HTheolin/Dinghy_old/D7039E och E7025E/Hårdvara/Schematics-Layouts/roder_dipswitch_config.jpg

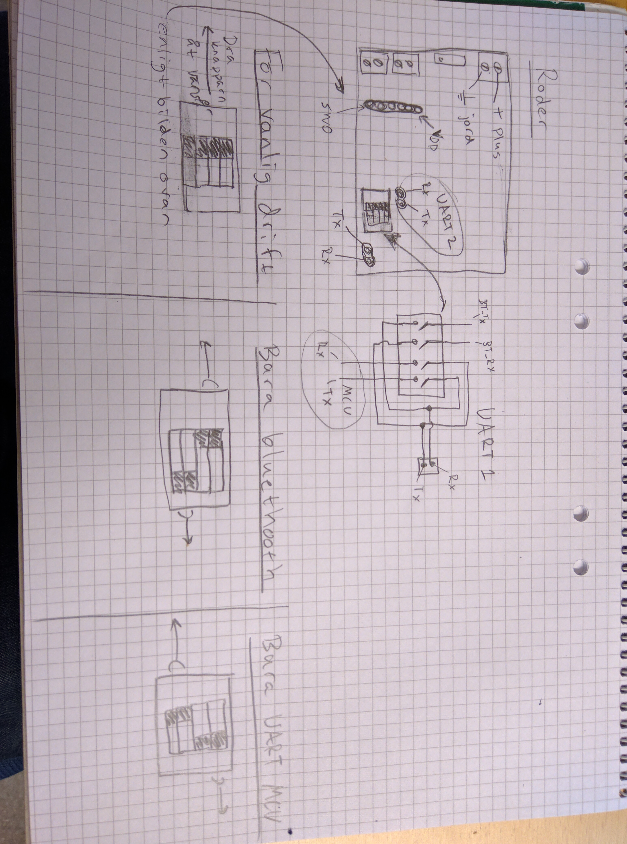
D7039E och E7025E/Hårdvara/Schematics-Layouts/roder_dipswitch_config.jpg
