HTheolin/Dinghy_old/D7039E och E7025E/Dokumentation/Moddeller och UML/Android/IMG_0293.JPG

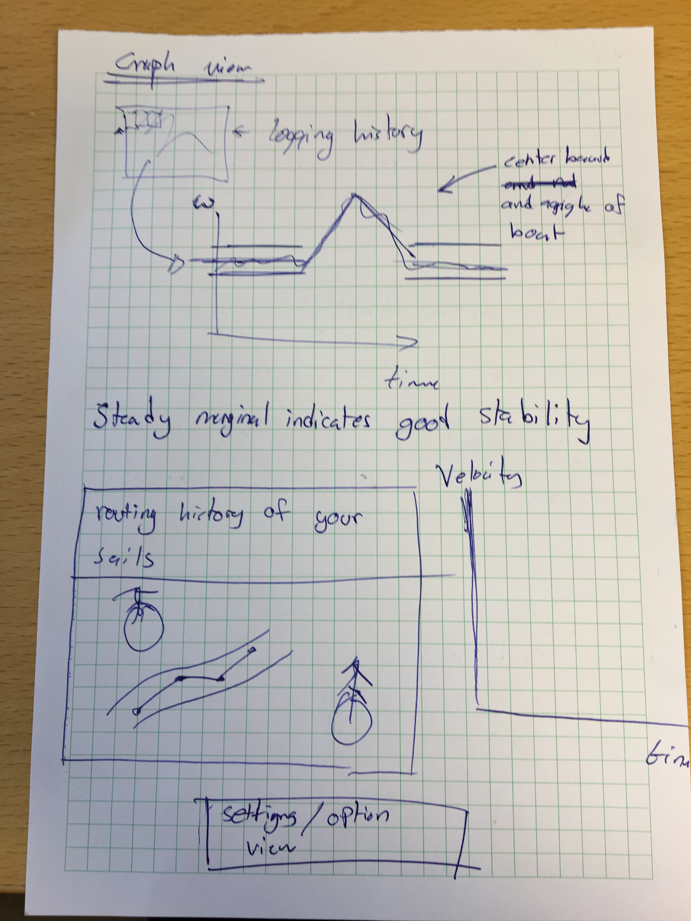
D7039E och E7025E/Dokumentation/Moddeller och UML/Android/IMG_0293.JPG
