HTheolin/Dinghy_old/D7039E och E7025E/Hårdvara/Schematics-Layouts/Pin description MCU/Prototype 2/Mainboard PROTOTYP2 Pinbeskrivnin.docx

OBSERVERA!!!

Ström switch On/Off har följande polaritet:

- Fotosensor / Strain gauge / Pressure sensor

GPIO hög (1) stänger AV strömmen

GPIO låg (0) slår PÅ strömmen

- Batterimätning

GPIO hög (1) slår PÅ strömmen

GPIO låg (0) stänger AV strömmen

Bluetooth / IMU sparar ström genom en intern sleep funktion så dom har ej någon power supply

Switch som går att slå på/av via GPIO output.

PA

PA2 - USART2_TX

Bluetooth2 RX kopplat till detta

PA3 - USART2_RX

Bluetooth2 TX kopplat till detta

PA4 - SPI1_NSS

slave select

PA5 - SPI1_SCK

spi klocka

PA6 - SPI1_MISO

Master (MCU) input, Slave (IMU) output

PA7 - SPI1_MOSI

Master (MCU) output, Slave (IMU) input

PA8 - GPIO_Input

Avläsning av connection status för bluetooth modul 1

PA9 - USART1_TX

Bluetooth1 RX kopplat till detta

PA10 - USART1_RX

Bluetooth1 TX kopplat till detta

PA11 - USART6_TX

GPS RX kopplat till detta

PA12 - USART6_RX

GPS TX kopplat till detta

PA13 - SWDIO

…

PA14 - SWCLK

…

PB

PB0 - ADC1_IN8

Optosensor 2 diod felmätning (open/short circuit)

PB1 - ADC1_IN9

Optosensor 2 transistor felmätning (open/short circuit)

PB2 - GPIO_Input

IMU kan skicka interrupt hit

PB3 - SWO

…

PB13 - GPIO_Output

GPS NRST pin

PB14 - GPIO_Output

GPS toggle pin

PB15 - GPIO_Output

On/Off switch till fotosensor kretsen

PC

PC0 - ADC1_IN10

ADC mätning av batteri spänningsnivåer

PC2 - GPIO_Output

Reset pin för bluetooth modul 2

PC3 - GPIO_Input

Avläsning av connection status för bluetooth modul 2

PC4 - ADC1_IN14

Optosensor 1 diod felmätning (open/short circuit)

PC5 - ADC1_IN15

Optosensor 1 transistor felmätning (open/short circuit)

PC6 - GPIO_Input

fotosensor 2 output mätning ( är antingen 0 eller 1 p.g.a komparator krets)

PC7 - GPIO_Input

fotosensor 1 output mätning ( är antingen 0 eller 1 p.g.a komparator krets)

PC8 - GPIO_Output

On/Off switch till mätning av batteri spännings nivå

PC9 - GPIO_Output

Reset pin för bluetooth modul 1

PC10 - GPIO_Output

Röd LED för användning till debugging eller dylikt

PC11 - GPIO_Output //GUL!

Grön LED för användning till debugging eller dylikt

PC12 - GPIO_Output

Yellow LED för användning till debugging eller dylikt
