HTheolin/Dinghy_old/D7039E och E7025E/Hårdvara/Schematics-Layouts/Pin description MCU/Prototype 2/Prototype 2 centerboard pindescription.docx

OBSERVERA!!!

Ström switch On/Off har följande polaritet:

- Fotosensor / Strain gauge

GPIO hög (1) stänger AV strömmen

GPIO låg (0) slår PÅ strömmen

- Batterimätning / Pressure sensor

GPIO hög (1) slår PÅ strömmen

GPIO låg (0) stänger AV strömmen

Bluetooth / IMU sparar ström genom en intern sleep funktion så dom har ej någon power supply

Switch som går att slå på/av via GPIO output.

Pin description för centerboard

PA

PA0 - ADC1_IN0

Pressure sensor

PA1 - GPIO_Output

Pressure sensor ON/OFF

PA2 - USART2_TX

PA3 - USART2_RX

PA4 - ADC1_IN4

Supply voltage for pressure sensor measurement

PA5 - TIM2_CH1 (input capture)

Ultrasonic capture signal

PA8 - GPIO_Input

Avläsning av connection status för bluetooth modul 1

PA9 - USART1_TX

Bluetooth1 RX kopplat till detta

PA10 - USART1_RX

Bluetooth1 TX kopplat till detta

PA13 - SWDIO

…

PA14 - SWCLK

…

PB

PB0 - GPIO_Output

Led 1

PB1 - GPIO_Output

Led 2

PB2 - GPIO_Output

Led 3

PB3 - SWO

…

PB10 - TIM2_CH3 (output)

Ultrasonic sensor output PWM

PC

PC0 - ADC1_IN10

ADC mätning av batteri spänningsnivåer

PC1 - GPIO_Output

Batterimätning ON/OFF

PC9 - GPIO_Output

Reset pin för bluetooth modul 1
