HTheolin/Dinghy_old/D7039E och E7025E/Hårdvara/Schematics-Layouts/Pin description MCU/Prototype 2/Prototype 2 rudderboard pindescription.docx

C OBSERVERA!!!

Ström switch On/Off har följande polaritet:

- Strain gauge

GPIO hög (1) stänger AV strömmen

GPIO låg (0) slår PÅ strömmen

- Batterimätning

GPIO hög (1) slår PÅ strömmen

GPIO låg (0) stänger AV strömmen

Bluetooth / IMU sparar ström genom en intern sleep funktion så dom har ej någon power supply

Switch som går att slå på/av via GPIO output.

Pin description för centerboard

PA

PA2 - USART2_TX

PA3 - USART2_RX

PA6 - ADC1_IN6

ADC mätning av Strain gauge

PA7 - ADC1_IN7

ADC mätning av Open/short circuit för strain gauge

PA8 - GPIO_Input

Avläsning av connection status för bluetooth modul 1

PA9 - USART1_TX

Bluetooth1 RX kopplat till detta

PA10 - USART1_RX

Bluetooth1 TX kopplat till detta

PA13 - SWDIO

…

PA14 - SWCLK

…

PB

PB0 - GPIO_Output

Led 1

PB1 - GPIO_Output

Led 2

PB2 - GPIO_Output

Led 3

PB3 - SWO

…

PC

PC0 - ADC1_IN10

ADC mätning av batteri spänningsnivåer

PC1 - GPIO_Output

Batterimätning ON/OFF

PC2 - GPIO_Output

Strain gauge ON/OFF

PC9 - GPIO_Output

Reset pin för bluetooth modul 1
