HTheolin/Dinghy_old/D7039E och E7025E/Hårdvara/GPS INIT.docx

HAL_GPIO_WritePin(GPIOB, GPIO_PIN_14, GPIO_PIN_RESET);

//Configure GPIO pin : PB14

GPIO_InitStruct.Pin = GPIO_PIN_14;

GPIO_InitStruct.Mode = GPIO_MODE_OUTPUT_PP;

GPIO_InitStruct.Pull = GPIO_PULLDOWN;

GPIO_InitStruct.Speed = GPIO_SPEED_FREQ_LOW;

HAL_GPIO_Init(GPIOB, &GPIO_InitStruct);

HAL_GPIO_WritePin(GPIOB, GPIO_PIN_13, GPIO_PIN_SET);

HAL_Delay(1000);

HAL_GPIO_WritePin(GPIOB, GPIO_PIN_13, GPIO_PIN_RESET);

HAL_GPIO_WritePin(GPIOB, GPIO_PIN_14, GPIO_PIN_SET);

HAL_Delay(200);

HAL_GPIO_WritePin(GPIOB, GPIO_PIN_14, GPIO_PIN_RESET);

HAL_Delay(1000);
