HTheolin/Dinghy_old/D7039E och E7025E/Hårdvara/Research om BT (jesper).docx

Val av modul:

* RN42N-I/RM (utan antenn)

http://se.farnell.com/microchip/rn42n-i-rm/module-bluetooth-class-2/dp/2143324

* RN42-I/RM (med antenn)

http://se.farnell.com/microchip/rn42-i-rm/module-bluetooth-class-2-w-ant/dp/2143310

Strömförbruking per datablad: 26 uA sleep, 3 mA connected, 30 mA transmit med supply voltage vcc på 3.3 V.

Användbara länkar:

https://learn.sparkfun.com/tutorials/bluetooth-basics/how-bluetooth-works

Vårt system kommer mest troligt arbeta med en smartphone som master och bakrodret och mellanrodret som slavar. Enligt datablad så klarar den av en SPP data transfer rate på 240 Kbps (slav), 300 Kbps (master).
