HTheolin/Dinghy_old/D7039E och E7025E/Hårdvara/Untitled document.docx

LÖDNINGS INFORMATION:

RN42:

Temp 230 C i 30-40 sec. Max 250 C

Preheat temp 165 +- 15C i 90 till 120 sec

SINGLE PASS

MCU:

??? Säger att den är compliant med JEDEC stD J-STD-020D

IMU:

JEDEC std J-std-020 standard, klarar 3 sekventiella reflow passes.

LM1117:

???
