HTheolin/Dinghy_old/D7039E och E7025E/Dokumentation/Presentation/16-09-01.pptx

## Dinghy

Mattias, Niklas, David, Fredrik, Jesper, Alexander, Björn

## Vad ska vi göra?

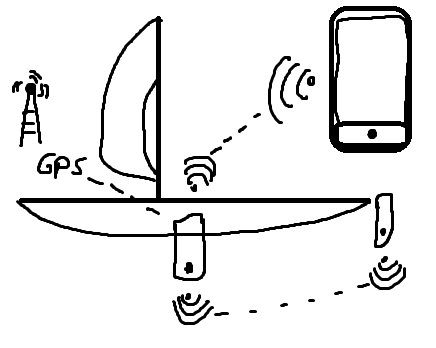
[picture p3: figure]

## Responsibility

- Sensors
  - Fredrik
- Position and Orientation
  - David
- Component Communication
  - Jesper

- Real-time feedback
  - Niklas
- Application
  - Alexander
- Logging and statistics
  - Mattias
- Energy
  - Björn

## Position and Orientation

- Differential GPS for increased accuracy
- IMU for inclination

## Sensors

- Pressure sensor for centerboard (and rudder)
- Ultrasonic sensor for height of centerboard
- waterproof solutions for mounting sensors

## Components and Communication

- Mainboard + sensor boards
- Processor STM32F401 all boards
- Bluetooth (RN42)

Notes: Mainboard med IMU och höjdsensor, sensor boards med trycksensorer
Processor STM32F401 har funktionalitet som behövs samt det finns erfarenhet med utveckling på denna.RN42 bluetooth modul är vanlig och har funnits på marknaden ett tag så support dokumentation finns.
Dgps är oklart om hur man skall lösa denna.
Blueooth mellan alla boards samt smartphone

## Application

- Android application
  - Most phones and tablets use android
  - Easy development and testing
- Boat status
  - Velocity
  - Position
  - Forces
  - Performance
  - Warnings
- Feedback
  - Visible
  - Intuitive

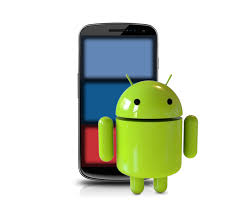
[picture p4: figure]
Image result for android app

## Real-time feedback

- Interviews on what sort of feedback would be applicable
- Physics of sailing
- Interpretation of data from sensor
- Produce applicable feedback
  - “Burka” (hiking)
  - Centerboard
  - Rudder
  - Haul sail
  - Bear off
  - Head up

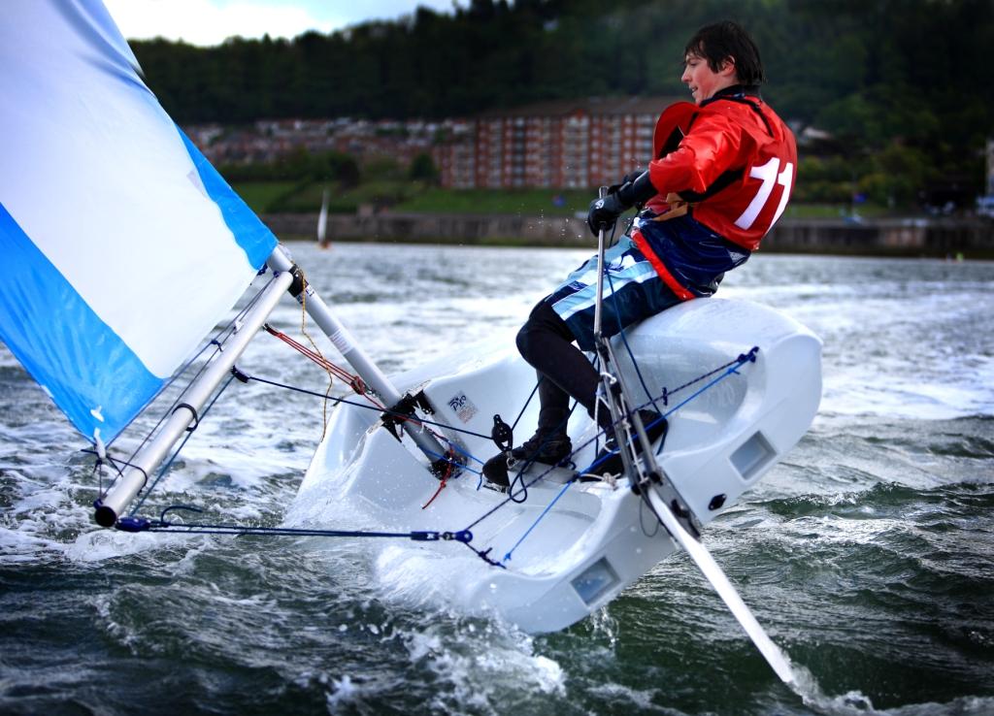
[picture p5: figure]
Image result for pico laser

## Logging and statistics

- Logging on smartphone
- Statistic view in app
- Transfer to pc

## Energy

- Deep-sleep mode
- Power gating of components
- Energy efficient components
- Low polling rate
- Battery size
- Estimated battery life left
- Power switches
