HTheolin/Dinghy_old/D7039E och E7025E/Dokumentation/Presentation/16-09-08.pptx

## Dinghy

Mattias, Niklas, David, Fredrik, Jesper, Alexander, Björn

## Hur ser systemet ut?

## Sensor Node Main Board

## Responsibility

- Sensors
  - Fredrik
- Position and Orientation
  - David
- Component Communication
  - Jesper

- Real-time feedback
  - Niklas
- Application
  - Alexander
- Logging and statistics
  - Mattias
- Energy
  - Björn

## Position and Orientation

- ADIS16209 for inclination
- MEMS accelerometer
- SPI

## Sensors

- Pressure sensor for centerboard (and rudder)
- Strain gauges on centerboard
- Ultrasonic sensor for height of centerboard
- Optic sensor for measuring strips on centerboard
- waterproof solutions for mounting sensors

## Components and Communication

- RN42 bluetooth module (with antenna)
- Smartphone -> Mainboard -> Sensorboards
- UART
- Microcontroller STM32F401 suitable

Notes: Mainboard med IMU och höjdsensor, sensor boards med trycksensorer
Processor STM32F401 har funktionalitet som behövs samt det finns erfarenhet med utveckling på denna.RN42 bluetooth modul är vanlig och har funnits på marknaden ett tag så support dokumentation finns.
Dgps är oklart om hur man skall lösa denna.
Blueooth mellan alla boards samt smartphone

## Application

Done
- Main views are created
- Views have a planned UI
  - Feedback view and recordings
  - Performance margins,calendars, routing history

Image result for android app

## Application Ideas

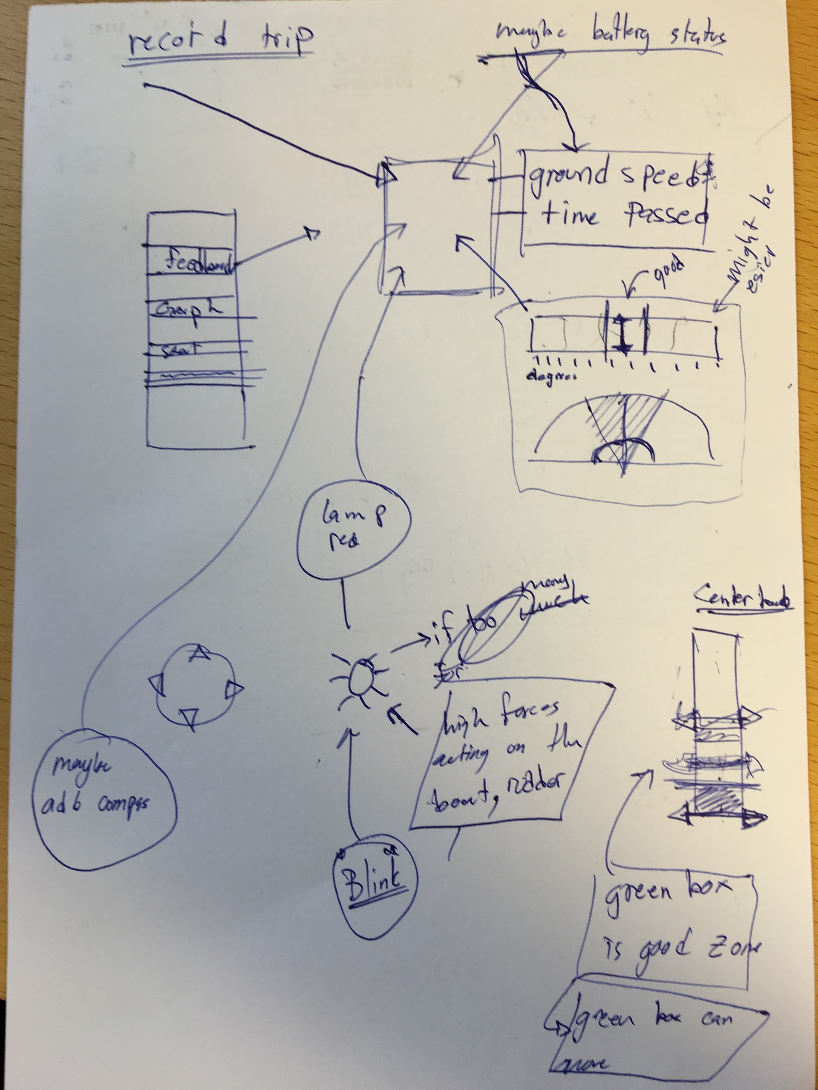
[picture p6: figure]
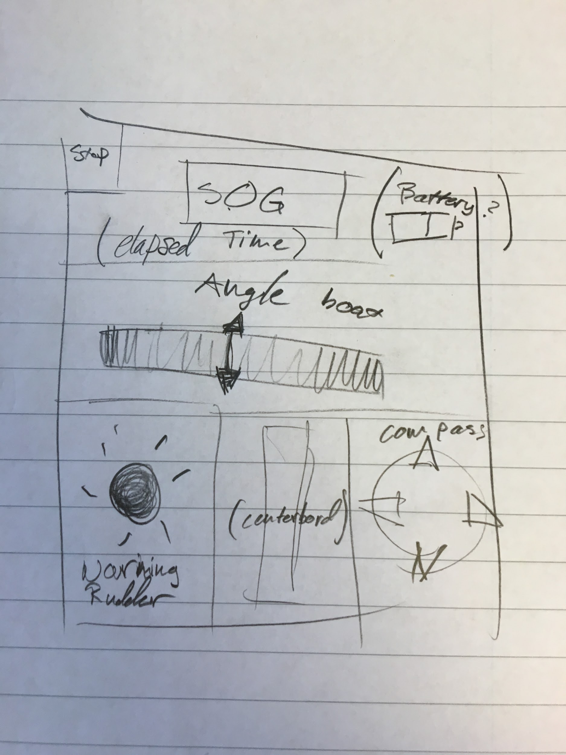
[picture p7: figure]
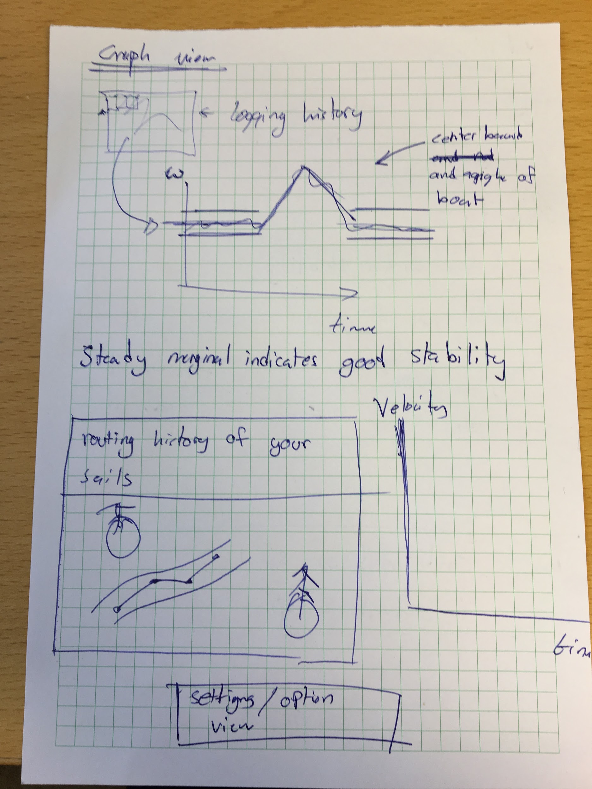
[picture p8: figure]

## Real-time feedback

- Been in touch with LSS
- Setting up other interviews for next week

Image result for pico laser

## Logging and statistics

- Binary files

- ( ( 4 + 1 + 3*2 + 2*4 + 4 ) * 2 *3600 ) * 45* 4 = 29,808,000 = 30mb/year
- ( ( p + h + gyro + gps + time ) * two times * 3600 ) * 45 days * 4 hours

- ASCII files are more complicated to optimize
- Can be many times larger than binary

## Energy

- Gating the clocks to the APBx and AHBx peripherals when they are unused.
- Reference counters for clockregisters
- Disable clock when clock users = 0
- Saves power
- Lower power when lower clocks

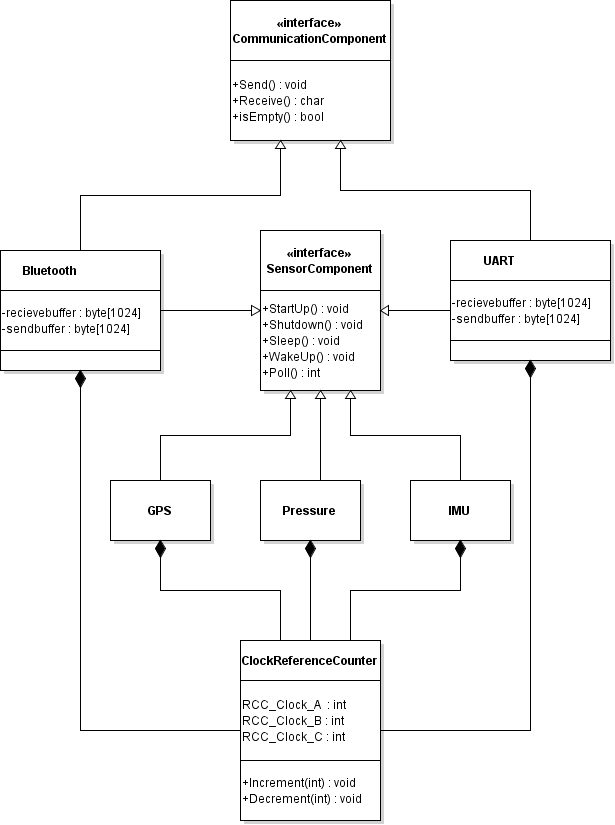
[picture p9: figure]
