HTheolin/Dinghy_old/D7039E och E7025E/Dokumentation/Presentation/16-10-06.pptx

## Dinghy

Mattias, Niklas, David, Fredrik, Jesper, Alexander, Björn

## Team Building

- Taco
- Singstar
- Shots
- Super smash
- Mario kart (alpha car confirmed)

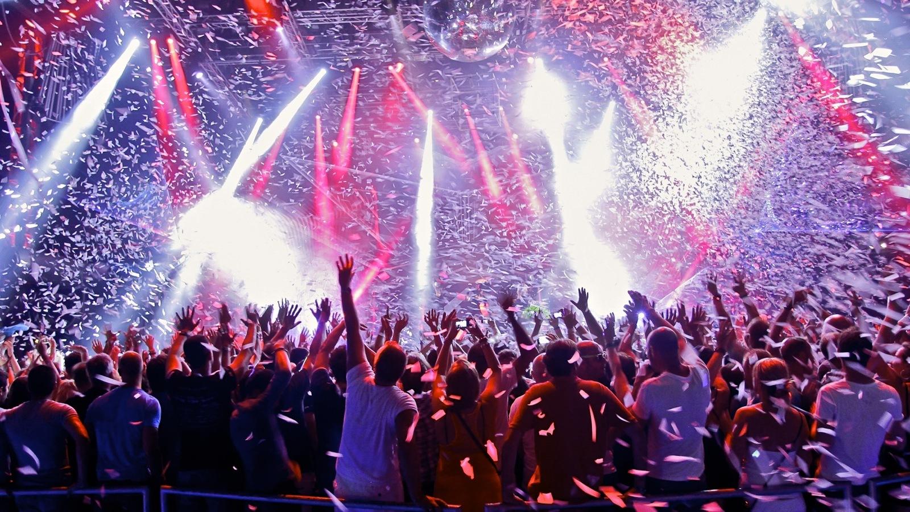
[picture p33: figure]

## Delays (not because of team building or hangovers)

- Report
- Waiting for order

## Requirements

Set by Jan
- Direction, bearing
- Speed over ground
- Inclination
- Angular Velocities
- Position(within 1 inch)
- Differential pressure over center board
- Dual Wireless Communication
- Feedback to skipper

Things we made up
- Vindsensor
- Log/statistics
- Feedback to skipper (extended)

## Groups

- Position
- Hardware
- Software

## FMEA

- FMEA (https://docs.google.com/a/ltu.se/spreadsheets/d/1686kgYUhL7neUKVXxldl-FFPmjOs6UU2VFcoX5eNrFQ/edit?usp=sharing)-link

## Positioning

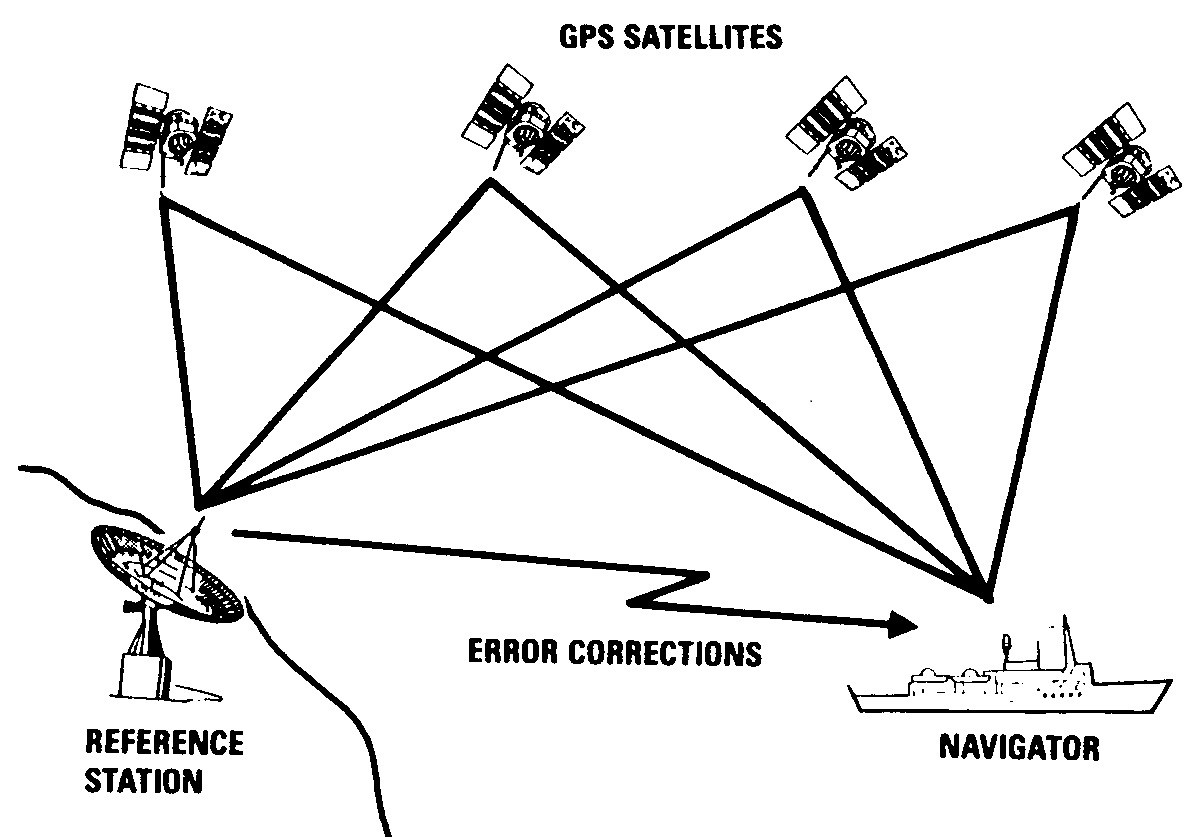
[picture p34: figure]
Image result for dgps

- Sensor fusion
  - DGPS+IMU
- Sjöfartsverket
  - Free to use
  - Reception
  - RTCM SC-104
- Extended Kalman Filter

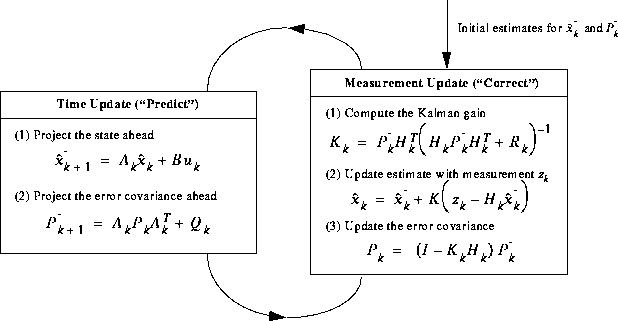
[picture p35: figure]
Image result for extended kalman filter

## Main board

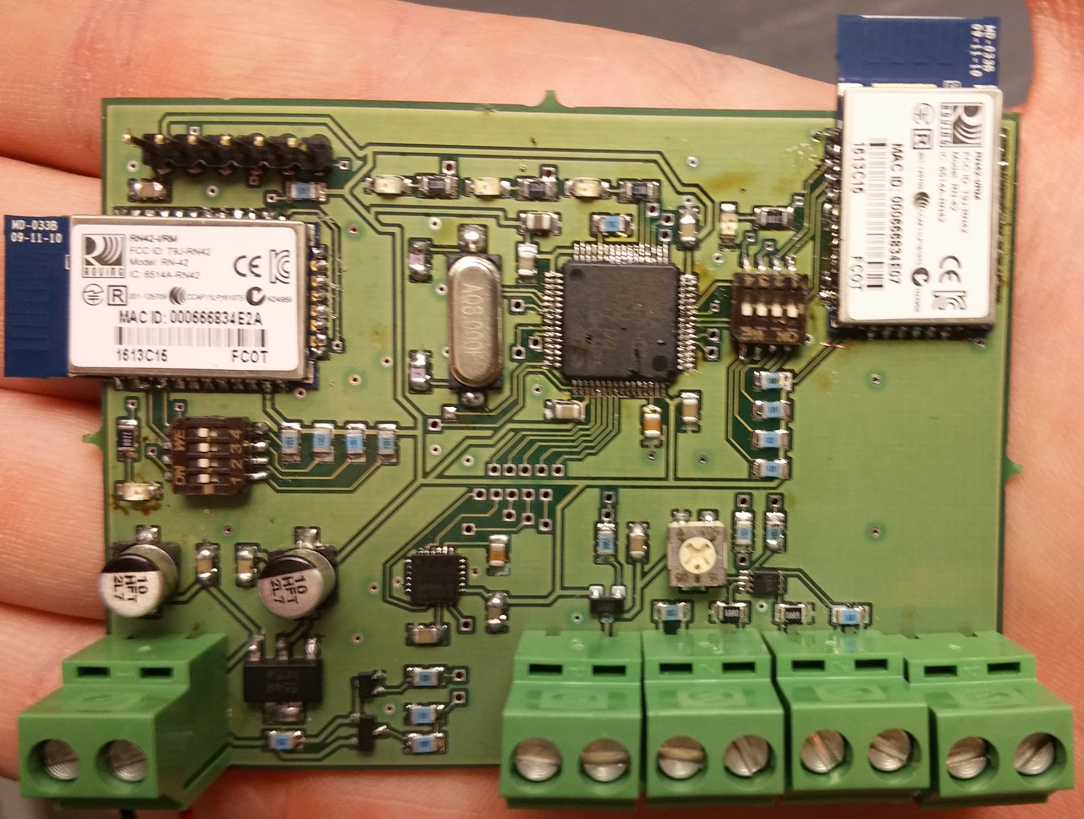
[picture p36: figure]

## Rudder

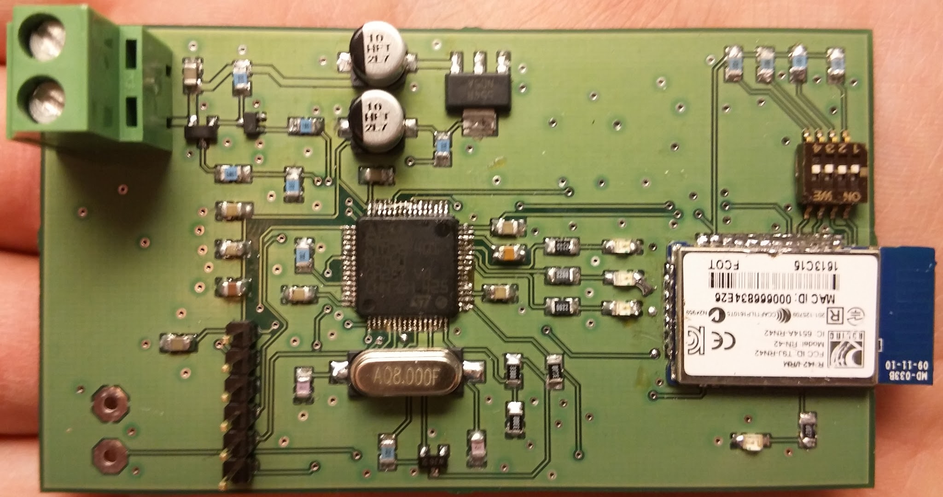
[picture p37: figure]

## Center

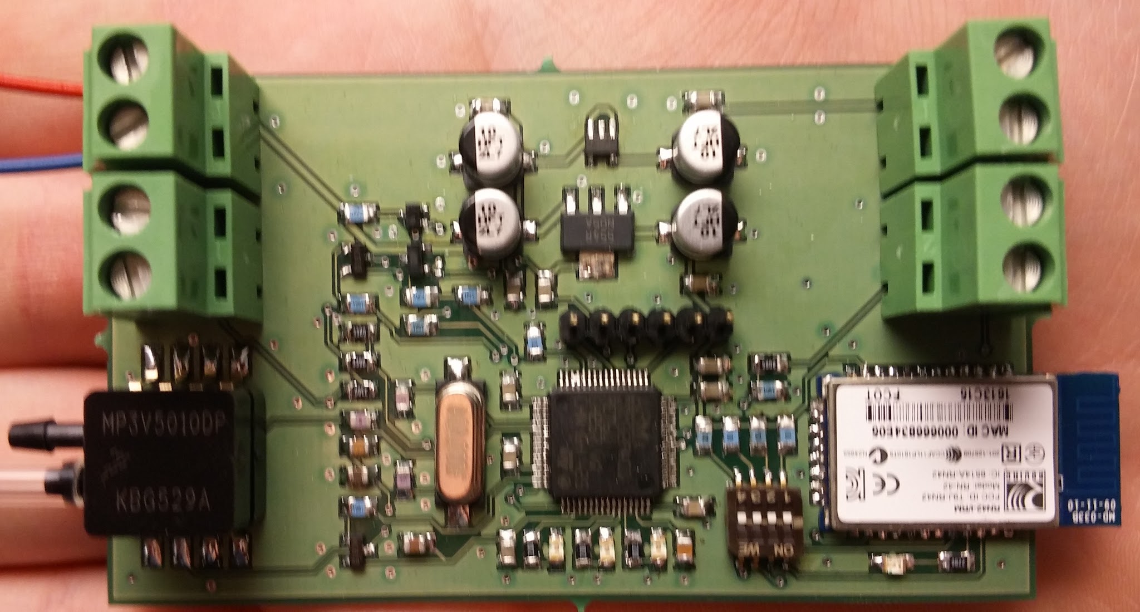
[picture p38: figure]

## Slide 11

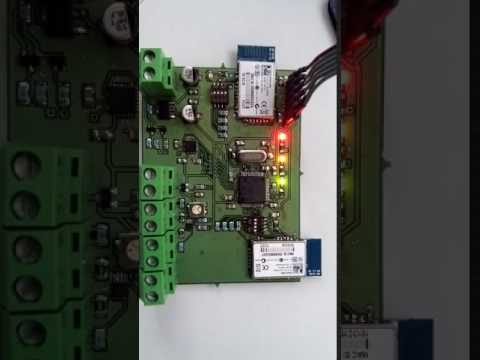
[picture p39: figure]
prototype 1 test

## Application

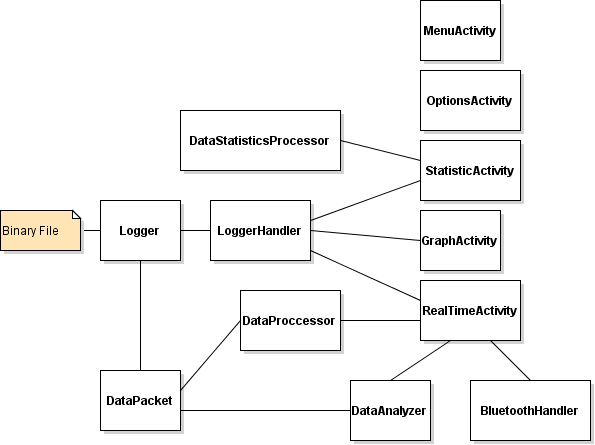
[picture p40: figure]
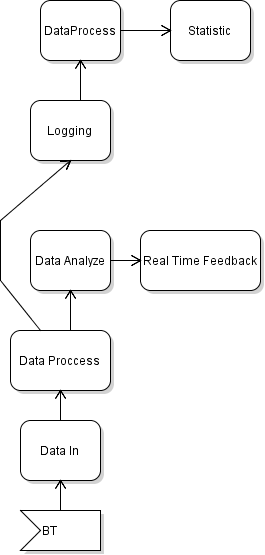
[picture p41: figure]

## Software - embedded

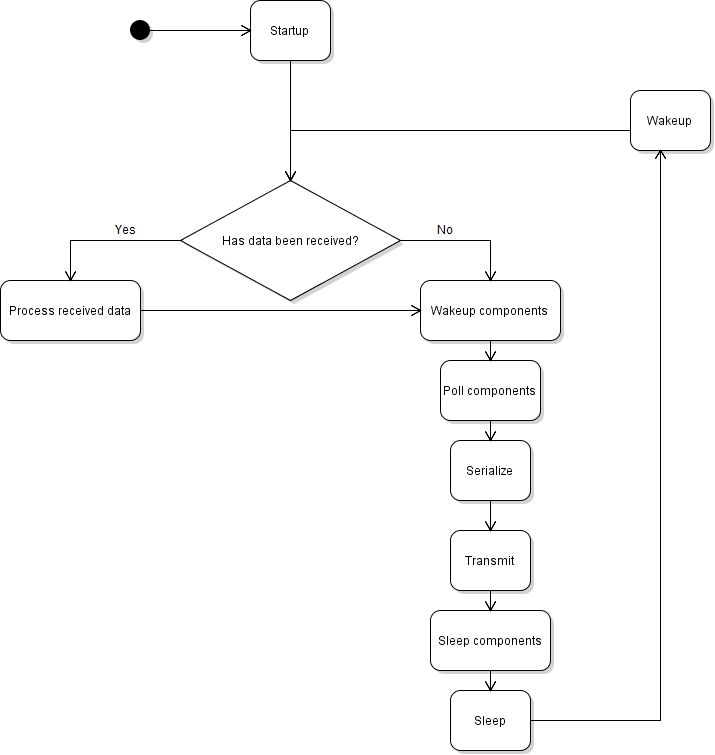
[picture p42: figure]

## Research

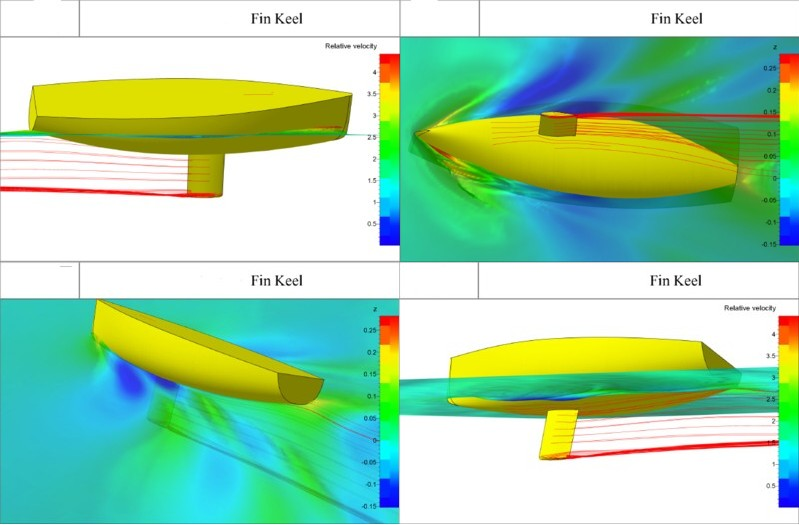
[picture p43: figure]

- Logic of pressure on Rudder and Centerboard is under development
  - Goal: Logic for all points of wind
- NMEA
  - Libs in C
  - Hard code which sentences to send to save energy
  - Alterations to next HW iteration?

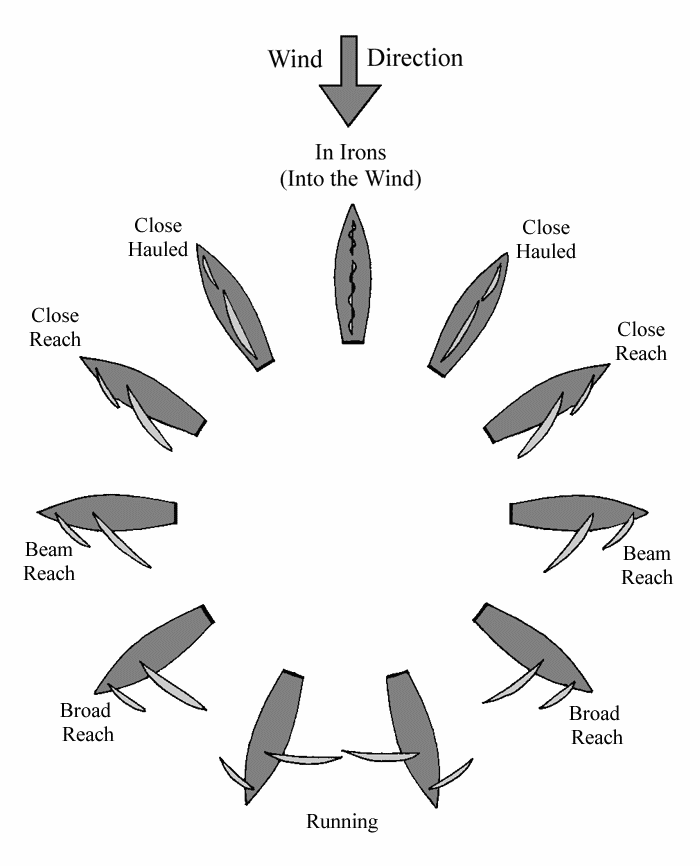
[picture p44: figure]
Bildresultat för wind directions sailing
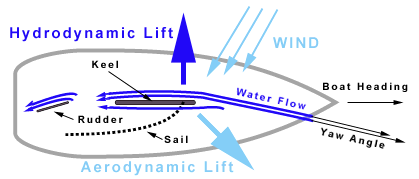
[picture p45: figure]
Bildresultat för lift aerodynamics sailing
