HTheolin/Dinghy_old/D7039E och E7025E/Dokumentation/Presentation/16-10-13.pptx

## Dinghy

Mattias, Niklas, David, Fredrik, Jesper, Alexander, Björn

## Requirements

- (1) Direction, bearing
- (1) Differential pressure across centreboard (rudder)
- (1) Log/statistic
- (2) Speed Over Ground
- (2) Angular Velocities
- (2) Position (within 1 inch)

- (3) Feedback to skipper (expand)
  - Start line
  - Route
  - Center board pos
  - Sail pos
- (4) Speed In Water
- (4) Inclinations
- (4) Wind Sensor

## Slide 3

## Testing of sensors Optical switch Changed a resistor value Comparator circuit also work Had to fix some solder bridges

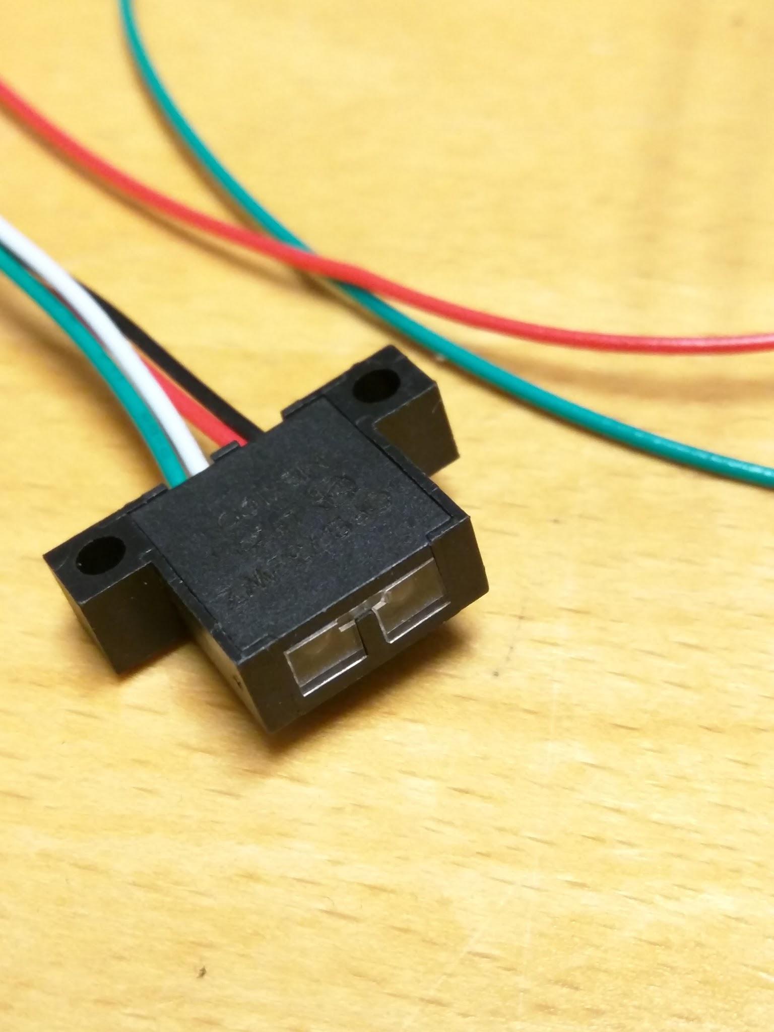
[picture p46: figure]

## Testing of sensors

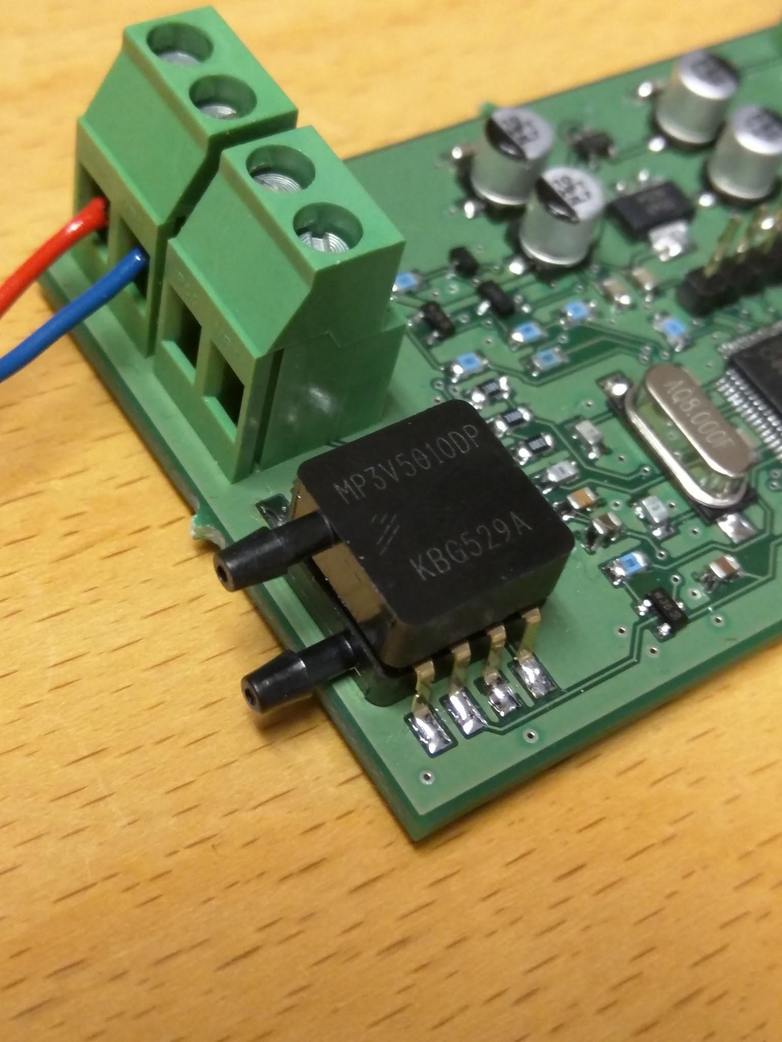
[picture p47: figure]

- Pressure sensor
  - Works
- 0-10 kPa (P1>P2)
  - Output 0.1-3.1 V

## Testing of sensors

- Strain gauge
  - Can’t measure atm too low voltage difference
- Needs an amplifier

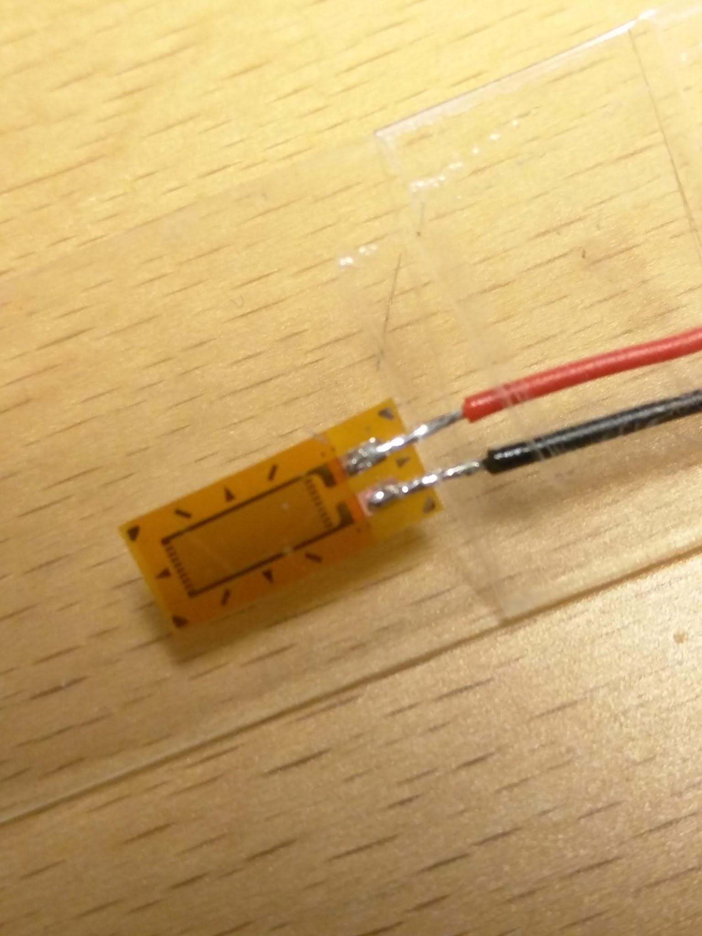
[picture p48: figure]

## Bluetooth

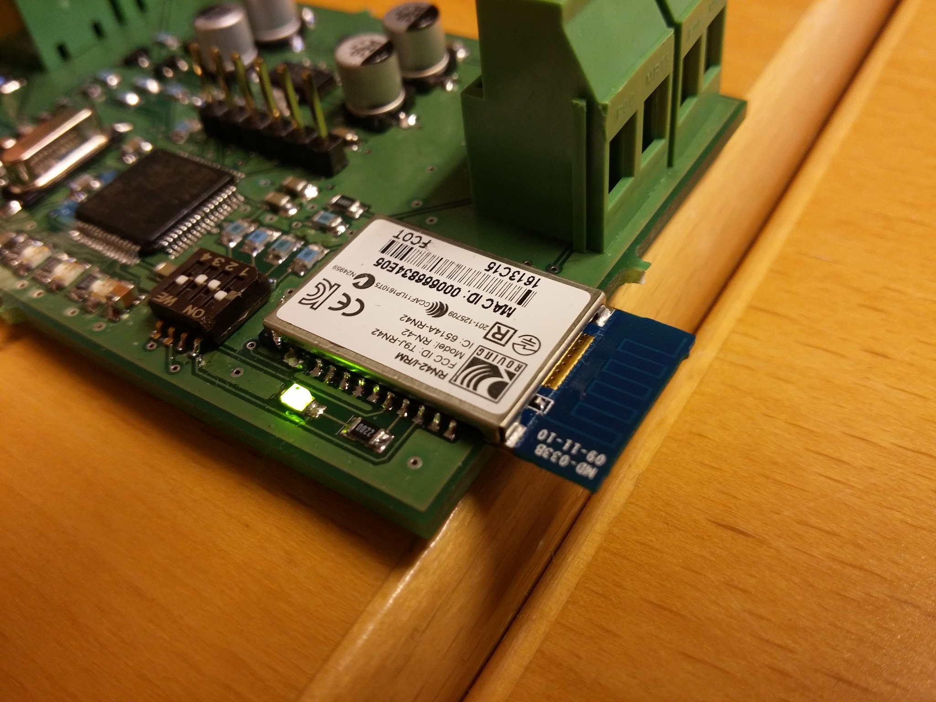
[picture p49: figure]

- Misaligned in the oven
  - Pads got damaged when removing the bluetooth
- Solder by hand next time

## Application


## Software - embedded


## Research


- Put on hold this week
- Focus put on coding

Bildresultat för wind directions sailing
Bildresultat för lift aerodynamics sailing
