HTheolin/Dinghy_old/D7039E och E7025E/Dokumentation/Presentation/16-10-21.pptx

## Dinghy Project

Mattias Kallsäby
Niklas Lundborg
David Ragnarsson
Fredrik Ödmark
Jesper Wälivaara
Alexander Örneskans
Björn Paulström

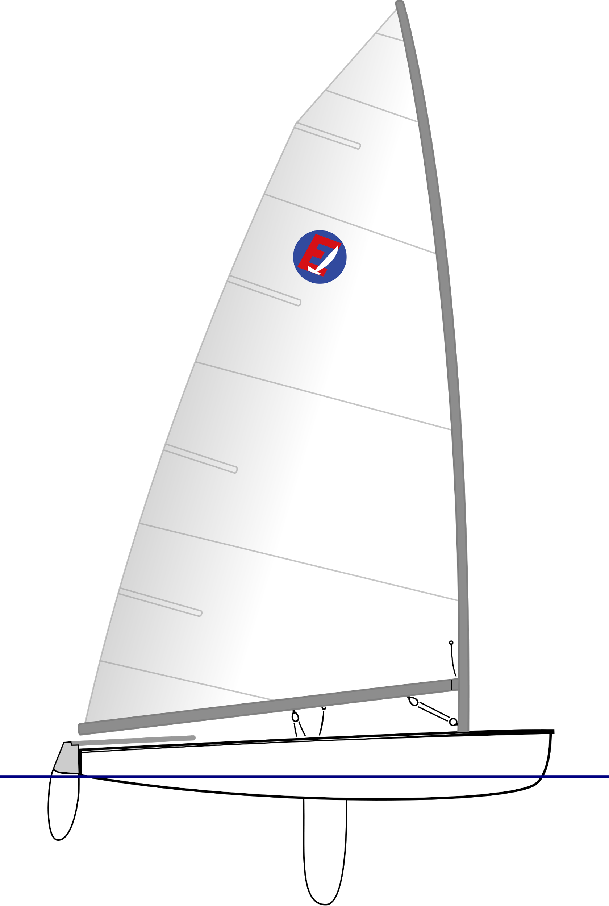
[picture p50: figure]

## Background Dinghy Project

- Sensors in the world of boats
- Wind, temperature, depth, speed in water, speed over ground

Bildresultat för lift aerodynamics sailing

## Primary Goals

- Differential pressure sensor
  - Hydrodynamic lift
- Bearing/Direction
- Logging

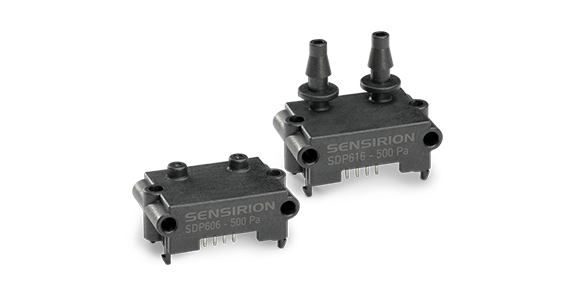
[picture p51: figure]

## Secondary Goals

- Speed over ground
- Angular Velocity
- Positioning

## Additional Goals

- Feedback to skipper (Human interface)
- Speed in water
- Inclination
- Windsensor (NMEA)

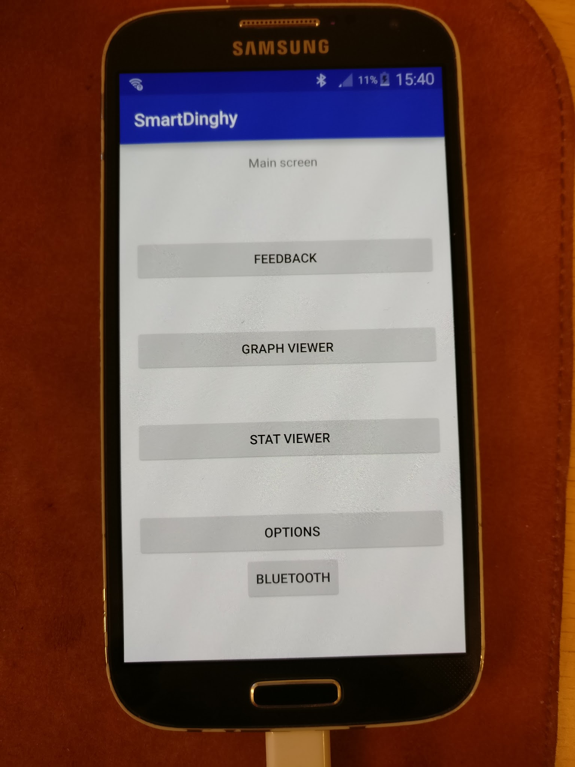
[picture p52: figure]

## System Overview

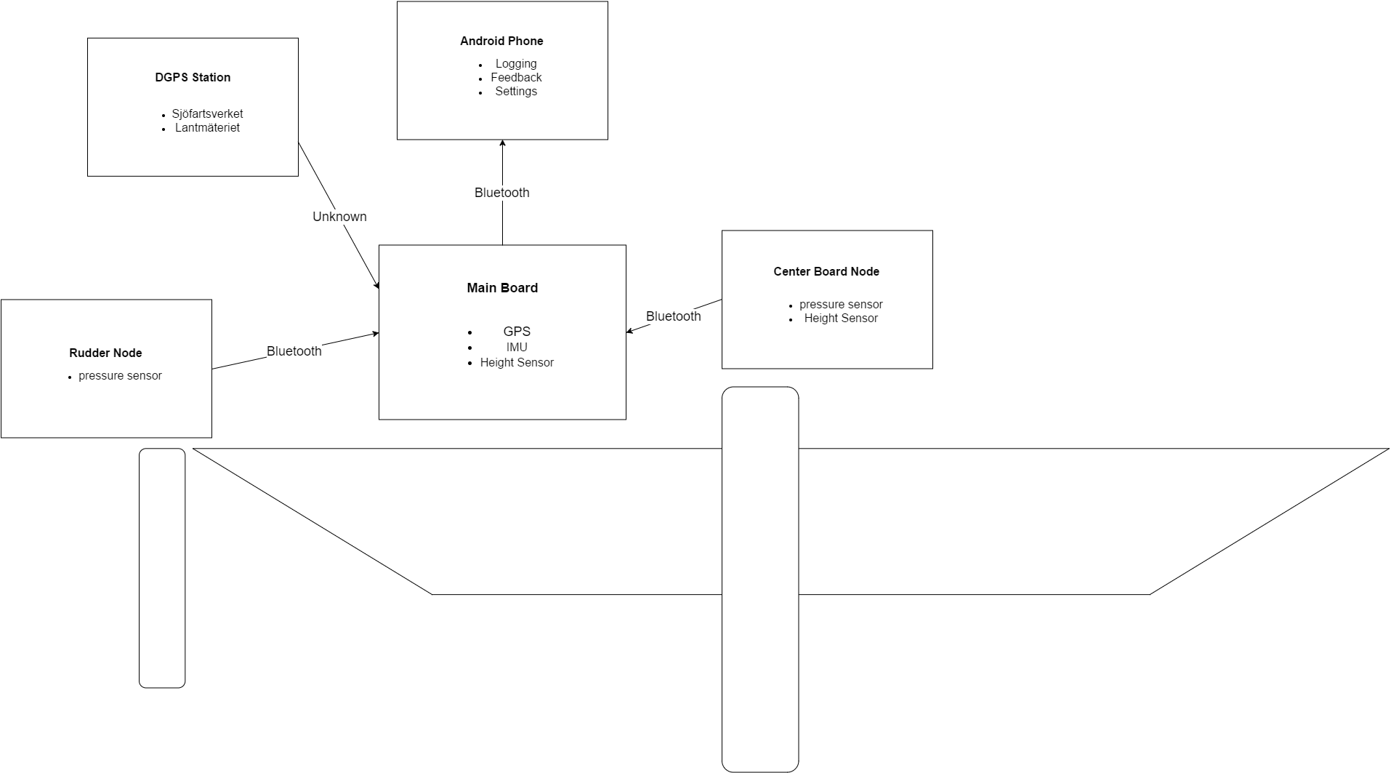
[picture p53: figure]

## Slide 7

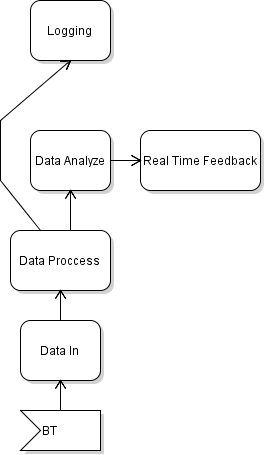
[picture p54: figure]
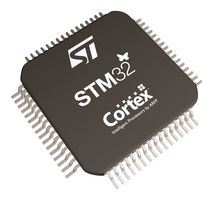
[picture p55: figure]
