HTheolin/Dinghy_old/D7039E och E7025E/Dokumentation/Presentation/16-11-18.pptx

## Dinghy

Mattias, Niklas, David, Fredrik, Jesper, Alexander, Björn

## Slide 2

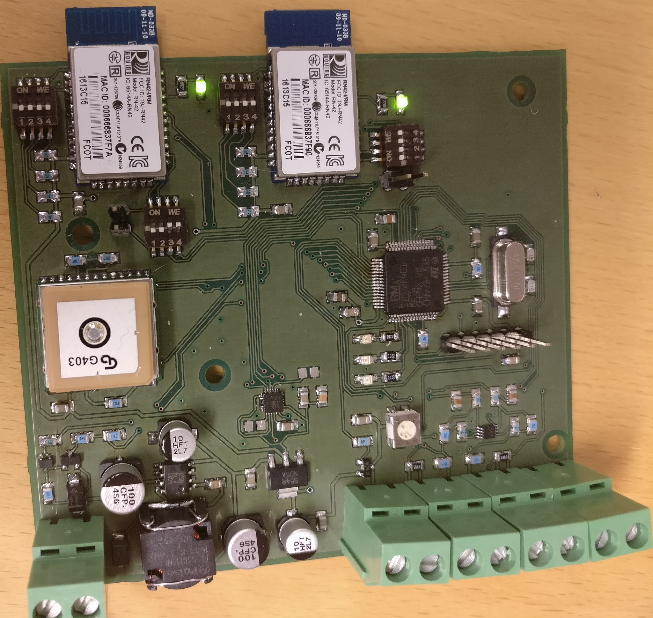
[picture p56: figure]

## Slide 3

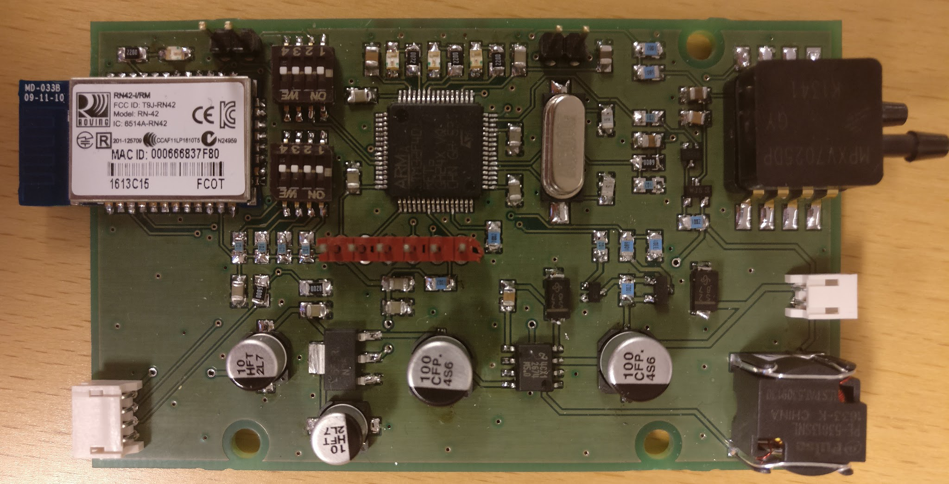
[picture p57: figure]

## Slide 4

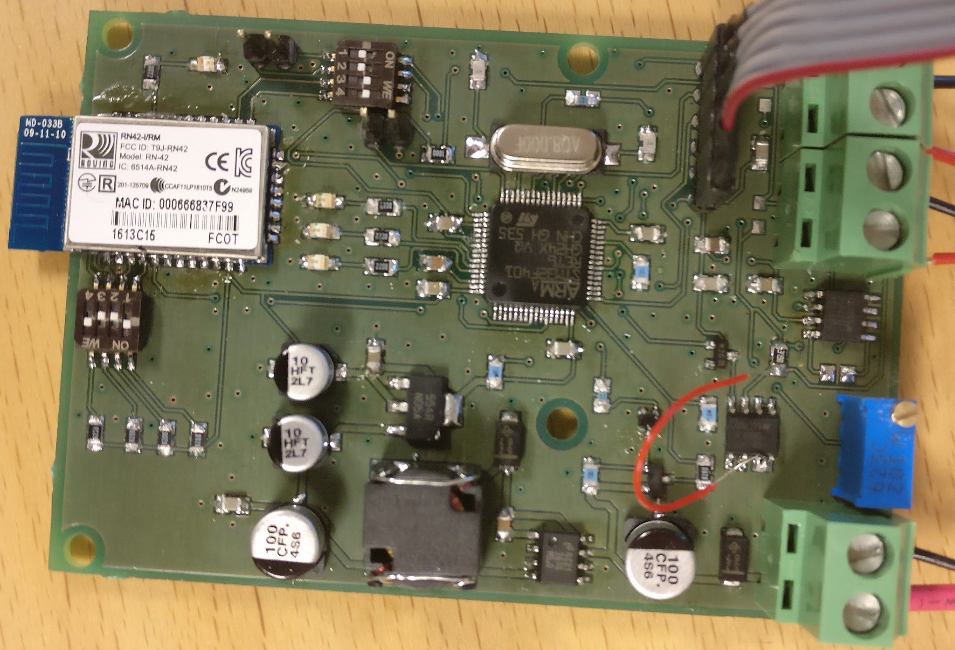
[picture p58: figure]

## Slide 5

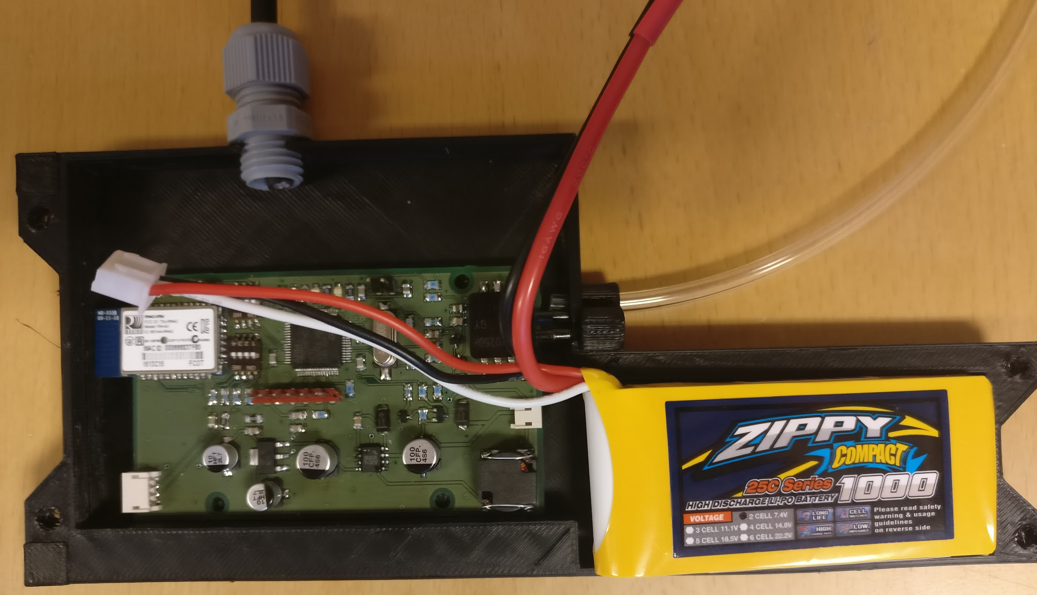
[picture p59: figure]

## Sensors and data

- Requirement
  - High accuracy positional data
- Low budget sensor tend to be noisy
  - Data isn't representative of actual recorded situation
  - Data may be unusable and thus analysis is hard

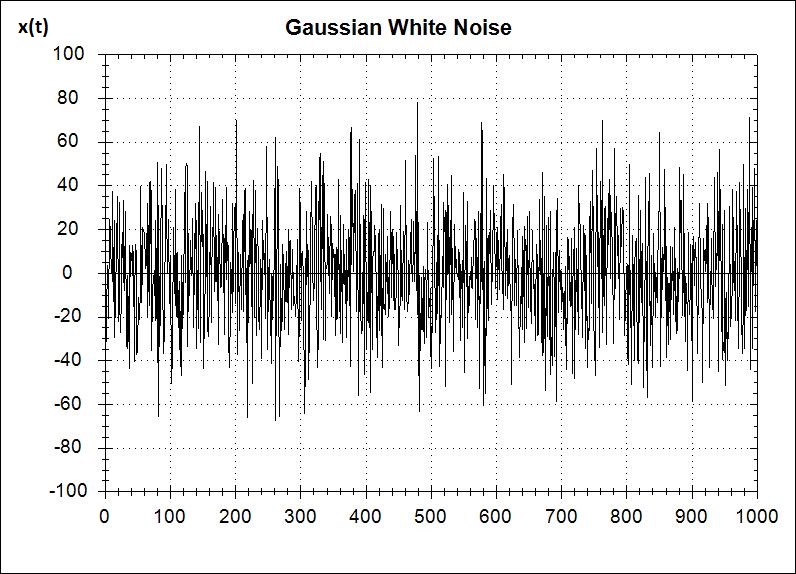
[picture p60: figure]

## Extended Kalman Filter

- EKF
  - Takes series of input data with uncertainties
  - Outputs in most cases better data with removed uncertainties
- Sensor fusion
  - Combines sensors
  - Outputs data that is better than it would be if there was only one sensor used

## EKF

- A EKF was tested in matlab with simulated horizontal motion
- A lot of tuning and tweaking made this filter decent
- Estimate in position (x-axis)
    - 2.5 meter variance
    - Reduced to 0.79m
    - Error reduced by 68%
    - Sensor fusion between
      - GPS
      - Accelerometer

## Slide 9

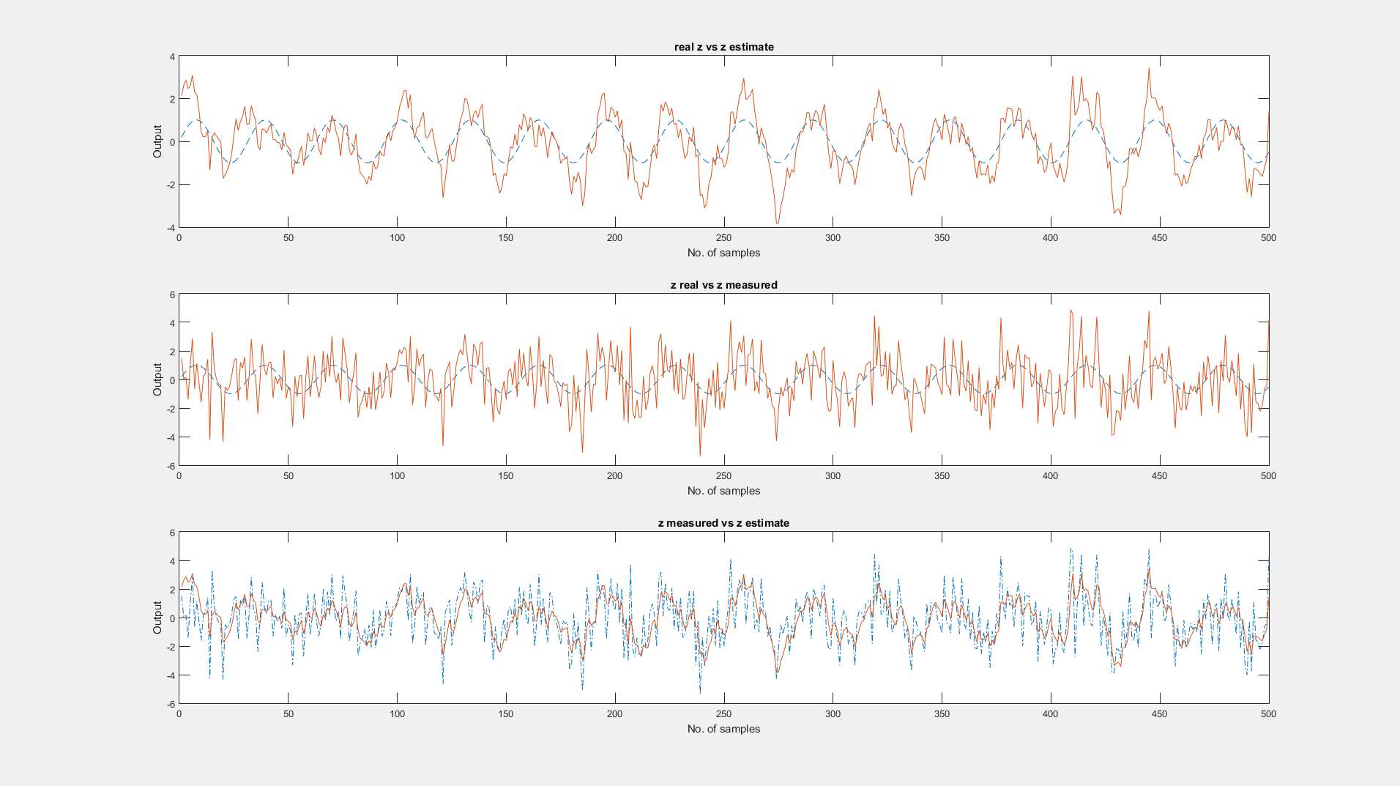
[picture p61: figure]

## TODO side by side comparison

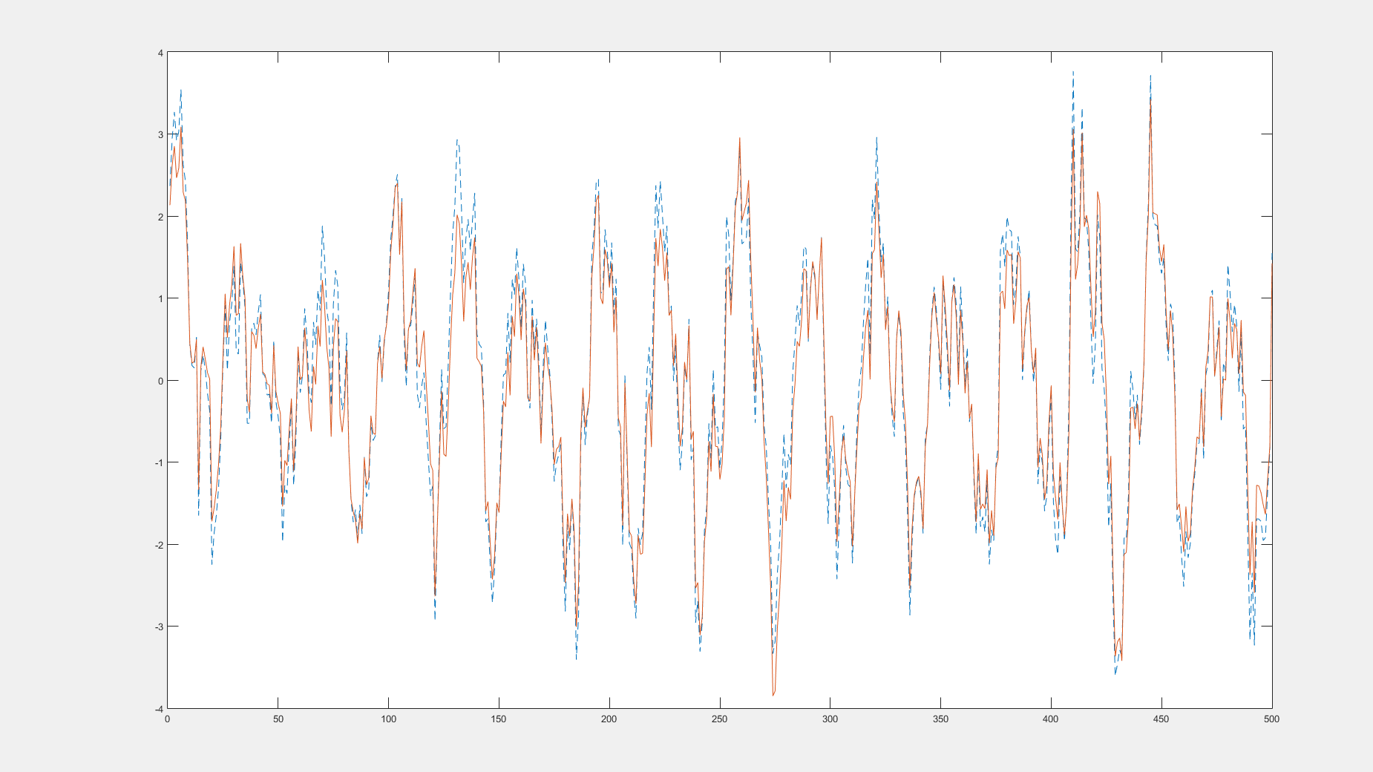
[picture p62: figure]

## The Last Slide about the EKF

- What is the graphical difference between no sensor fusion and sensor fusion?
  - Might not seem so much
  - Error difference between 0.79m and 0.98m

## Slide 12

## Software - embedded

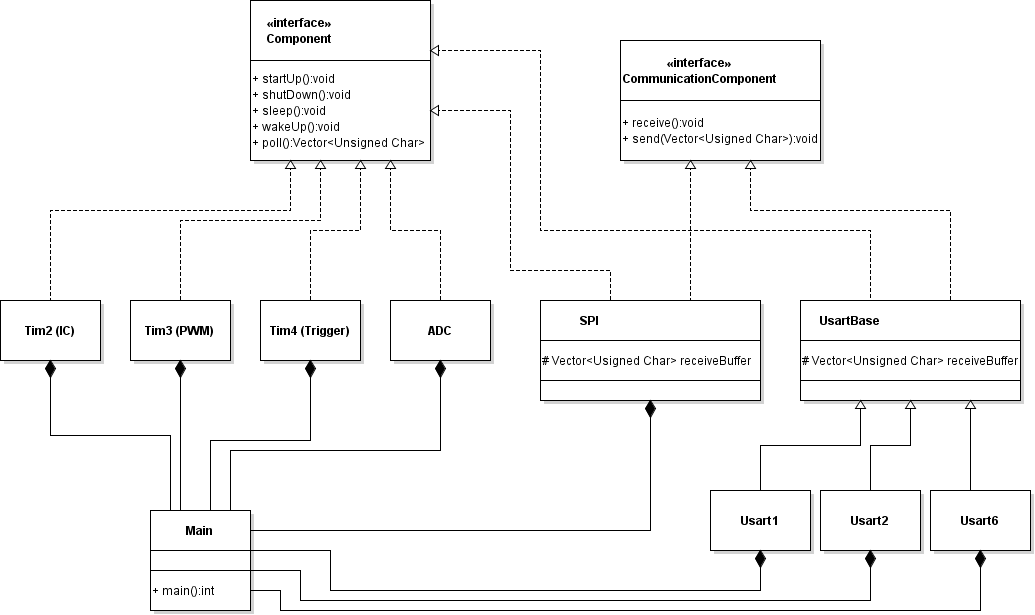
[picture p63: figure]

- ADC now working!
  - Multichannel achieved with DMA implementation
- Creating protocols for different BT modules
  - Established connection between two modules
  - Converting manual commands into separate protocols
- Packed all data into single vector for polling
- IMU
  - Still working on it...

## Bluetooth Demo

## Android

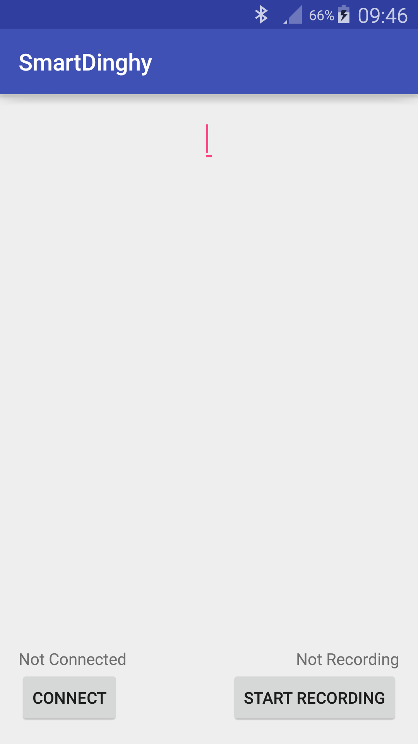
[picture p64: figure]

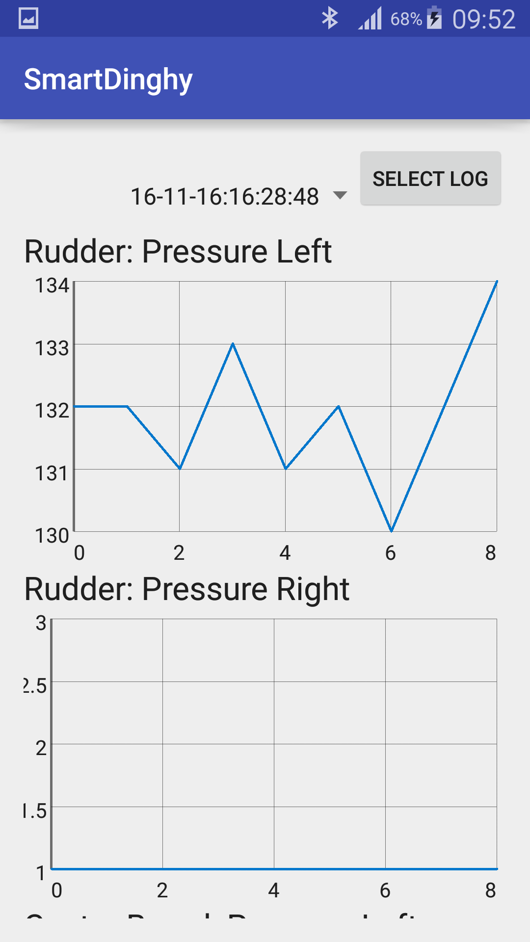
[picture p65: figure]
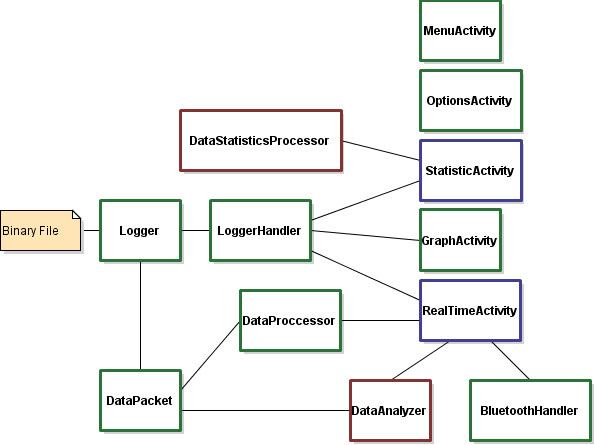
[picture p66: figure]
AndroidUML.2.0
