HTheolin/Dinghy_old/D7039E och E7025E/Dokumentation/Bilder Hårdvara/Förstärkarkrets.png

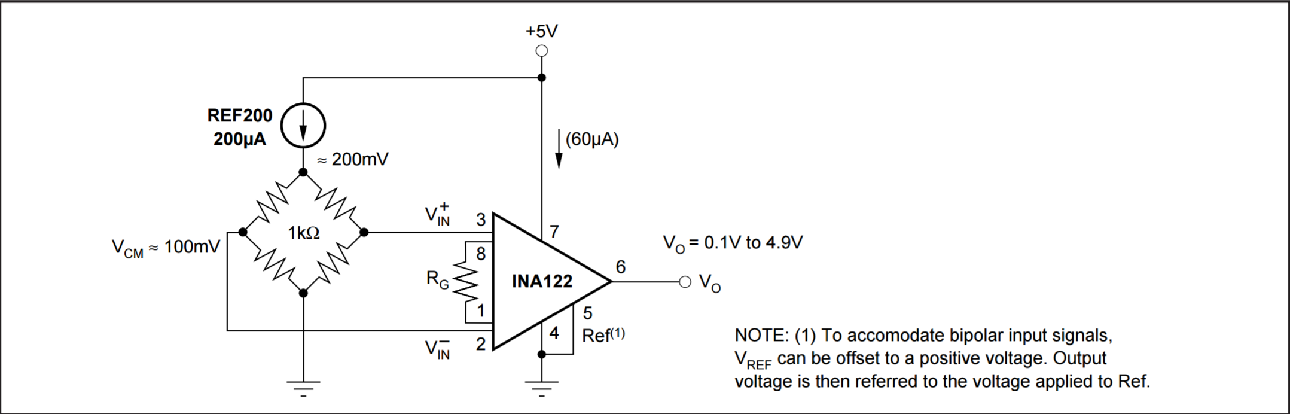
D7039E och E7025E/Dokumentation/Bilder Hårdvara/Förstärkarkrets.png
