HTheolin/Dinghy_old/D7039E och E7025E/Dokumentation/Bilder Hårdvara/Prototype 2/20161108_1033834.jpg

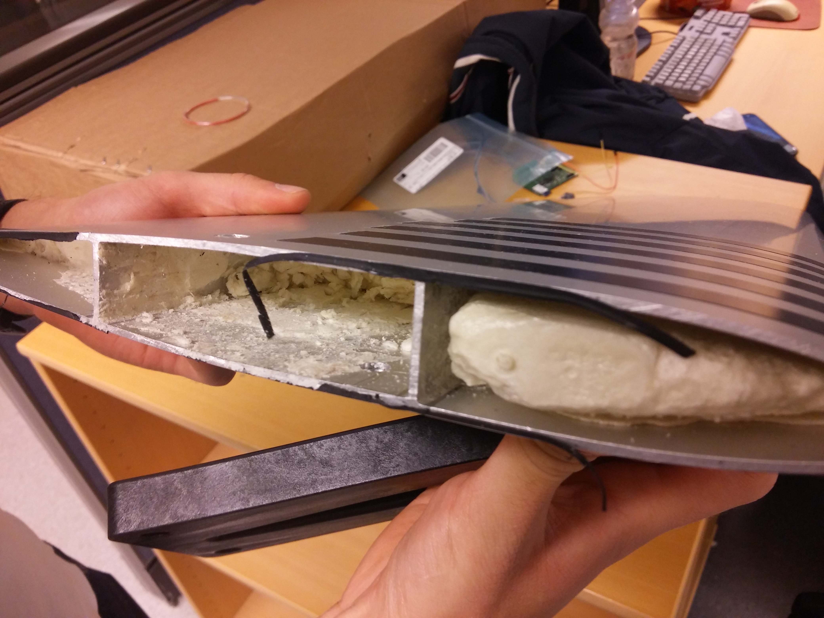
D7039E och E7025E/Dokumentation/Bilder Hårdvara/Prototype 2/20161108_1033834.jpg
