HTheolin/Dinghy_old/D7039E och E7025E/Dokumentation/Bilder Hårdvara/Prototype 2/20161108_1043406.jpg

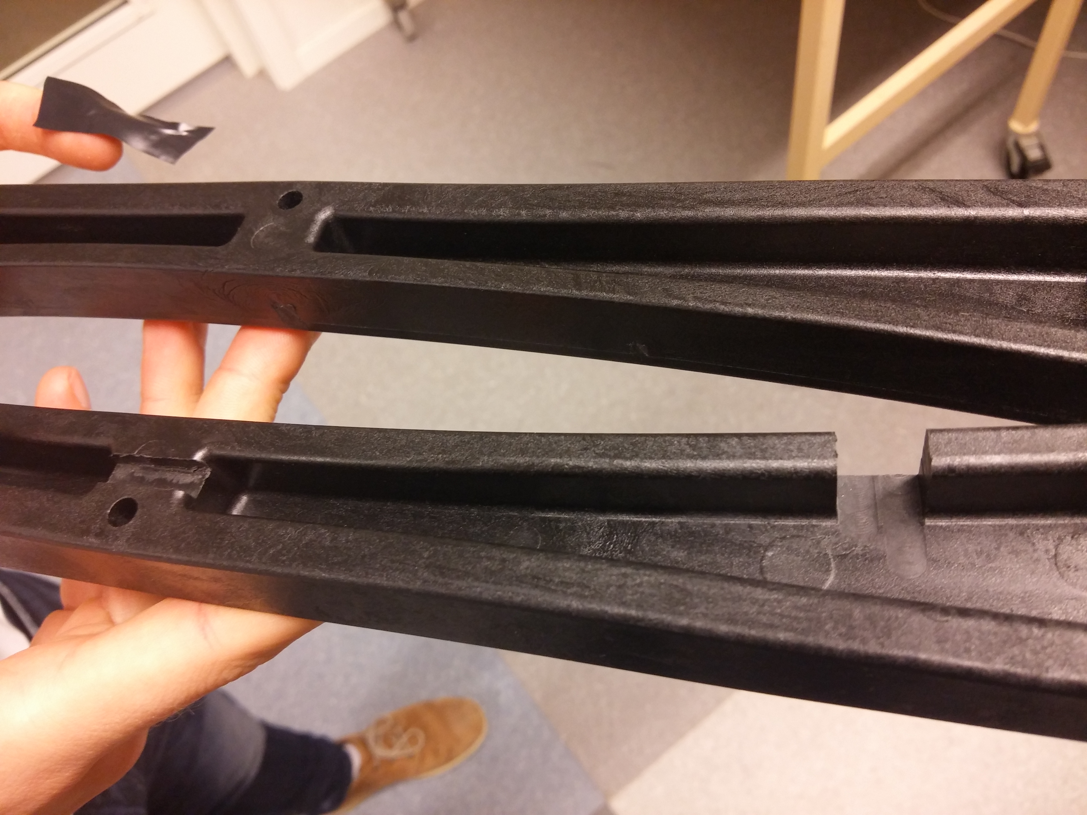
D7039E och E7025E/Dokumentation/Bilder Hårdvara/Prototype 2/20161108_1043406.jpg
