HTheolin/Dinghy_old/D7039E och E7025E/Dokumentation/Bilder Hårdvara/Prototype 2/20161205_161612.jpg

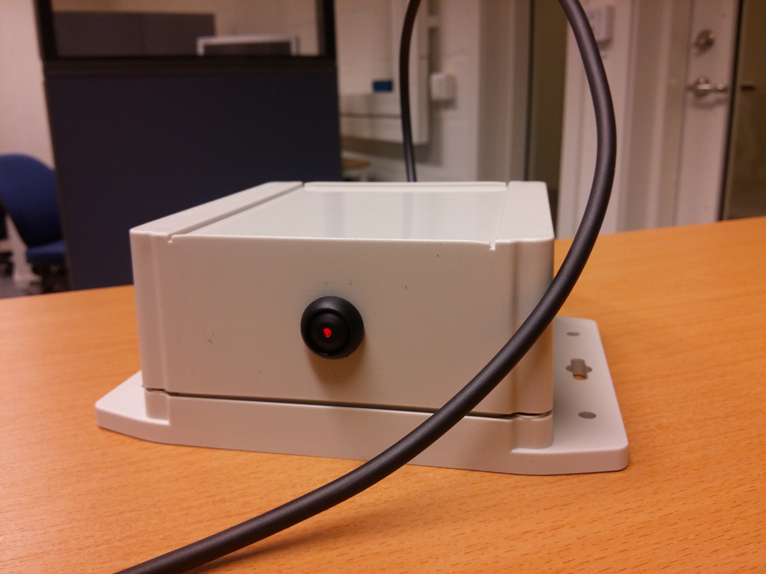
D7039E och E7025E/Dokumentation/Bilder Hårdvara/Prototype 2/20161205_161612.jpg
