HTheolin/Dinghy_old/D7039E och E7025E/Dokumentation/Bilder Hårdvara/Prototype 2/20161206_104501.jpg

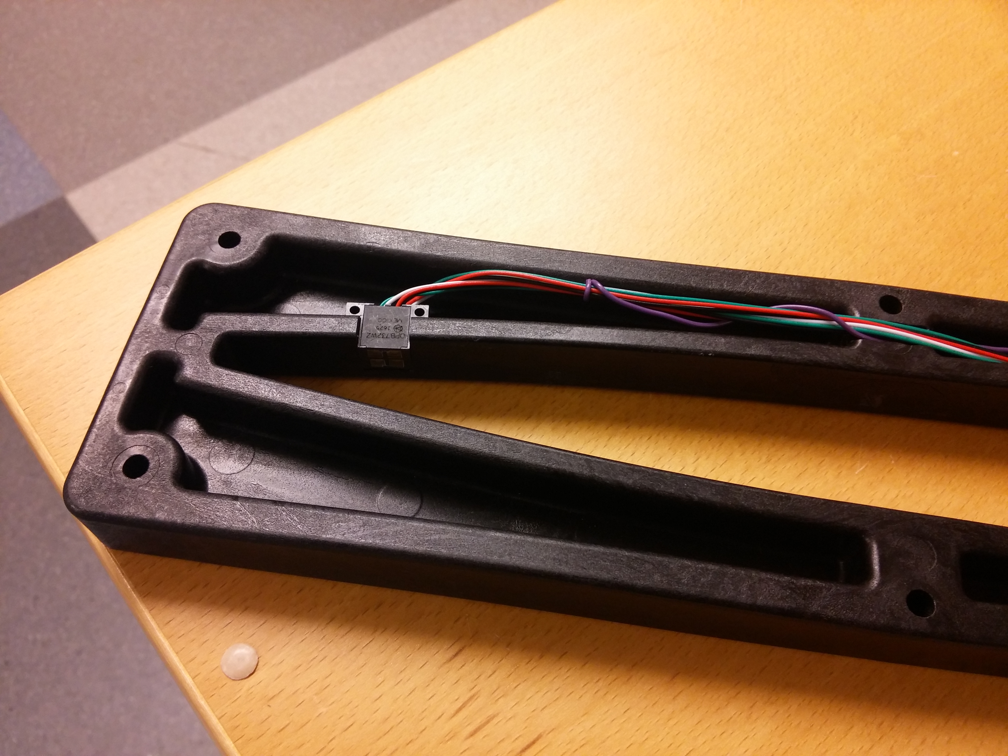
D7039E och E7025E/Dokumentation/Bilder Hårdvara/Prototype 2/20161206_104501.jpg
