HTheolin/Dinghy_old/D7039E och E7025E/Dokumentation/Bilder Hårdvara/Prototype 2/20161206_110536(1).jpg

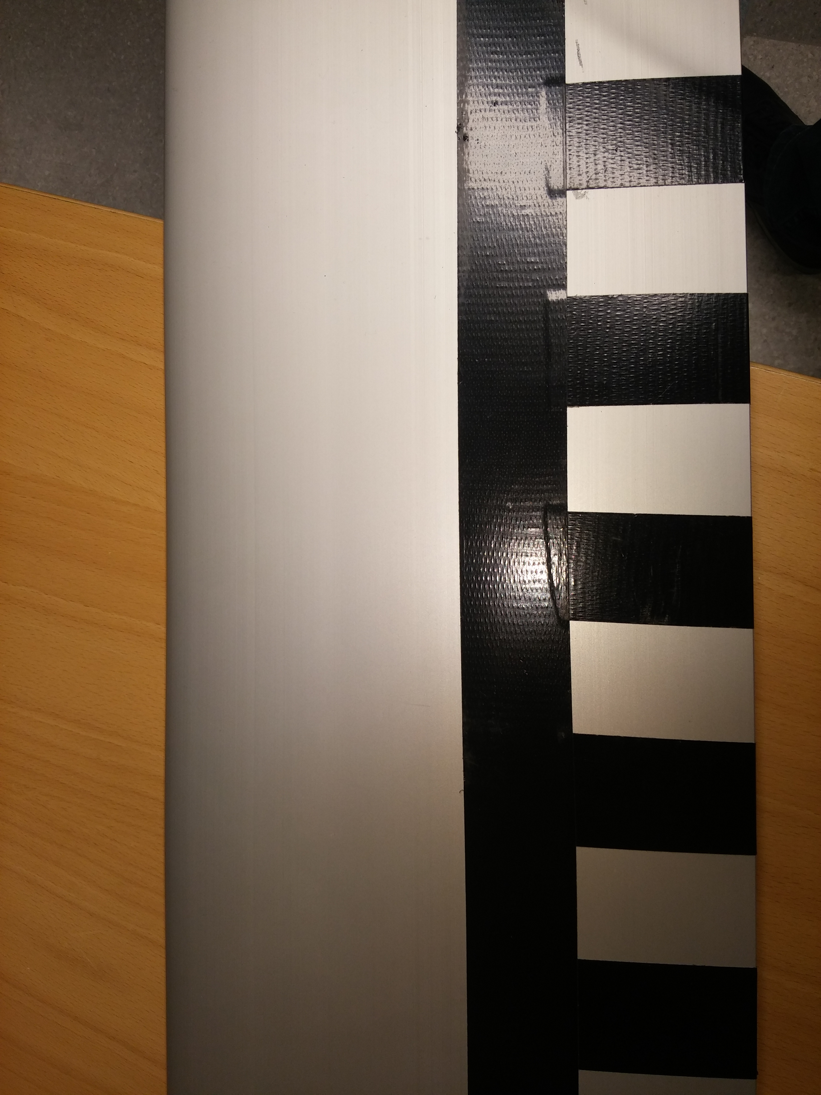
D7039E och E7025E/Dokumentation/Bilder Hårdvara/Prototype 2/20161206_110536(1).jpg
