HTheolin/Dinghy_old/D7039E och E7025E/Dokumentation/Bilder Hårdvara/Prototype 2/20161206_113628.jpg

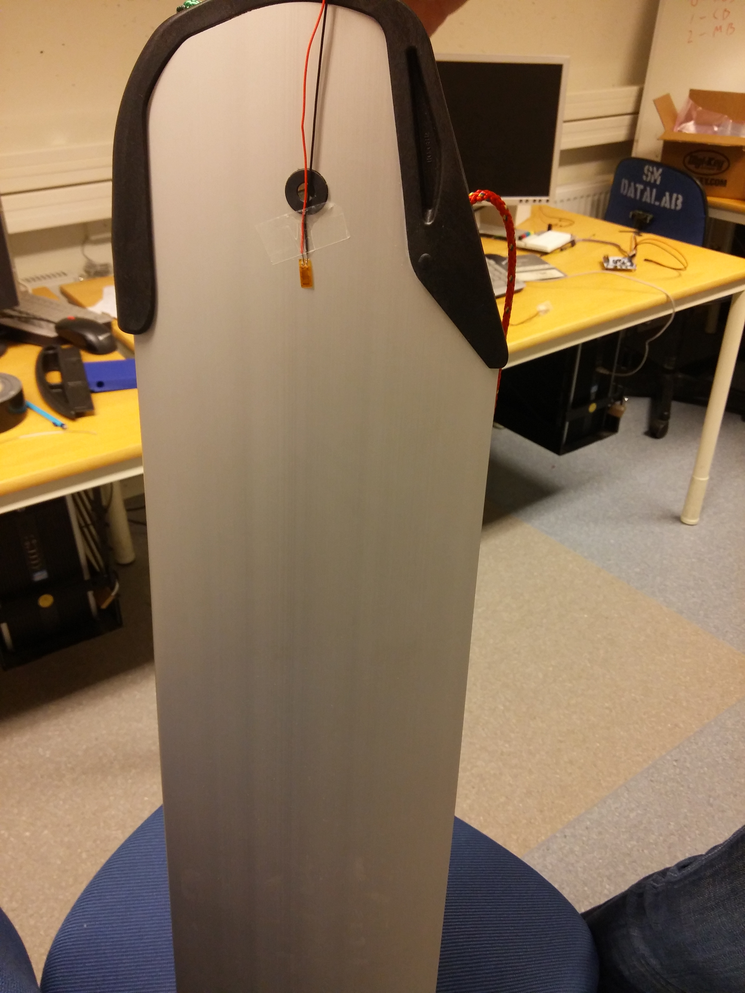
D7039E och E7025E/Dokumentation/Bilder Hårdvara/Prototype 2/20161206_113628.jpg
