HTheolin/Dinghy_old/D7039E och E7025E/Dokumentation/Bilder Hårdvara/Prototype 2/20161206_115635.jpg

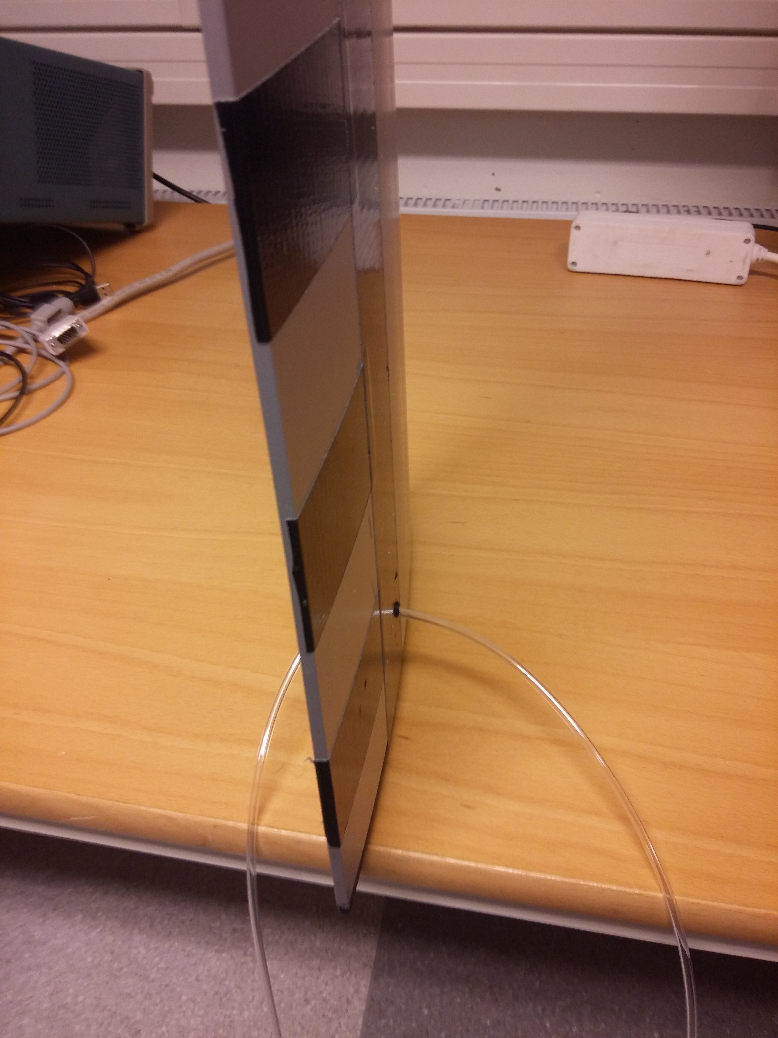
D7039E och E7025E/Dokumentation/Bilder Hårdvara/Prototype 2/20161206_115635.jpg
