HTheolin/Dinghy_old/D7039E och E7025E/Dokumentation/Bilder Hårdvara/Prototype 2/centerboard_connectors.png

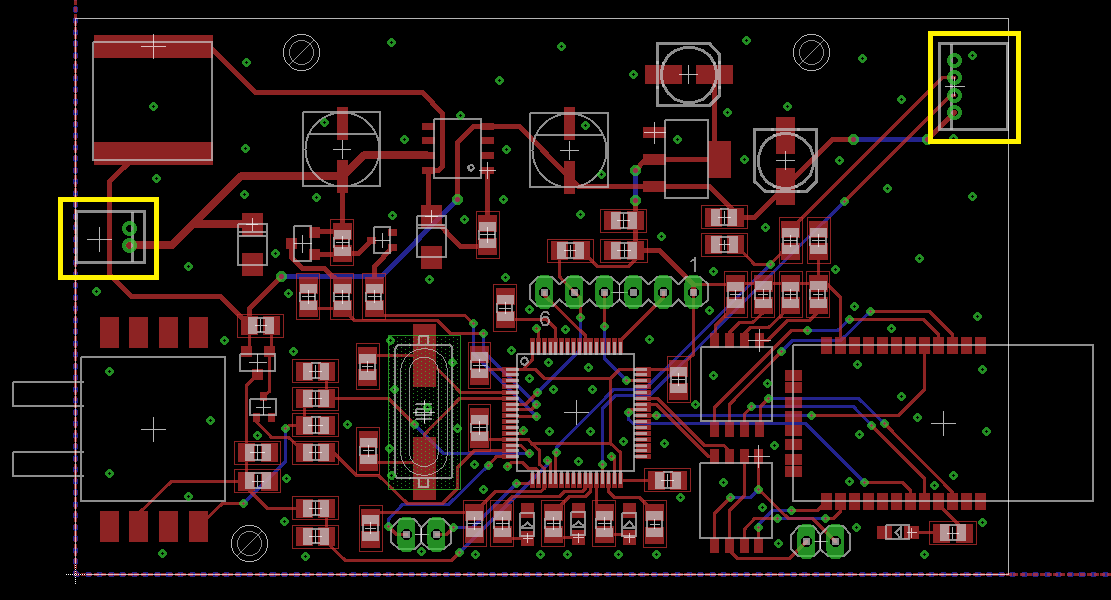
D7039E och E7025E/Dokumentation/Bilder Hårdvara/Prototype 2/centerboard_connectors.png
