HTheolin/Dinghy_old/D7039E och E7025E/Dokumentation/Bilder Hårdvara/Prototype 2/IMG_20161109_101826.jpg

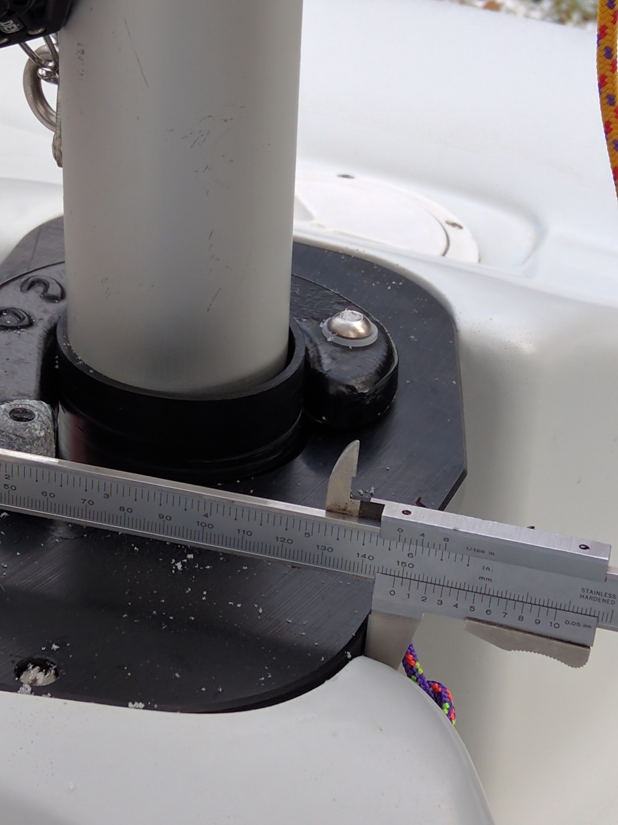
D7039E och E7025E/Dokumentation/Bilder Hårdvara/Prototype 2/IMG_20161109_101826.jpg
