HTheolin/Dinghy_old/D7039E och E7025E/Dokumentation/Bilder Hårdvara/Prototype 2/kabelförskruvning.png

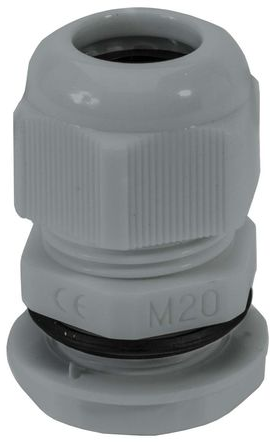
D7039E och E7025E/Dokumentation/Bilder Hårdvara/Prototype 2/kabelförskruvning.png
