HTheolin/Dinghy_old/D7039E och E7025E/Dokumentation/Bilder Hårdvara/Prototype 2/Låda_hammond_ip67.png

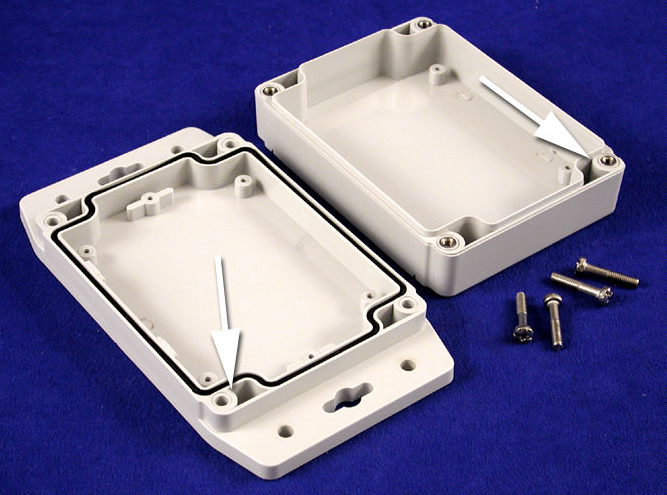
D7039E och E7025E/Dokumentation/Bilder Hårdvara/Prototype 2/Låda_hammond_ip67.png
