HTheolin/Dinghy_old/D7039E och E7025E/Dokumentation/Bilder Hårdvara/Prototype 2/mainboard_prot2.jpg

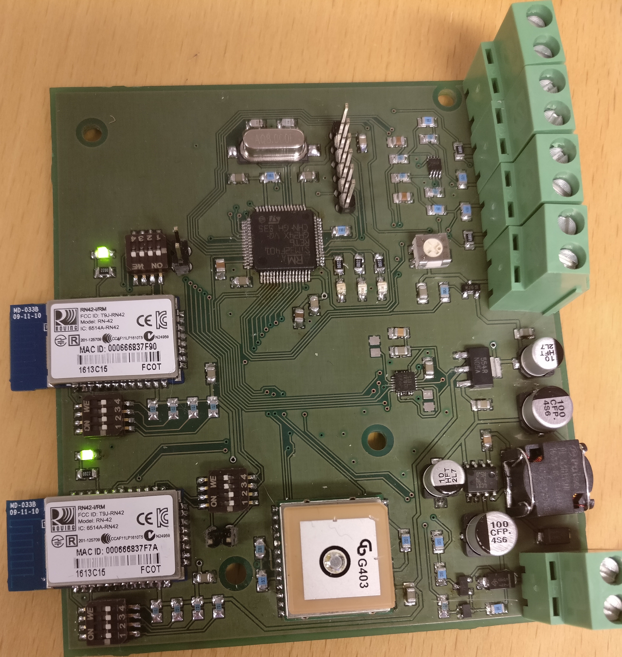
D7039E och E7025E/Dokumentation/Bilder Hårdvara/Prototype 2/mainboard_prot2.jpg
