HTheolin/Dinghy_old/D7039E och E7025E/Dokumentation/Bilder Hårdvara/Prototype 2/Rudderboard_prototype_2_amplifier.png

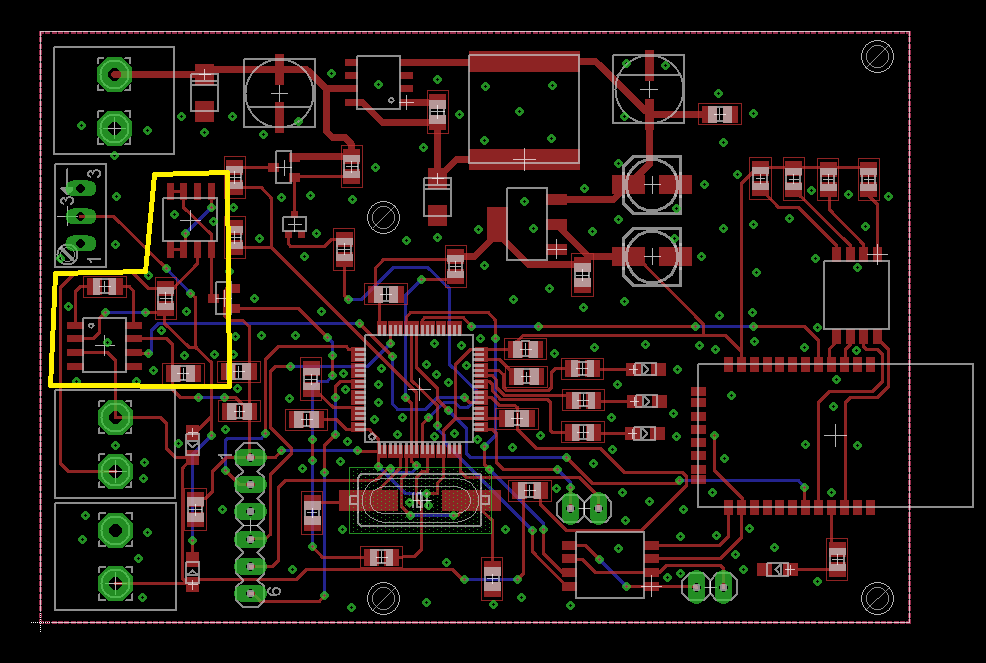
D7039E och E7025E/Dokumentation/Bilder Hårdvara/Prototype 2/Rudderboard_prototype_2_amplifier.png
