HTheolin/Dinghy_old/D7039E och E7025E/Dokumentation/Bilder Hårdvara/SMCTU0425C-20Pneumatisktror.png

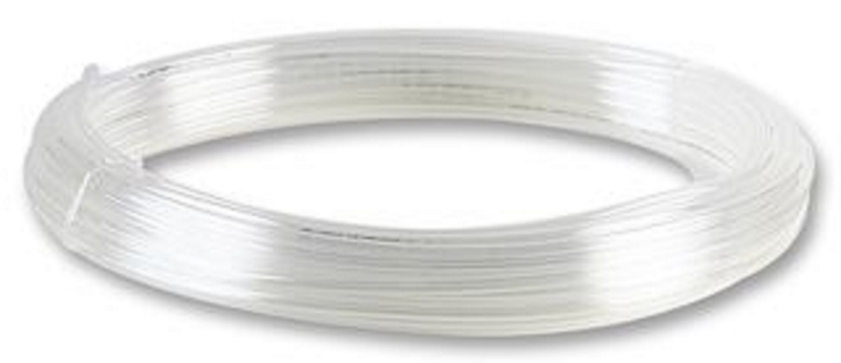
D7039E och E7025E/Dokumentation/Bilder Hårdvara/SMCTU0425C-20Pneumatisktror.png
