HTheolin/Dinghy_old/D7039E och E7025E/Dokumentation/Moddeller och UML/Android/LoggerUML.png

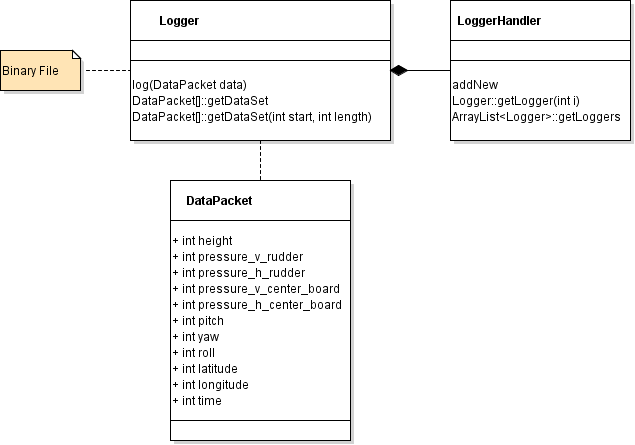
D7039E och E7025E/Dokumentation/Moddeller och UML/Android/LoggerUML.png
