HTheolin/Dinghy_old/D7039E och E7025E/Dokumentation/Presentation/Android screenshot/Screenshot_2016-12-06-14-08-31.png

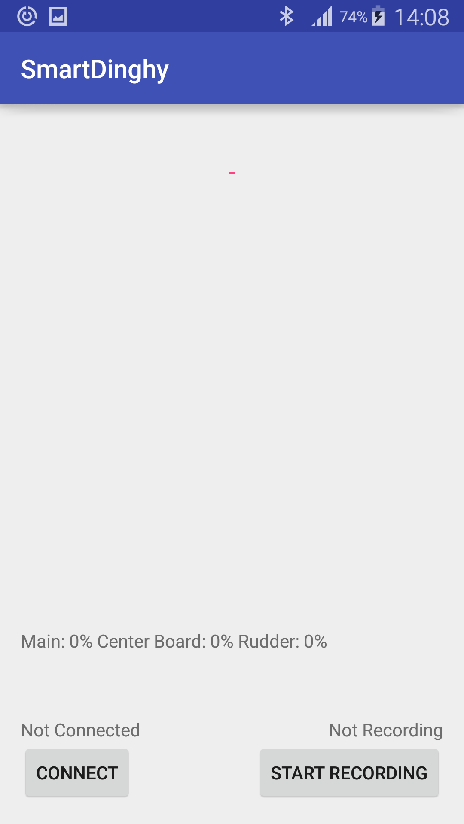
D7039E och E7025E/Dokumentation/Presentation/Android screenshot/Screenshot_2016-12-06-14-08-31.png
