HTheolin/Dinghy_old/D7039E och E7025E/Hårdvara/Hobbyking ordering.xlsx

Namn: | Mängd: | Pris/styck ($): | Länk:
ZIPPY Compact 1000mAh 2S 25C Lipo Pack | 3 | 5.06 | https://hobbyking.com/en_us/zippy-compact-1000mah-2s-25c-lipo-pack.html
JST Male 2 Pin Connector Set (10pcs/set) | 1 | 1.11 | https://www.hobbyking.com/en_us/jst-female-2-pin-connector-set-10pcs-set.html
JST Female 2 Pin Connector Set (10pcs/set) | 1 | 1.25 | https://www.hobbyking.com/en_us/jst-male-2-pin-connector-set-10pcs-set.html
Turnigy 12v 2-3S Basic Balance Charger | 1 | 4.92 | https://www.hobbyking.com/en_us/turnigy-12v-2-3s-basic-balance-charger.html
