HTheolin/Dinghy_old/D7039E och E7025E/Hårdvara/Dinghy Inventarie 2016-10-27.xlsx

Namn | Elfa # | Farnell # | Digikey # | QTY(fresh) | QTY(old) | Mainboard | Centerboard | Rudderboard
Pinheader 6p | 300-24-526 |  |  | 10 | 2 | 1+2/3 | 1 | 1
Led grön | 175-31-010 |  |  | 10 |  | 3 | 2 | 3
Skruvplint |  | 1717084 |  | 10 | 4 | 5 | 0 | 3
Led röd | 175-31-008 |  |  | 10 |  | 1 | 1 | 3
BT modul |  | 2143310 |  | 4 |  | 2 | 1 | 1
ZXMP10A13FTA Mosfet |  | 1843777 |  | 10 | 1 | 1 | 1 | 1
Control cable | 110-36-009 |  |  | 2 |  | 0 | 0 | 2
Led yellow |  | 1318247 |  | 10 |  | 1 | 1 | 3
BSH201 Mosfet |  | 1758073 |  | 10 |  | 1 | 1 | 1
Fuse |  | 1354567 |  | 10 |  | 1 | 1 | 1
Cap 10uF | 167-25-309 |  |  | 20 | 2 | 2 | 2 | 2
Osc kristall | 174-52-820 |  |  | 4 |  | 1 | 1 | 1
SI1330 Mosfet |  | 2335276 |  | 5 | 2 | 1 | 2 | 1
Trimmer pot 50k TS53YL |  | 1141476 |  | 2 | 1 | 1 | 0 | 0
Cap 4.7uF | 165-76-822 |  |  | 10 | 2 | 1 | 1 | 1
MCU |  | 2432108 |  | 4 |  | 1 | 1 | 1
Dipswitch | 110-87-482 |  |  | 4 |  | 4 | 2 | 2 | Beställ 4
LM1117 3v3 vreg | 300-19-198 |  |  | 3 | 1 | 1 | 1 | 1
Control cable | 115-61-267 |  |  | 1 |  | 0 | 1 | 0
Fuse holder |  | 2292906 |  | 3 |  | 1 | 1 | 1
TPS76150DBVT 5v vreg |  |  | 296-2697-1-ND | 2 | 1 | 0 | 0 | 0
MPXV7025DP-ND Press Sens |  |  | MPXV7025DP-ND | 1 |  | 0 | 1 | 0
Komparator TLV |  | 2463689 |  | 2 | 3 | 1 | 0 | 0
Straingauge |  |  |  | 3 |  | 0 | 0 | 2
MPU-9250 |  |  | 1428-1019-1-ND | 0 |  | 1 | 0 | 0
INA122UA | 173-38-106 |  |  | 0 |  | 0 | 0 | 1
REF200UA | 300-22-763 |  |  | 0 |  | 0 | 0 | 1
LM2674(buck - 5v out 500mA) | 300-19-303 |  |  | 0 |  | 1 | 1 | 1
Schotty 1A 20V SMD | 300-48-132 |  |  | 0 |  | 2 | 2 | 2
55uH induktans | 158-10-924 |  |  | 0 |  | 1 | 1 | 1
A2235H GPS MODULE |  | 2281695 |  | 0 |  | 1 | 0 | 0
SMD 100uF 16V Panasonic | 167-31-163 |  |  | 0 |  | 2 | 2 | 2
SMD 0.01 uF 50V 0805 | 300-31-704 |  |  | 0 |  | 1 | 1 | 1
Pot PV36W102C01B00 |  |  | 490-2874-ND | 0 |  | 0 | 0 | 1
RES SMD 348 OHM |  |  | 311-348CRCT-ND | 0 |  | 0 | 0 | 1
4 Kontakter, 1.5 mm |  | 9491830 |  | 0 |  | 0 | 1 | 0
Hona, 4 Ways, 1.5 mm |  | 3357569 |  | 0 |  | 0 | 1 | 0
2 Kontakter, 1.5 mm |  | 9491813 |  | 0 |  | 0 | 1 | 0
JS2 Kon, Hona, 1.5 mm |  | 3357545 |  | 0 |  | 0 | 1 | 0
OPB732WZ OPTO SWITCH |  | 1678639 |  | 0 | 2 |  | 0 | 0
Vippströmbrytare |  | 1839497 |  | 0 | 3 |  | 0
Ultrasonic distance sensor | 300-36-820 |  |  | 0 | 1
