HTheolin/Dinghy_old/D7039E och E7025E/Dokumentation/Bilder Hårdvara/how-to-place-strain-gauge.png

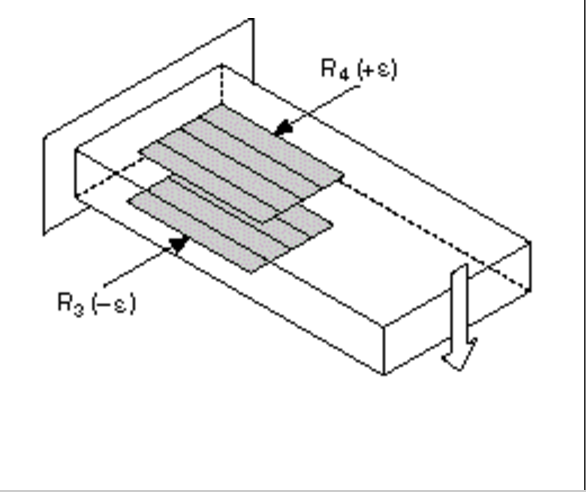
D7039E och E7025E/Dokumentation/Bilder Hårdvara/how-to-place-strain-gauge.png
