HTheolin/Dinghy_old/D7039E och E7025E/Dokumentation/FMEA och planering/FMEA.xlsx

Sheet: FMEA
 |  | vad som hänt | vad som påverkats |  | vad som orsakat
Category | FUNCTION | Potential Failure Mode | Potential Effect(s) of Failure | S | Potential Cause(s) of Failure | O | Current Process Controls | D | RPN | Recommended Action(s)
Mechanical | Functional System | Loss of part | Incomplete system | 5 | Part lost from mounting | 2 | Sufficient mounting | 1 | 10
 |  | Water enter housing | Shortages | 4 | Leakage in boxes or sensors | 2 | Waterproofing | 4 | 32 | Make sure housing is waterproof
 | Centerboard mobility | Loose part | Centerboard might get stuck | 3 | Forces are too big for the mounting to hold | 1 | Sufficient mounting | 1 | 3
Electronics | Sensor readings | Water enter housing | No readings or bad readings from sensors | 4 | Shortage | 2 | None atm but software detection could be implemented | 4 | 32 | Make sure housing is waterproof
 |  | Loss of part |  | 4 | Open circuit | 2 | None atm but software detection could be implemented | 2 | 16 | Make sure the sensor is correctly cinched
 |  | Water blocking distance sensor |  | 3 | Water interference | 1 | None | 4 | 12 | Can't do much
 |  | Missreading of optical sensor |  | 3 | Misaligned sensors | 3 | Sufficient mounting | 4
 | Battery | Water entering housing | Module power down | 5 | Short circuit | 2 |  | 1 | 10 | Make sure housing is waterproof
 |  |  | Component damaged | 5 |  | 2 |  | 1 | 10 | Make sure housing is waterproof
 | Functional System | Connector disconnects | Electronic malfunction | 4 | Vibrations | 2 | Use of pinheaders and cable connectors | 4 | 32 | Improve rigidness of connectors
 |  | Loss of wireless communication | Loss of system functionality | 5 | BT hardware connection loss/short | 2 | Verify system function beforehand | 2 | 20
 |  | MCU failure | MCU rebooting | 4 | Unexpected voltage drop | 1 | Banking capacitors | 5 | 20
Software | Logging | Corruption of log-files | Display and analysis of data | 2 | Unknown | 2 | None | 3 | 12 | Re-logg data
 |  | SD-card not connected | Logging failure | 2 | Missing SD-card | 1 |  | 1 | 2 | Insert SD-card
 |  |  |  | 2 | Loose SD-card | 1 |  | 1 | 2 | Find SD-card
 | Sleep mode | No wake-up | Module Failure | 4 | No more reading of data | 2 | Wake-up by interrupt | 2 | 16 | Restart
 |  |  |  | 4 | No connection to module | 2 | Retry in SW | 2 | 16 | Restart
 | User Interface | Software bugs | Crippled functionality | 1 | Programming methodology | 1 | None | 1 | 1 | Restart
 | Functional System | Battery discharge | Module | 5 | Power failure | 1 | None | 2 | 10 | Load/Change battery
 |  | Short circuit |  | 5 |  | 1 | HW detection and SW warning | 4 | 20 | Detect in Software and warn user
 |  | Crash |  | 5 | Crash | 1 | None | 2 | 10 | Restart Application
 | Application | Crash | Application | 5 | Crash | 1 | None | 1 | 5 | Restart Application
 |  | Missaligned data | Data presentation | 3 | Signal interference | 1 | None | 1 | 3 | Notify user
 |  |  |  | 1 | Bad sensor reading | 1 | None | 4 | 4 | Notify user
 |  |  |  | 3 | Short circuit | 1 | None | 4 | 12 | Notify user
 |  |  |  | 3 | Open circuit | 1 | None | 4 | 12 | Notify user
 |  | Phone battery depleted | Application | 5 | Phone battery depleted | 1 | Implemented in Phone | 1 | 5 | Notify user
Manufacturing & Integration | Centerboard performance | Damaged centerboard while mounting | Centerboard damaged | 3 | Integration of system | 1 | Careful modification of centerboard | 3 | 9
 | Waterproofing | Leakage | Water entering housing | 5 | Housing leakage | 2 | Waterproofing | 3 | 30
 |  |  |  | 4 | Bad application of silicone | 2 | Use proper material | 4 | 32
 |  |  |  | 4 | Bad seal for housing or sensors | 2 | Use good sealing | 4 | 32
Planning | Access to soldering lab | No access | No soldering | 5 | Cards not granted access | 1 | Communication | 1 | 5
 |  |  |  | 2 | Lab occupied | 2 | Planning | 1 | 4
 | Team availability | Absent Teammate | One part will have limited or no progress | 2 | Illness | 1 | Eat vegetables | 1 | 2
 |  |  |  | 3 | Lack of communication | 2 | Communication | 3 | 18
 |  |  |  | 3 | Conflict | 1 | Team building | 1 | 3
 | Tools are not available | Loss of license or such | LabView | 1 | Unknown | 1 | Use another program | 1 | 1
 |  |  | Atollic TrueStudio | 3 |  | 1 | Use another IDE | 1 | 3
 |  |  | Cube | 2 |  | 1 | Manually track pin use | 1 | 2
 |  |  | Eagle | 2 |  | 1 | Use KiCAD | 1 | 2
 |  |  | BitBucket | 4 |  | 1 | Keep backups | 1 | 4
 | Funding is insufficient | Unknown | Project | 4 | Too expensive | 1 | Look for cheaper components | 1 | 4
 |  |  |  | 5 | No funding | 1 | Keep project on track | 1 | 5
 | Experience is insufficient | Inexperienced team members | Part(s) of project | 4 | Necessary expertise in team is insufficient | 4 | Study hard | 3 | 48
 | Team collaboration | Inadequate team collaboration | Part(s) of project | 3 | Conflicts | 2 | Compromise | 1 | 6
 |  |  |  | 3 | Unorganized workload | 2 | Organization | 3 | 18
 |  |  |  | 3 | Inefficient workload | 2 | Organization | 4 | 24
 |  |  |  | 4 | Internal communication issues | 2 | Meetings | 4 | 32
Category | FUNCTION | Potential Failure Mode | Potential Effect(s) of Failure | S | Potential Cause(s) of Failure | O | Current Process Controls | D | RPN | Recommended Action(s)

Sheet: FÖRKLARING
nya | SEVERITY(S) | OCCURENCE(O) | DETECTION(D) | RISK PRIORITY NUMBER(RPN)
1 | Negligible | Very Rarely | Not able to miss it | 1: Works as intended
2 | Notable |  | Indicated by interface | 8: Look in to this, maybe fix
3 | Major | Sometimes | Observable by the naked eye | 27: Must fix (lower priority)
4 | Critical | Often | Observable by inspection | 64: Must fix (higher priority)
5 | Catastrophic | Always | Undetectable | 125: CRITICAL ERROR FIX IMMEDIATELY
gamla | SEVERITY(S) | OCCURENCE(O) | DETECTION(D)
 | Nothing is effected | Never | Not able to miss it | 1 DOTN CARE OR NOT VERY IMPORTANT
 | Unwanted Behavior | Rarely | Indicated by interface | 8: LOOK IN TO THIS, MABY FIX
 | Broken equipment | Somtimes | Observable by the naked eye | 27: MUST FIX
 | Injury | Often | Observable by inspection | 64 : MUST FIX
 | Lethal | Always | Undetectable | 125 : HOLY MOTHER FUCKER

Sheet: Blad2
Main Board "Active" | Loss of Power | No more data from this node | Battery shortcut
 |  |  | Battery empty
 | Loss of signal due to shortcut | No more data from this sensor | Water leak
 | Loss of signal due to loose cable | No more data from this sensor | Tear
Node "Active" | Loss of Power | No more data from this node | Water Leak
 |  |  | Empty Battery
 | Loss of physical part | No more data from this node, and potential loss of original physical functions.
 | Loss of signal due to shortcut | No more data from this sensor | Water leak
 | Loss of signal due to loose cable | No more data from this sensor | Tear
 | Pressure sensor out of position | Inaccurate data from pressure sensor | Forces too big for mounting
Inter-node Communication | Loss of packet | One data-point will miss some data | Miss timed sleep
 |  | One node will never report anything.
 | Corrupt packet | One data-point will have incorrect data
Main Board Communication | Loss of slave bluetooth module
 | Loss of Master bluetooth module
