HTheolin/Dinghy_old/D7039E och E7025E/Hårdvara/Schematics-Layouts/Boards/Prototyp 1/Centerboard - Prototype 1.brd

## EAGLE design D7039E och E7025E/Hårdvara/Schematics-Layouts/Boards/Prototyp 1/Centerboard - Prototype 1.brd (2017-08-30, an earlier design)

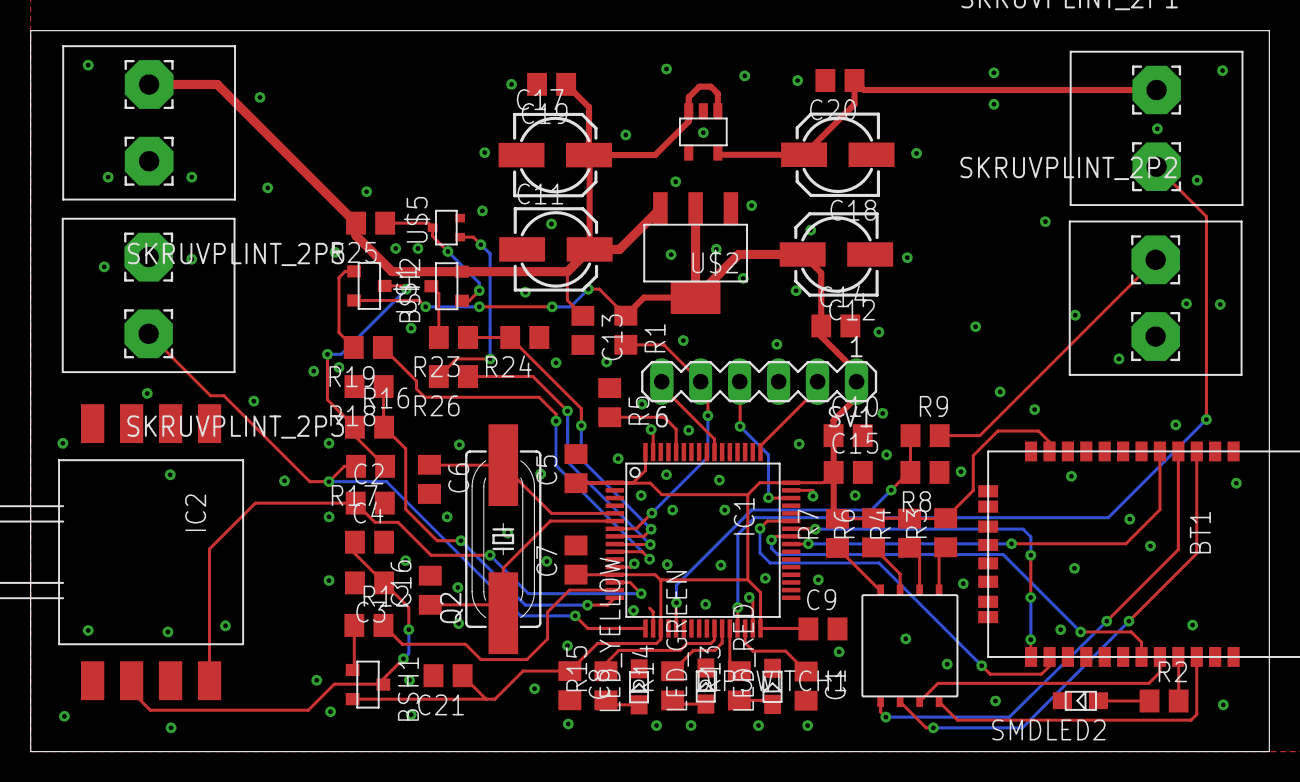
[picture p114: board Centerboard - Prototype 1.brd from above]

Board: 2 copper layers, 80.8 x 47.0 mm, 62 parts (0 on the bottom side), 49 nets.

Parts:
BSH1, BSH2: ZXMP10A13F; P-CHANNEL
BT1: BLUETOOTH-RN42; RN42
C1: 4u7; C0805
C2: 470pF; C0805
C3: 1uF; C0805
C4: 0.01uF; C0805
C5, C7, C8, C9, C10, C13, C14, C15, C19, C20: 100n; C0805
C6, C16: 25p; C0805
C11, C12, C17, C18: 10u; 153CLV-0505
C21: 1u; C0805
DIPSWITCH1: DIPSWITCH_4P; DIPSWITCH4P
IC1: STM32F401RBT; LQFP64
IC2: MP3V5010; CASE1351
IC3: TPS76150DBVT
LED_GREEN: SMD_LED; SMD_LED_CUSTOM
LED_RED: SMD_LED; SMD_LED_CUSTOM
LED_YELLOW: SMD_LED; SMD_LED_CUSTOM
Q2: 18p; HC49UP
R1, R5, R25: 10k; R0805
R2, R13, R14, R15: 220; R0805
R3, R4, R6, R7, R8, R12, R19, R26: 1k; R0805
R9: 680; R0805
R16, R17, R18: 350; R0805
R23: 6.8k; R0805
R24: 3.3k; R0805
SKRUVPLINT_2P1, SKRUVPLINT_2P2, SKRUVPLINT_2P3, SKRUVPLINT_2P5: SKRUVPLINT_2P
SMDLED2: SMD_LED; SMD_LED_CUSTOM
SV1: MA06-1
U$1: ZXMP10A13F; P-CHANNEL
U$2: LM1117; SOT-223
U$5: SI1330EDL; SOT-323

Connections:
+3V3: BSH1.SOURCE, BSH2.SOURCE, BT1.11, C5.1, C7.1, C8.1, C9.1, C10.1, C12.+, C14.1, C15.1, C21.1, IC1.1, IC1.13, IC1.19, IC1.32, IC1.48, IC1.64, R1.1, R3.2, R4.2, R6.2, R7.2, SV1.1, U$2.OUTPUT, U$2.VOUT
+5V: C18.+, C20.1, IC3.OUT, SKRUVPLINT_2P1.4
BATMEAS_ON/OFF: IC1.9, R26.1
BAT_MEAS: IC1.8, R23.1, R24.2
BT1_CONNSTAT: BT1.19, IC1.41
BT1_GPIO3: BT1.20, DIPSWITCH1.T2
BT1_GPIO4: BT1.22, DIPSWITCH1.T1
BT1_GPIO6: BT1.3, DIPSWITCH1.T3
BT1_GPIO7: BT1.4, DIPSWITCH1.T4
BT1_RESET: BT1.5, IC1.40
BT1_USART1_RX: BT1.14, IC1.43
BT1_USART1_TX: BT1.13, IC1.42
GND: BT1.1, BT1.12, BT1.15, BT1.16, BT1.17, BT1.18, BT1.28, BT1.29, BT1.31, BT1.32, BT1.33, BT1.34, C1.2, C2.2, C3.2, C4.2, C5.2, C6.2, C7.2, C8.2, C9.2, C10.2, C11.-, C12.-, C13.2, C14.2, C15.2, C16.2, C17.-, C18.-, C19.2, C20.2, C21.2, IC1.12, IC1.18, IC1.31, IC1.47, IC1.63, IC2.P$3, IC3.GND, LED_GREEN.2, LED_RED.2, LED_YELLOW.2, R5.1, R8.1, R18.2, R24.1, SKRUVPLINT_2P2.3, SKRUVPLINT_2P3.3, SKRUVPLINT_2P5.4, SMDLED2.2, SV1.3, U$2.GND, U$5.SOURCE
GPIO_ULTRA_INPUT: IC1.21, R8.2, R9.1
GPIO_ULTRA_TRIGGER: IC1.29, SKRUVPLINT_2P1.3
LED_GREEN: IC1.27, R14.2
LED_RED: IC1.28, R13.2
LED_YELLOW: IC1.26, R15.2
unnamed: C1.1, IC1.30
unnamed: IC1.60, R5.2
unnamed: LED_RED.1, R13.1
unnamed: BT1.21, R2.2
unnamed: DIPSWITCH1.B1, R3.1
unnamed: DIPSWITCH1.B2, R4.1
unnamed: DIPSWITCH1.B3, R6.1
unnamed: C6.1, IC1.5, Q2.2
unnamed: C16.1, IC1.6, Q2.1
unnamed: DIPSWITCH1.B4, R7.1
unnamed: R2.1, SMDLED2.1
unnamed: R9.2, SKRUVPLINT_2P2.4
unnamed: BSH1.DRAIN, C3.1, C4.1, IC2.P$2
unnamed: BSH1.GATE, R12.1
unnamed: LED_GREEN.1, R14.1
unnamed: LED_YELLOW.1, R15.1
unnamed: BSH2.DRAIN, R16.1, R17.1
unnamed: BSH2.GATE, R19.2
unnamed: C11.+, C13.1, C17.+, C19.1, IC3.EN, IC3.IN, R25.2, SKRUVPLINT_2P5.3, U$1.SOURCE, U$2.INPUT
unnamed: R23.2, U$1.DRAIN
unnamed: R25.1, U$1.GATE, U$5.DRAIN
unnamed: R26.2, U$5.GATE
NRST: IC1.7, R1.2, SV1.5
PRESSURE_ADC: C2.1, IC1.14, IC2.P$4
PRESSURE_ON/OFF: IC1.15, R12.2
STRAIN_ADC1: IC1.16, R16.2, R18.1
STRAIN_ADC2: IC1.17, R17.2, SKRUVPLINT_2P3.4
STRAIN_ON/OFF: IC1.10, R19.1
SWCLK: IC1.49, SV1.2
SWDIO: IC1.46, SV1.4
SWO: IC1.55, SV1.6
