HTheolin/Dinghy_old/D7039E och E7025E/Hårdvara/Schematics-Layouts/Boards/Prototyp 2/Mainboard - Prototyp 2.brd

## EAGLE design D7039E och E7025E/Hårdvara/Schematics-Layouts/Boards/Prototyp 2/Mainboard - Prototyp 2.brd (2017-08-30)

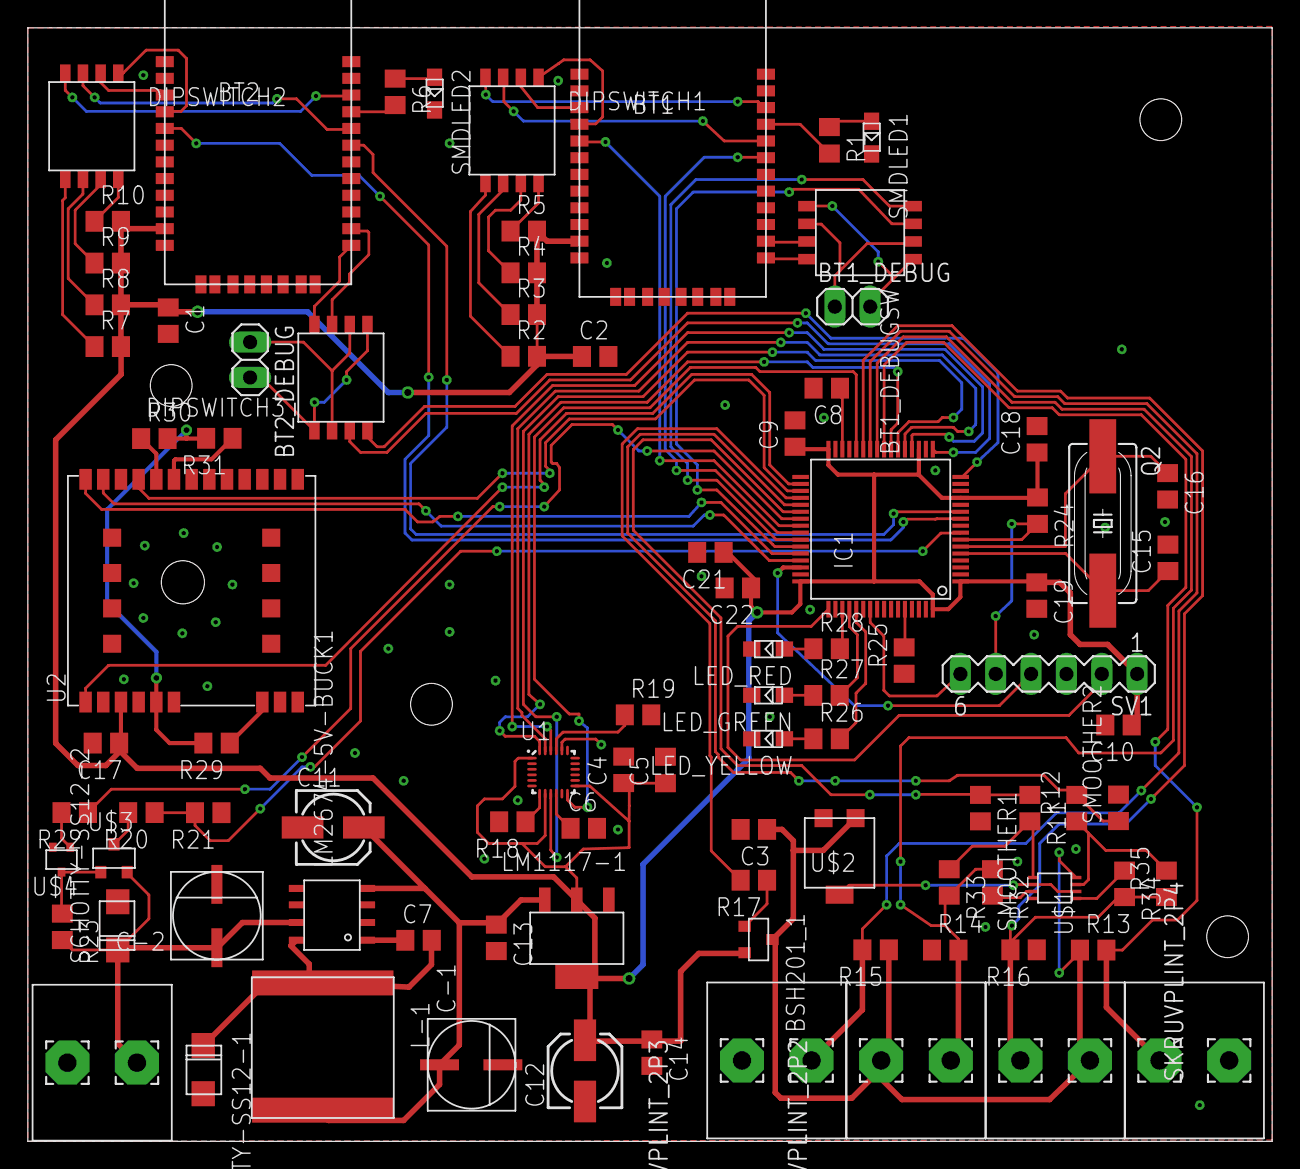
[picture p115: board Mainboard - Prototyp 2.brd from above]

Board: 2 copper layers, 89.4 x 80.0 mm, 93 parts (0 on the bottom side), 91 nets.

Parts:
BSH201_1: BSH201; P-CHANNEL
BT1, BT2: BLUETOOTH-RN42; RN42
BT1_DEBUG, BT2_DEBUG: 1X02
BT1_DEBUGSW: DIPSWITCH_4P; DIPSWITCH4P
C1, C2, C3, C4, C6, C9, C10, C13, C14, C17, C18, C19, C22: 100n; C0805
C5: 10n; C0805
C7: 0.01uF; C0805
C8: 4u7; C0805
C11, C12: 10u; 153CLV-0505
C15, C16: 25p; C0805
C21: 1u; C0805
C-1, C-2: 100uF; CAP-6.3MM-DIA
DIPSWITCH1, DIPSWITCH2, DIPSWITCH3: DIPSWITCH_4P; DIPSWITCH4P
IC1: STM32F401RBT; LQFP64
L-1: 55uH; INDUCTOR
LED_GREEN: SMD_LED; SMD_LED_CUSTOM
LED_RED: SMD_LED; SMD_LED_CUSTOM
LED_YELLOW: SMD_LED; SMD_LED_CUSTOM
LM1117-1: LM1117
LM2674-5V-BUCK1: LM2674-5VBUCK; LM2674
Q2: 18p; HC49UP
R1, R6, R26, R27, R28: 220; R0805
R2, R3, R4, R5, R7, R8, R9, R10, R11, R12, R22, R32, R34: 1k; R0805
R13, R15: 68; R0805
R14, R16: 4.7k; R0805
R17: 150; R0805
R18, R19: 0; R0805
R20: 6.8k; R0805
R21: 3.3k; R0805
R23, R24, R25, R29, R33, R35: 10k; R0805
R30, R31: 2k2; R0805
SCHOTTY-SS12-1, SCHOTTY-SS12-2: SCHOTTY-SS12; SCHOTTY
SKRUVPLINT_2P1, SKRUVPLINT_2P2, SKRUVPLINT_2P3, SKRUVPLINT_2P4, SKRUVPLINT_2P5: SKRUVPLINT_2P
SMDLED1, SMDLED2: SMD_LED; SMD_LED_CUSTOM
SMOOTHER1, SMOOTHER2: 1n; C0805
SV1: MA06-1
U1: MPU-9250; QFN40P300X300X105-25N
U2: A2235-H; XCVR_A2235-H
U$1: TLV7256; VSSOP
U$2: TS53YL; POT
U$3: ZXMP10A13F; P-CHANNEL
U$4: SI1330EDL; SOT-323

Connections:
1V8_VOUT: R29.2, R30.2, R31.2, U2.5
+3V3: BSH201_1.SOURCE, BT1.11, BT2.11, C1.1, C2.1, C4.1, C5.1, C9.1, C10.1, C12.+, C14.1, C17.1, C18.1, C19.1, C21.1, C22.1, IC1.1, IC1.13, IC1.19, IC1.32, IC1.48, IC1.64, LM1117-1.OUTPUT, LM1117-1.OUTPUT2, R2.2, R3.2, R4.2, R5.2, R7.2, R8.2, R9.2, R10.2, R24.1, SV1.1, U1.1, U1.8, U1.13, U2.3
+5V: C11.+, C13.1, C-1.+, L-1.2, LM1117-1.INPUT, LM2674-5V-BUCK1.4
BATMEAS_TOGGLE: IC1.39, R22.1
BATSUP: C-2.+, LM2674-5V-BUCK1.7, R23.2, SCHOTTY-SS12-2.-, SKRUVPLINT_2P5.3, U$3.SOURCE
BAT_MEAS: IC1.8, R20.1, R21.2
BT1_CONNSTATUS: BT1.19, IC1.41
BT1_DEBUGRX: BT1_DEBUG.2, BT1_DEBUGSW.B1, BT1_DEBUGSW.T4
BT1_DEBUGTX: BT1_DEBUG.1, BT1_DEBUGSW.B2, BT1_DEBUGSW.T3
BT1_GPIO3: BT1.20, DIPSWITCH1.T2
BT1_GPIO4: BT1.22, DIPSWITCH1.T1
BT1_GPIO6: BT1.3, DIPSWITCH1.T3
BT1_GPIO7: BT1.4, DIPSWITCH1.T4
BT1_RESET: BT1.5, IC1.40
BT1_RX: BT1.13, BT1_DEBUGSW.B4
BT1_TX: BT1.14, BT1_DEBUGSW.B3
BT2_CONNSTATUS: BT2.19, IC1.11
BT2_DEBUGRX: BT2_DEBUG.2, DIPSWITCH3.B1, DIPSWITCH3.T4
BT2_DEBUGTX: BT2_DEBUG.1, DIPSWITCH3.B2, DIPSWITCH3.T3
BT2_GPIO3: BT2.20, DIPSWITCH2.T2
BT2_GPIO4: BT2.22, DIPSWITCH2.T1
BT2_GPIO6: BT2.3, DIPSWITCH2.T3
BT2_GPIO7: BT2.4, DIPSWITCH2.T4
BT2_RESET: BT2.5, IC1.10
BT2_RX: BT2.13, DIPSWITCH3.B4
BT2_TX: BT2.14, DIPSWITCH3.B3
GND: BT1.1, BT1.12, BT1.15, BT1.16, BT1.17, BT1.18, BT1.28, BT1.29, BT1.31, BT1.32, BT1.33, BT1.34, BT2.1, BT2.12, BT2.15, BT2.16, BT2.17, BT2.18, BT2.28, BT2.29, BT2.31, BT2.32, BT2.33, BT2.34, C1.2, C2.2, C3.2, C4.2, C5.2, C6.2, C8.2, C9.2, C10.2, C11.-, C12.-, C13.2, C14.2, C15.2, C16.2, C17.2, C18.2, C19.2, C21.2, C22.2, C-1.-, C-2.-, IC1.12, IC1.18, IC1.31, IC1.47, IC1.63, LED_GREEN.2, LED_RED.2, LED_YELLOW.2, LM1117-1.ADJ/GND, LM2674-5V-BUCK1.6, R14.1, R16.1, R18.2, R19.2, R21.1, R25.1, SCHOTTY-SS12-1.+, SCHOTTY-SS12-2.+, SKRUVPLINT_2P1.4, SKRUVPLINT_2P3.4, SKRUVPLINT_2P5.4, SMDLED1.2, SMDLED2.2, SMOOTHER1.2, SMOOTHER2.2, SV1.3, U1.11, U1.18, U1.20, U2.6, U2.9, U2.20, U2.23, U2.24, U2.25, U2.26, U2.27, U2.28, U2.29, U2.30, U$1.P$4, U$2.P$1_A, U$4.SOURCE
GPS_NRST: IC1.34, U2.1
GPS_TOGGLE: IC1.35, U2.19
IMU_INT: IC1.28, U1.12
LED_GREEN: IC1.52, R27.2
LED_RED: IC1.51, R28.2
LED_YELLOW: IC1.53, R26.2
MCURX1_BT1TX: BT1_DEBUGSW.T2, IC1.43
MCURX2_BT2TX: DIPSWITCH3.T2, IC1.17
MCURX6_GPSTX: IC1.45, U2.21
MCUTX1_BT1RX: BT1_DEBUGSW.T1, IC1.42
MCUTX2_BT2RX: DIPSWITCH3.T1, IC1.16
MCUTX6_GPSRX: IC1.44, U2.22
unnamed: BT1.21, R1.2
unnamed: DIPSWITCH1.B1, R2.1
unnamed: DIPSWITCH1.B2, R3.1
unnamed: DIPSWITCH1.B3, R4.1
unnamed: DIPSWITCH1.B4, R5.1
unnamed: BT2.21, R6.2
unnamed: DIPSWITCH2.B1, R7.1
unnamed: DIPSWITCH2.B2, R8.1
unnamed: DIPSWITCH2.B3, R9.1
unnamed: DIPSWITCH2.B4, R10.1
unnamed: R6.1, SMDLED2.1
unnamed: R1.1, SMDLED1.1
unnamed: R11.2, R33.1, U$1.P$1
unnamed: U$1.P$2, U$1.P$6, U$2.P$2_B
unnamed: R12.1, R35.2, U$1.P$7
unnamed: R29.1, U2.7
unnamed: R30.1, U2.18
unnamed: BSH201_1.GATE, R17.1
unnamed: C6.1, U1.10
unnamed: R18.1, U1.7
unnamed: R19.1, U1.21
unnamed: C7.1, LM2674-5V-BUCK1.1
unnamed: R20.2, U$3.DRAIN
unnamed: R22.2, U$4.GATE
unnamed: R23.1, U$3.GATE, U$4.DRAIN
unnamed: C8.1, IC1.30
unnamed: IC1.60, R25.2
unnamed: C15.1, IC1.5, Q2.2
unnamed: C16.1, IC1.6, Q2.1
unnamed: LED_YELLOW.1, R26.1
unnamed: LED_GREEN.1, R27.1
unnamed: R31.1, U2.17
unnamed: LED_RED.1, R28.1
unnamed: R32.2, U$1.P$3
unnamed: R34.1, U$1.P$5
NRST: IC1.7, R24.2, SV1.5
OPTO1_DIODE: IC1.24, R13.2, SKRUVPLINT_2P1.3
OPTO1_OUT: IC1.38, R11.1, SMOOTHER1.1
OPTO1_TRAN: IC1.25, R14.2, R32.1, R33.2, SKRUVPLINT_2P2.3
OPTO2_DIODE: IC1.26, R15.2, SKRUVPLINT_2P3.3
OPTO2_OUT: IC1.37, R12.2, SMOOTHER2.1
OPTO2_TRAN: IC1.27, R16.2, R34.2, R35.1, SKRUVPLINT_2P4.3
OPTO_TOGGLE: IC1.36, R17.2
OPTO_VDD: BSH201_1.DRAIN, C3.1, R13.1, R15.1, SKRUVPLINT_2P2.4, SKRUVPLINT_2P4.4, U$1.P$8, U$2.P$3_C
SPI1_MISO: IC1.22, U1.9
SPI1_MOSI: IC1.23, U1.24
SPI1_NSS: IC1.20, U1.22
SPI1_SCK: IC1.21, U1.23
SWCLK: IC1.49, SV1.2
SWDIO: IC1.46, SV1.4
SWO: IC1.55, SV1.6
VOUT: C7.2, L-1.1, LM2674-5V-BUCK1.8, SCHOTTY-SS12-1.-
