HTheolin/Dinghy_old/D7039E och E7025E/Hårdvara/Schematics-Layouts/Boards/Prototyp 1/Mainboard - Prototype 1.brd

## EAGLE design D7039E och E7025E/Hårdvara/Schematics-Layouts/Boards/Prototyp 1/Mainboard - Prototype 1.brd (2017-08-30, an earlier design)

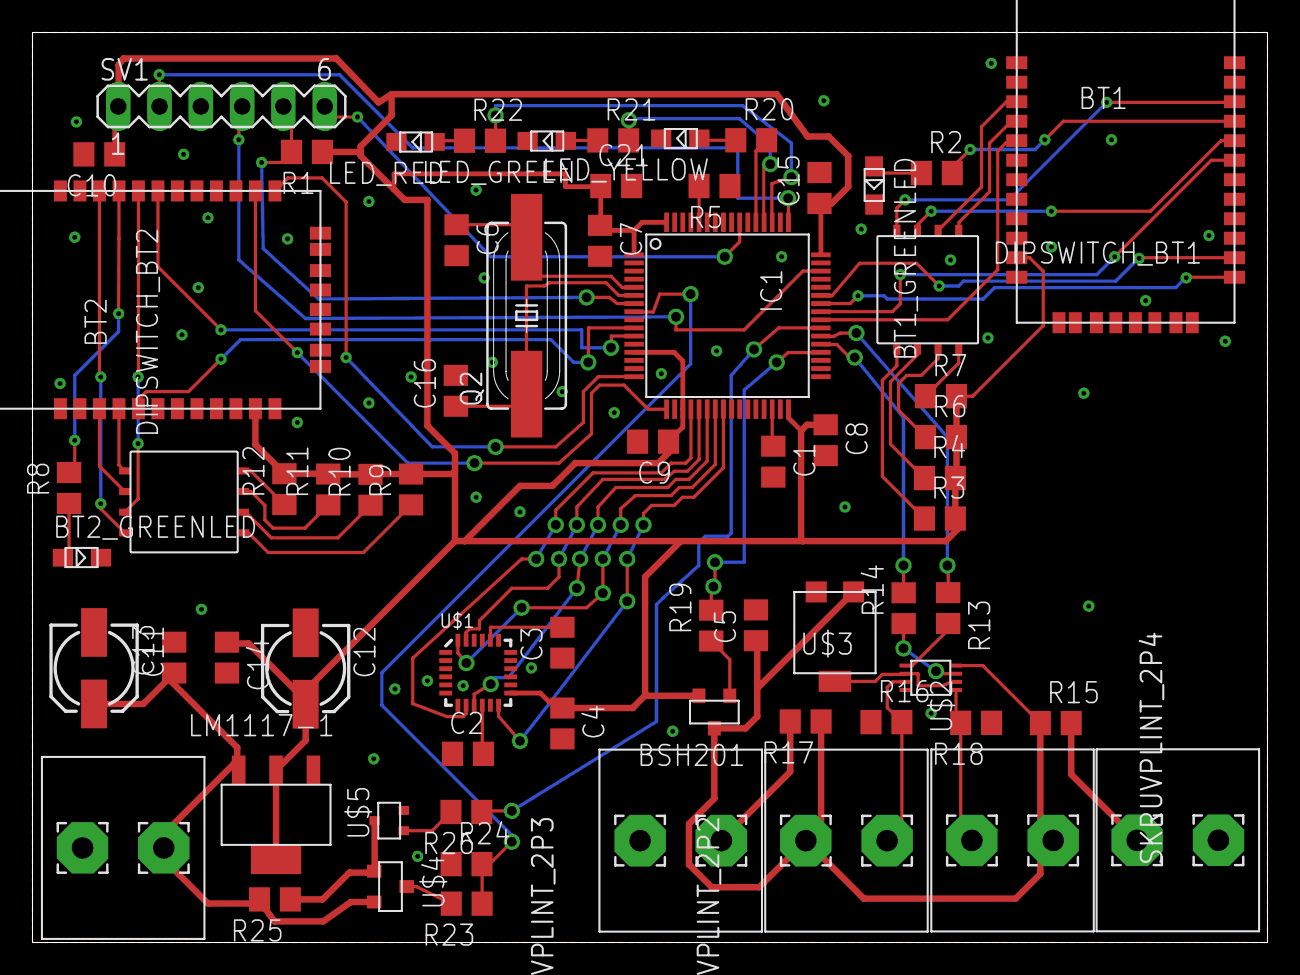
[picture p116: board Mainboard - Prototype 1.brd from above]

Board: 2 copper layers, 76.0 x 56.0 mm, 67 parts (0 on the bottom side), 69 nets.

Parts:
BSH201: ZXMP10A13F; P-CHANNEL
BT1, BT2: BLUETOOTH-RN42; RN42
BT1_GREENLED, BT2_GREENLED: SMD_LED; SMD_LED_CUSTOM
C1: 4u7; C0805
C2, C4, C5, C7, C8, C9, C10, C13, C14, C15: 100n; C0805
C3: 2.2n; C0805
C6, C16: 25p; C0805
C11, C12: 10u; 153CLV-0505
C21: 1u; C0805
DIPSWITCH_BT1, DIPSWITCH_BT2: DIPSWITCH_4P; DIPSWITCH4P
IC1: STM32F401RBT; LQFP64
LED_GREEN: SMD_LED; SMD_LED_CUSTOM
LED_RED: SMD_LED; SMD_LED_CUSTOM
LED_YELLOW: SMD_LED; SMD_LED_CUSTOM
LM1117-1: LM1117
Q2: 18p; HC49UP
R1, R5, R25: 10k; R0805
R2, R8, R20, R21, R22: 220; R0805
R3, R4, R6, R7, R9, R10, R11, R12, R13, R14, R26: 1k; R0805
R15, R17, R19: 150; R0805
R16, R18: 68; R0805
R23: 6.8k; R0805
R24: 3.3k; R0805
SKRUVPLINT_2P1, SKRUVPLINT_2P2, SKRUVPLINT_2P3, SKRUVPLINT_2P4, SKRUVPLINT_2P5: SKRUVPLINT_2P
SV1: MA06-1
U$1: MPU-6000; QFN-24
U$2: TLV7256; VSSOP
U$3: TS53YL; POT
U$4: ZXMP10A13F; P-CHANNEL
U$5: SI1330EDL; SOT-323

Connections:
1PHOTO: R16.2, SKRUVPLINT_2P2.3, U$2.P$3
2PHOTO: R18.2, SKRUVPLINT_2P4.3, U$2.P$5
+3V3: BSH201.SOURCE, BT1.11, BT2.11, C4.1, C7.1, C8.1, C9.1, C10.1, C12.+, C14.1, C15.1, C21.1, IC1.1, IC1.13, IC1.19, IC1.32, IC1.48, IC1.64, LM1117-1.OUTPUT, LM1117-1.OUTPUT2, R1.1, R3.2, R4.2, R6.2, R7.2, R9.2, R10.2, R11.2, R12.2, SV1.1, U$1.13
BATMEAS_TOGGLE: IC1.39, R26.1
BAT_MEAS: IC1.8, R23.1, R24.2
BT1_CONNSTAT: BT1.19, IC1.41
BT1_GPIO3: BT1.20, DIPSWITCH_BT1.T2
BT1_GPIO4: BT1.22, DIPSWITCH_BT1.T1
BT1_GPIO6: BT1.3, DIPSWITCH_BT1.T3
BT1_GPIO7: BT1.4, DIPSWITCH_BT1.T4
BT1_RESET: BT1.5, IC1.40
BT1_USART1_RX: BT1.14, IC1.43
BT1_USART1_TX: BT1.13, IC1.42
BT2_CONNSTAT: BT2.19, IC1.11
BT2_GPIO3: BT2.20, DIPSWITCH_BT2.T2
BT2_GPIO4: BT2.22, DIPSWITCH_BT2.T1
BT2_GPIO5: BT2.21, R8.2
BT2_GPIO6: BT2.3, DIPSWITCH_BT2.T3
BT2_GPIO7: BT2.4, DIPSWITCH_BT2.T4
BT2_RESET: BT2.5, IC1.10
BT2_USART2_RX: BT2.14, IC1.17
BT2_USART2_TX: BT2.13, IC1.16
GND: BT1.1, BT1.12, BT1.15, BT1.16, BT1.17, BT1.18, BT1.28, BT1.29, BT1.31, BT1.32, BT1.33, BT1.34, BT1_GREENLED.2, BT2.1, BT2.12, BT2.15, BT2.16, BT2.17, BT2.18, BT2.28, BT2.29, BT2.31, BT2.32, BT2.33, BT2.34, BT2_GREENLED.2, C1.2, C2.1, C3.1, C4.2, C5.2, C6.2, C7.2, C8.2, C9.2, C10.2, C11.-, C12.-, C13.2, C14.2, C15.2, C16.2, C21.2, IC1.12, IC1.18, IC1.31, IC1.47, IC1.63, LED_GREEN.2, LED_RED.2, LED_YELLOW.2, LM1117-1.ADJ/GND, R5.1, R16.1, R18.1, R24.1, SKRUVPLINT_2P1.4, SKRUVPLINT_2P3.4, SKRUVPLINT_2P5.4, SV1.3, U$1.1, U$1.6, U$1.7, U$1.11, U$1.18, U$2.P$4, U$3.P$1_A, U$5.SOURCE
LED_GREEN: IC1.52, R21.2
LED_RED: IC1.51, R22.2
LED_YELLOW: IC1.53, R20.2
MPU_INT: IC1.24, U$1.12
unnamed: C1.1, IC1.30
unnamed: IC1.60, R5.2
unnamed: R13.2, U$2.P$1
unnamed: BT1.21, R2.2
unnamed: DIPSWITCH_BT1.B1, R3.1
unnamed: DIPSWITCH_BT1.B2, R4.1
unnamed: DIPSWITCH_BT1.B3, R6.1
unnamed: C6.1, IC1.5, Q2.2
unnamed: C16.1, IC1.6, Q2.1
unnamed: DIPSWITCH_BT1.B4, R7.1
unnamed: BT1_GREENLED.1, R2.1
unnamed: DIPSWITCH_BT2.B1, R9.1
unnamed: DIPSWITCH_BT2.B2, R10.1
unnamed: DIPSWITCH_BT2.B3, R11.1
unnamed: DIPSWITCH_BT2.B4, R12.1
unnamed: BT2_GREENLED.1, R8.1
unnamed: C2.2, U$1.10
unnamed: C3.2, U$1.20
unnamed: U$2.P$2, U$2.P$6, U$3.P$2_B
unnamed: R14.1, U$2.P$7
unnamed: R15.2, SKRUVPLINT_2P1.3
unnamed: R17.2, SKRUVPLINT_2P3.3
unnamed: BSH201.GATE, R19.1
unnamed: R23.2, U$4.DRAIN
unnamed: R25.1, U$4.GATE, U$5.DRAIN
unnamed: R26.2, U$5.GATE
unnamed: LED_YELLOW.1, R20.1
unnamed: LED_GREEN.1, R21.1
unnamed: LED_RED.1, R22.1
NRST: IC1.7, R1.2, SV1.5
PHOTO1_OUT: IC1.38, R13.1
PHOTO2_OUT: IC1.37, R14.2
PHOTOMEAS_TOGGLE: IC1.36, R19.2
PHOTOVDD: BSH201.DRAIN, C5.1, R15.1, R17.1, SKRUVPLINT_2P2.4, SKRUVPLINT_2P4.4, U$2.P$8, U$3.P$3_C
SPI1_MISO: IC1.22, U$1.9
SPI1_MOSI: IC1.23, U$1.24
SPI1_NSS: IC1.20, U$1.8
SPI1_SCK: IC1.21, U$1.23
SWCLK: IC1.49, SV1.2
SWDIO: IC1.46, SV1.4
SWO: IC1.55, SV1.6
VREGIN: C11.+, C13.1, LM1117-1.INPUT, R25.2, SKRUVPLINT_2P5.3, U$4.SOURCE
