HTheolin/Dinghy_old/D7039E och E7025E/Hårdvara/Schematics-Layouts/Schematics/Partial Schematics/A2235-H.sch

## EAGLE design D7039E och E7025E/Hårdvara/Schematics-Layouts/Schematics/Partial Schematics/A2235-H.sch (2017-08-30)

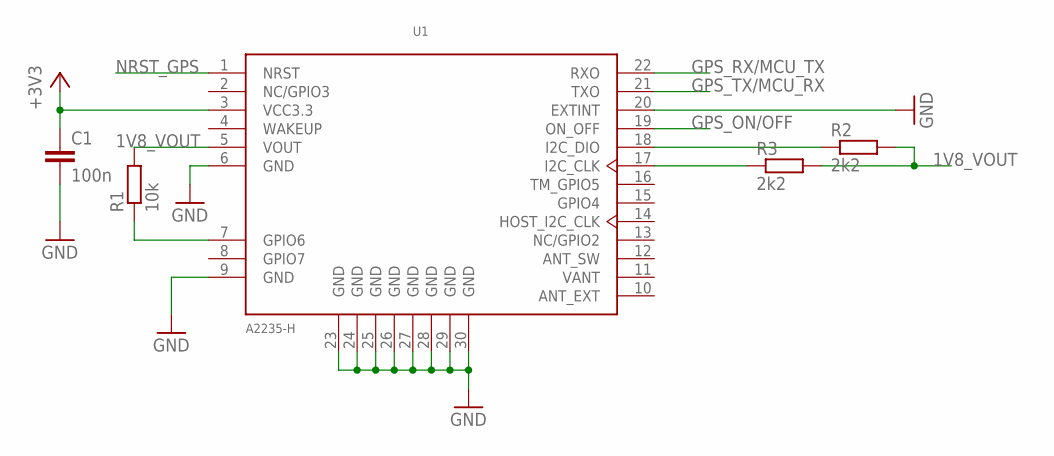
[picture p117: schematic A2235-H.sch]

Parts:
C1: 100n; C0805
R1: 10k; R0805
R2, R3: 2k2; R0805
U1: A2235-H; XCVR_A2235-H

Connections:
1V8_VOUT: R1.2, R2.2, R3.2, U1.5 (VOUT)
+3V3: C1.1, U1.3 (VCC3.3)
GND: C1.2, U1.6 (GND), U1.9 (GND), U1.20 (EXTINT), U1.23 (GND), U1.24 (GND), U1.25 (GND), U1.26 (GND), U1.27 (GND), U1.28 (GND), U1.29 (GND), U1.30 (GND)
GPS_ON/OFF: U1.19 (ON_OFF)
GPS_RX/MCU_TX: U1.22 (RXO)
GPS_TX/MCU_RX: U1.21 (TXO)
unnamed: R1.1, U1.7 (GPIO6)
unnamed: R2.1, U1.18 (I2C_DIO)
unnamed: R3.1, U1.17 (I2C_CLK)
NRST_GPS: U1.1 (NRST)
