HTheolin/Dinghy_old/D7039E och E7025E/Hårdvara/Schematics-Layouts/Schematics/Partial Schematics/BT_RN42_schematic.sch

## EAGLE design D7039E och E7025E/Hårdvara/Schematics-Layouts/Schematics/Partial Schematics/BT_RN42_schematic.sch (2017-08-30)

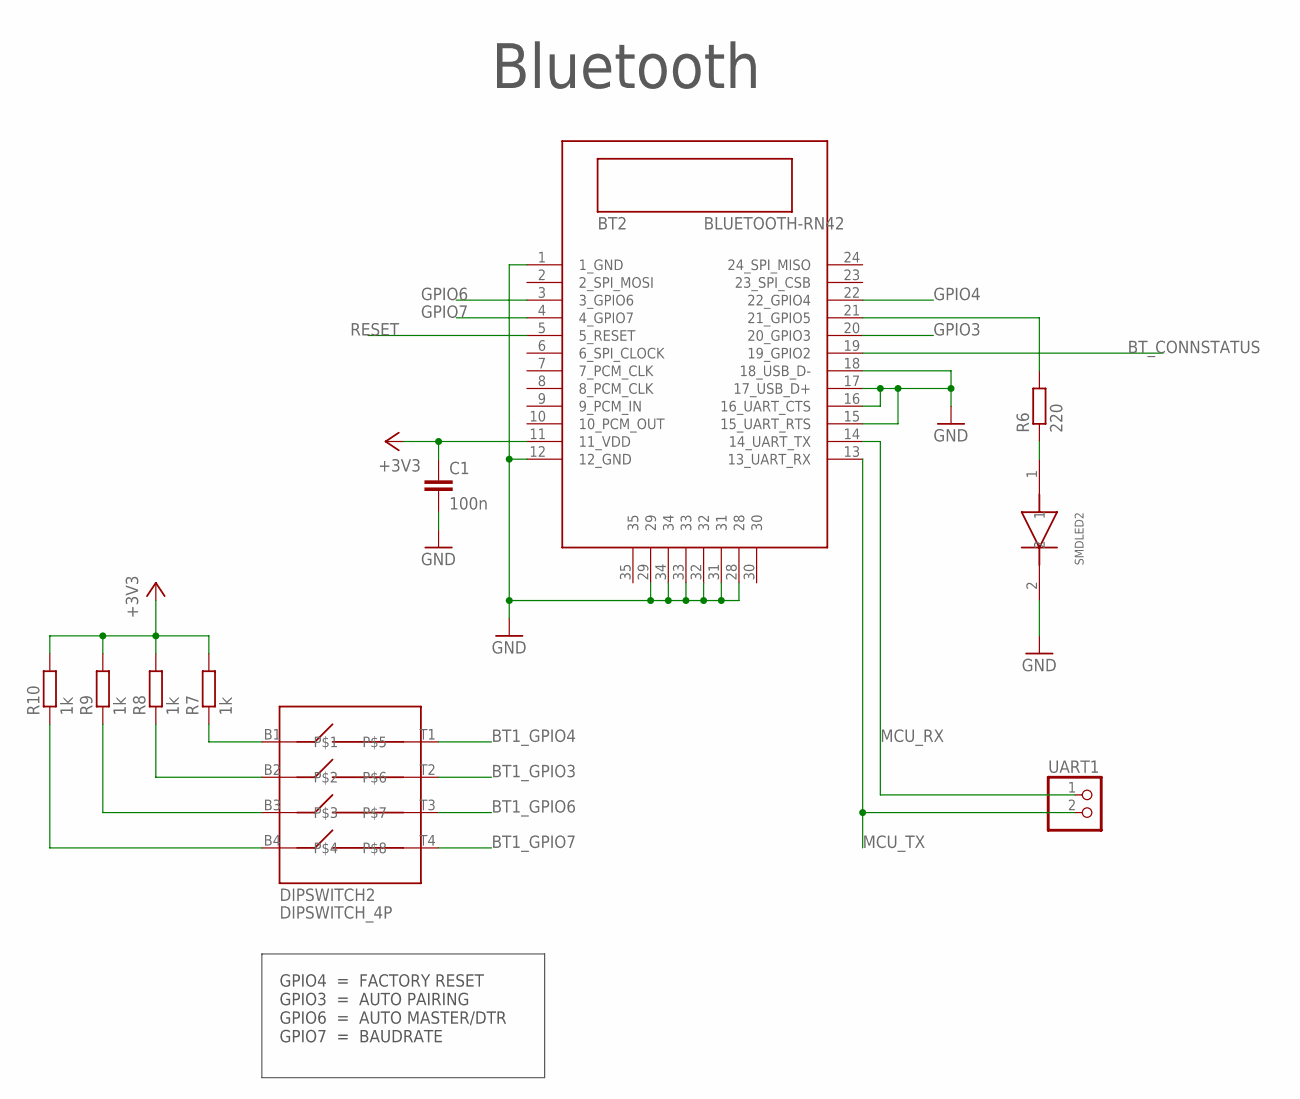
[picture p118: schematic BT_RN42_schematic.sch]

Parts:
BT2: BLUETOOTH-RN42; RN42
C1: 100n; C0805
DIPSWITCH2: DIPSWITCH_4P; DIPSWITCH4P
R6: 220; R0805
R7, R8, R9, R10: 1k; R0805
SMDLED2: SMD_LED; SMD_LED_CUSTOM
UART1: PINHD-1X2; 1X02

Connections:
+3V3: BT2.11 (11_VDD), C1.1, R7.2, R8.2, R9.2, R10.2
BT1_GPIO3: DIPSWITCH2.T2
BT1_GPIO4: DIPSWITCH2.T1
BT1_GPIO6: DIPSWITCH2.T3
BT1_GPIO7: DIPSWITCH2.T4
BT_CONNSTATUS: BT2.19 (19_GPIO2)
GND: BT2.1 (1_GND), BT2.12 (12_GND), BT2.15 (15_UART_RTS), BT2.16 (16_UART_CTS), BT2.17 (17_USB_D+), BT2.18 (18_USB_D-), BT2.28, BT2.29, BT2.31, BT2.32, BT2.33, BT2.34, C1.2, SMDLED2.2
GPIO3: BT2.20 (20_GPIO3)
GPIO4: BT2.22 (22_GPIO4)
GPIO6: BT2.3 (3_GPIO6)
GPIO7: BT2.4 (4_GPIO7)
MCU_RX: BT2.14 (14_UART_TX), UART1.1
MCU_TX: BT2.13 (13_UART_RX), UART1.2
unnamed: BT2.21 (21_GPIO5), R6.2
unnamed: DIPSWITCH2.B1, R7.1
unnamed: DIPSWITCH2.B2, R8.1
unnamed: DIPSWITCH2.B3, R9.1
unnamed: DIPSWITCH2.B4, R10.1
unnamed: R6.1, SMDLED2.1
RESET: BT2.5 (5_RESET)

Notes on the sheet:
GPIO4 = FACTORY RESET GPIO3 = AUTO PAIRING GPIO6 = AUTO MASTER/DTR GPIO7 = BAUDRATE
Bluetooth
