HTheolin/Dinghy_old/D7039E och E7025E/Hårdvara/Schematics-Layouts/Schematics/Partial Schematics/Battery_status.sch

## EAGLE design D7039E och E7025E/Hårdvara/Schematics-Layouts/Schematics/Partial Schematics/Battery_status.sch (2017-08-30)

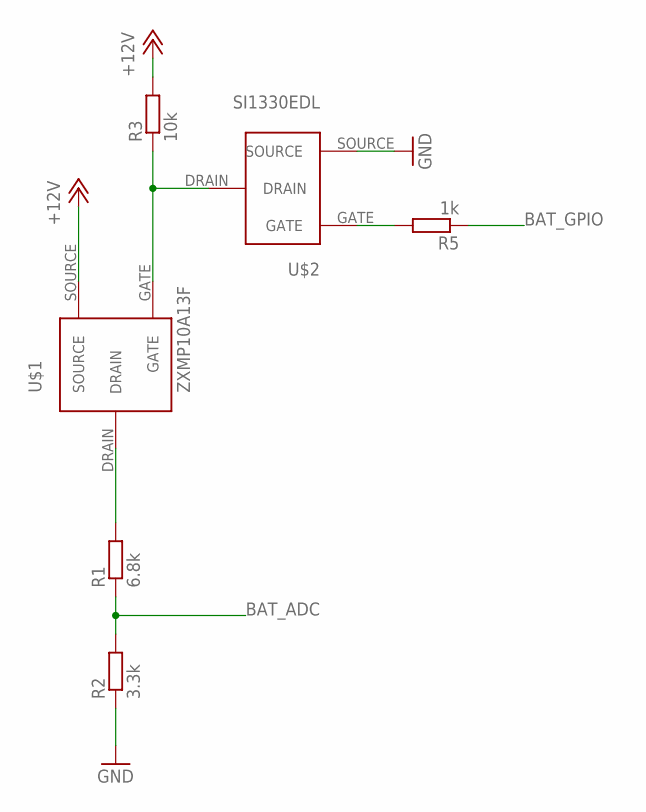
[picture p119: schematic Battery_status.sch]

Parts:
R1: 6.8k; R0805
R2: 3.3k; R0805
R3: 10k; R0805
R5: 1k; R0805
U$1: ZXMP10A13F; P-CHANNEL
U$2: SI1330EDL; SOT-323

Connections:
+12V: R3.2, U$1.SOURCE
BAT_ADC: R1.1, R2.2
BAT_GPIO: R5.1
GND: R2.1, U$2.SOURCE
unnamed: R1.2, U$1.DRAIN
unnamed: R3.1, U$1.GATE, U$2.DRAIN
unnamed: R5.2, U$2.GATE
