HTheolin/Dinghy_old/D7039E och E7025E/Hårdvara/Schematics-Layouts/Schematics/Partial Schematics/Buckconverter.sch

## EAGLE design D7039E och E7025E/Hårdvara/Schematics-Layouts/Schematics/Partial Schematics/Buckconverter.sch (2017-08-30)

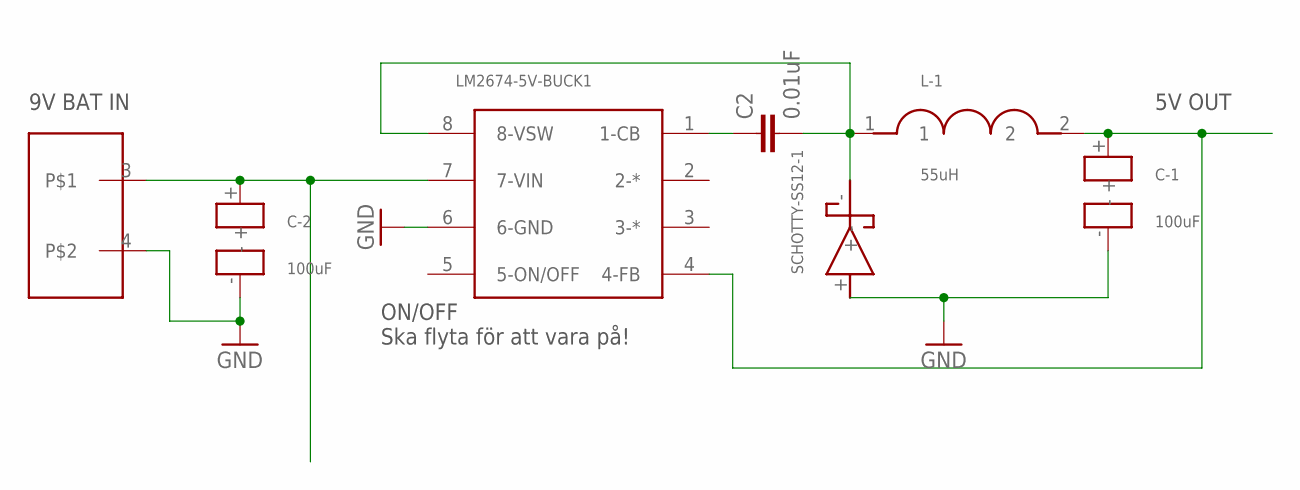
[picture p120: schematic Buckconverter.sch]

Parts:
C2: 0.01uF; C0805
C-1, C-2: 100uF; CAP-6.3MM-DIA
L-1: 55uH; INDUCTOR
LM2674-5V-BUCK1: LM2674-5VBUCK; LM2674
SCHOTTY-SS12-1: SCHOTTY-SS12; SCHOTTY
SKRUVPLINT_2P1: SKRUVPLINT_2P

Connections:
5V-OUT: C-1.+, L-1.2, LM2674-5V-BUCK1.4 (4-FB)
GND: C-1.-, C-2.-, LM2674-5V-BUCK1.6 (6-GND), SCHOTTY-SS12-1.+, SKRUVPLINT_2P1.4
unnamed: C-2.+, LM2674-5V-BUCK1.7 (7-VIN), SKRUVPLINT_2P1.3
unnamed: C2.1, LM2674-5V-BUCK1.1 (1-CB)
VOUT: C2.2, L-1.1, LM2674-5V-BUCK1.8 (8-VSW), SCHOTTY-SS12-1.-

Notes on the sheet:
9V BAT IN
5V OUT
ON/OFF Ska flyta för att vara på!
