HTheolin/Dinghy_old/D7039E och E7025E/Hårdvara/Schematics-Layouts/Schematics/Partial Schematics/Comparator.sch

## EAGLE design D7039E och E7025E/Hårdvara/Schematics-Layouts/Schematics/Partial Schematics/Comparator.sch (2017-08-30)

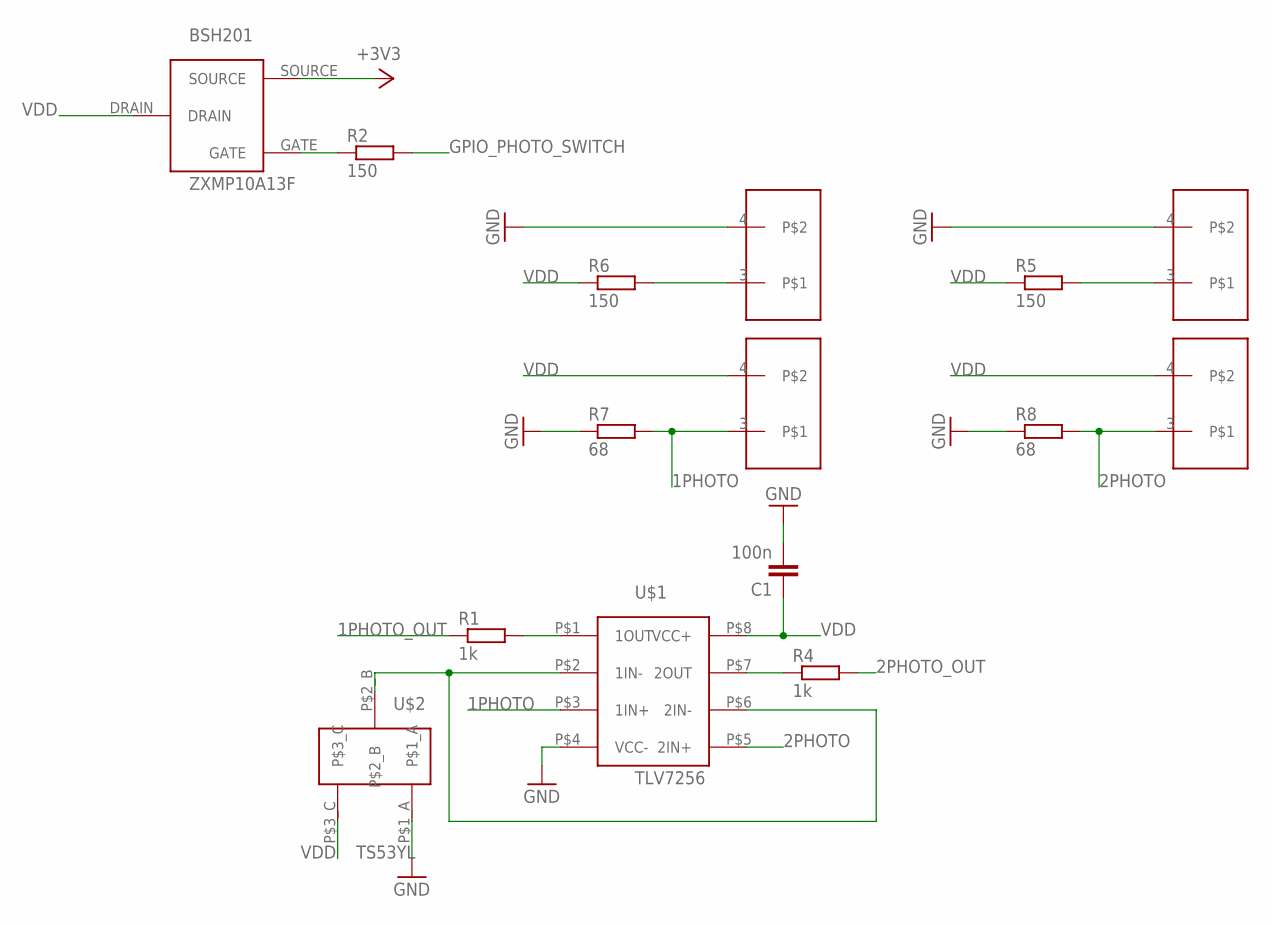
[picture p121: schematic Comparator.sch]

Parts:
BSH201: ZXMP10A13F; P-CHANNEL
C1: 100n; C0805
R1, R4: 1k; R0805
R2, R5, R6: 150; R0805
R7, R8: 68; R0805
SKRUVPLINT_2P1, SKRUVPLINT_2P2, SKRUVPLINT_2P3, SKRUVPLINT_2P4: SKRUVPLINT_2P
U$1: TLV7256; VSSOP
U$2: TS53YL; POT

Connections:
1PHOTO: R7.2, SKRUVPLINT_2P2.3, U$1.P$3 (1IN+)
1PHOTO_OUT: R1.1
2PHOTO: R8.2, SKRUVPLINT_2P4.3, U$1.P$5 (2IN+)
2PHOTO_OUT: R4.2
+3V3: BSH201.SOURCE
GND: C1.2, R7.1, R8.1, SKRUVPLINT_2P1.4, SKRUVPLINT_2P3.4, U$1.P$4 (VCC-), U$2.P$1_A
GPIO_PHOTO_SWITCH: R2.2
unnamed: U$1.P$2 (1IN-), U$1.P$6 (2IN-), U$2.P$2_B
unnamed: R1.2, U$1.P$1 (1OUT)
unnamed: R4.1, U$1.P$7 (2OUT)
unnamed: R5.2, SKRUVPLINT_2P3.3
unnamed: R6.2, SKRUVPLINT_2P1.3
unnamed: BSH201.GATE, R2.1
VDD: BSH201.DRAIN, C1.1, R5.1, R6.1, SKRUVPLINT_2P2.4, SKRUVPLINT_2P4.4, U$1.P$8 (VCC+), U$2.P$3_C
