HTheolin/Dinghy_old/D7039E och E7025E/Hårdvara/Schematics-Layouts/Schematics/Partial Schematics/MPU6000.sch

## EAGLE design D7039E och E7025E/Hårdvara/Schematics-Layouts/Schematics/Partial Schematics/MPU6000.sch (2017-08-30)

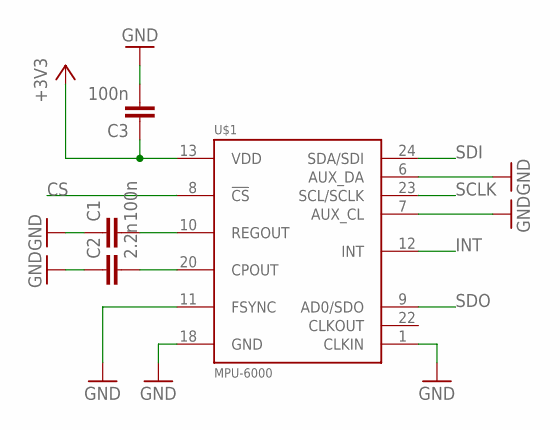
[picture p122: schematic MPU6000.sch]

Parts:
C1, C3: 100n; C0805
C2: 2.2n; C0805
U$1: MPU-6000; QFN-24

Connections:
+3V3: C3.1, U$1.13 (VDD)
CS: U$1.8 (!CS)
GND: C1.1, C2.1, C3.2, U$1.1 (CLKIN), U$1.6 (AUX_DA), U$1.7 (AUX_CL), U$1.11 (FSYNC), U$1.18 (GND)
INT: U$1.12 (INT)
unnamed: C1.2, U$1.10 (REGOUT)
unnamed: C2.2, U$1.20 (CPOUT)
SCLK: U$1.23 (SCL/SCLK)
SDI: U$1.24 (SDA/SDI)
SDO: U$1.9 (AD0/SDO)
