HTheolin/Dinghy_old/D7039E och E7025E/Hårdvara/Schematics-Layouts/Schematics/Partial Schematics/Pressure_sensor_prototype_2.sch

## EAGLE design D7039E och E7025E/Hårdvara/Schematics-Layouts/Schematics/Partial Schematics/Pressure_sensor_prototype_2.sch (2017-08-30)

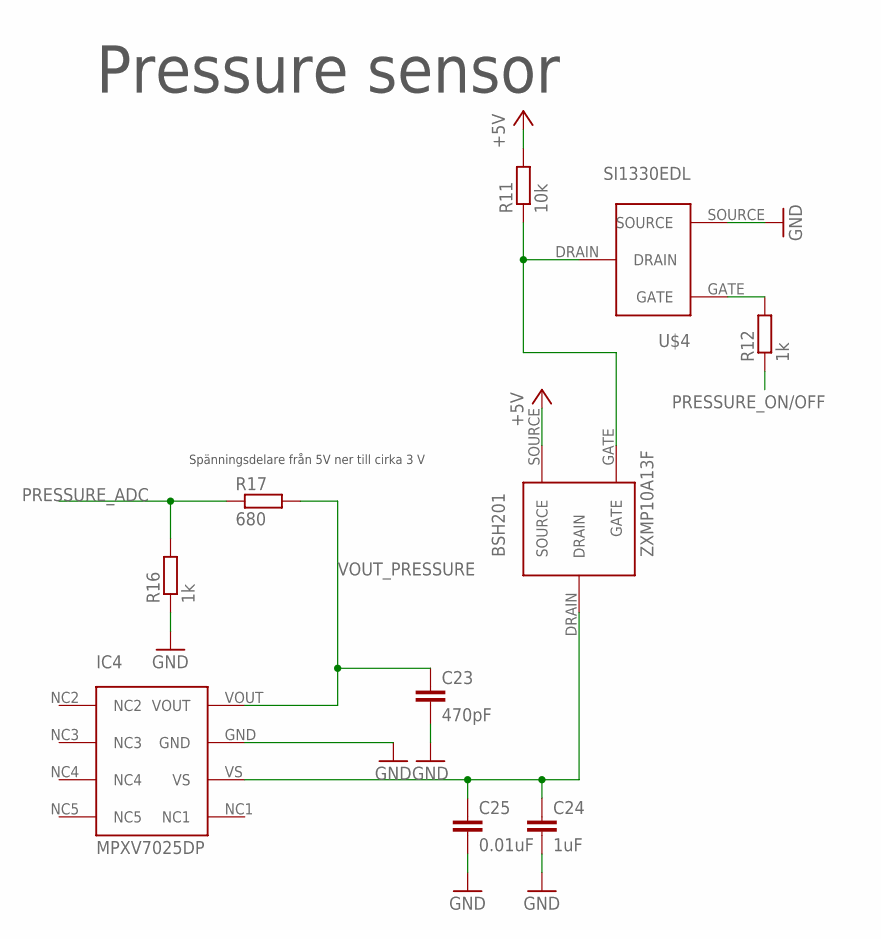
[picture p123: schematic Pressure_sensor_prototype_2.sch]

Parts:
BSH201: ZXMP10A13F; P-CHANNEL
C23: 470pF; C0805
C24: 1uF; C0805
C25: 0.01uF; C0805
IC4: MPXV7025DP; CASE1351-01
R11: 10k; R0805
R12, R16: 1k; R0805
R17: 680; R0805
U$4: SI1330EDL; SOT-323

Connections:
+5V: BSH201.SOURCE, R11.2
GND: C23.2, C24.2, C25.2, IC4.GND, R16.1, U$4.SOURCE
unnamed: BSH201.GATE, R11.1, U$4.DRAIN
unnamed: R12.2, U$4.GATE
PRESSURE_ADC: R16.2, R17.1
PRESSURE_ON/OFF: R12.1
VOUT_PRESSURE: C23.1, IC4.VOUT, R17.2
V_PRESSURE: BSH201.DRAIN, C24.1, C25.1, IC4.VS

Notes on the sheet:
Pressure sensor
Spänningsdelare från 5V ner till cirka 3 V
