HTheolin/Dinghy_old/D7039E och E7025E/Hårdvara/Schematics-Layouts/Schematics/Partial Schematics/Strain_gauge.sch

## EAGLE design D7039E och E7025E/Hårdvara/Schematics-Layouts/Schematics/Partial Schematics/Strain_gauge.sch (2017-08-30)

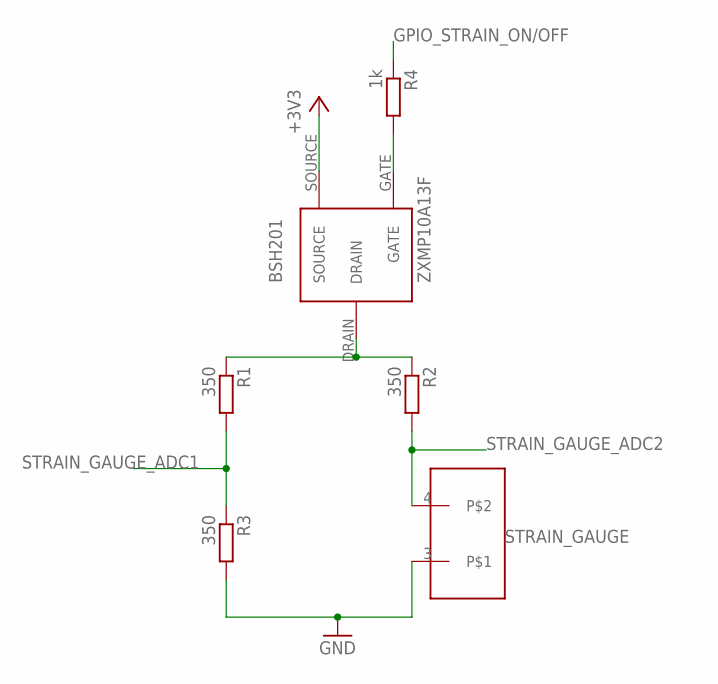
[picture p124: schematic Strain_gauge.sch]

Parts:
BSH201: ZXMP10A13F; P-CHANNEL
R1, R2, R3: 350; R0805
R4: 1k; R0805
SKRUVPLINT_2P1: SKRUVPLINT_2P

Connections:
+3V3: BSH201.SOURCE
GPIO_STRAIN_ON/OFF: R4.1
unnamed: BSH201.DRAIN, R1.1, R2.1
unnamed: BSH201.GATE, R4.2
STRAIN_GAUGE: R3.2, SKRUVPLINT_2P1.3
STRAIN_GAUGE_ADC1: R1.2, R3.1
STRAIN_GAUGE_ADC2: R2.2, SKRUVPLINT_2P1.4
