HTheolin/Dinghy_old/D7039E och E7025E/Hårdvara/Schematics-Layouts/Schematics/Partial Schematics/Strain_gauge_prototype_2.sch

## EAGLE design D7039E och E7025E/Hårdvara/Schematics-Layouts/Schematics/Partial Schematics/Strain_gauge_prototype_2.sch (2017-08-30)

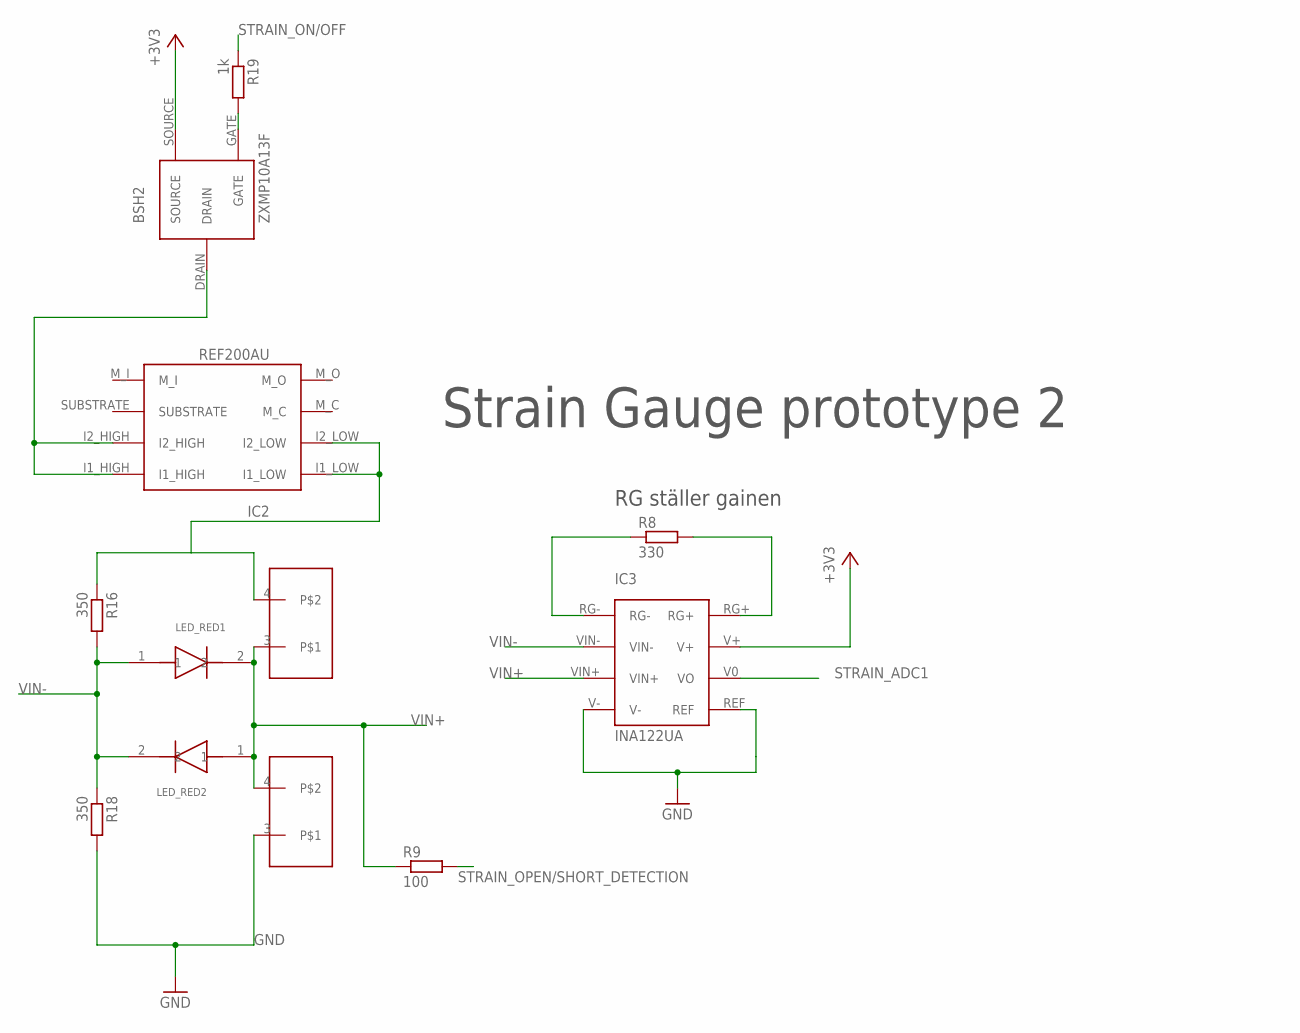
[picture p125: schematic Strain_gauge_prototype_2.sch]

Parts:
BSH2: ZXMP10A13F; P-CHANNEL
IC2: REF200AU; SOIC(8)
IC3: INA122UA; S0-8
LED_RED1, LED_RED2: SMD_LED; SMD_LED_CUSTOM
R8: 330; R0805
R9: 100; R0805
R16, R18: 350; R0805
R19: 1k; R0805
SKRUVPLINT_2P1, SKRUVPLINT_2P3: SKRUVPLINT_2P

Connections:
+3V3: BSH2.SOURCE, IC3.V+
GND: IC3.V-, R18.2, SKRUVPLINT_2P3.3
unnamed: BSH2.DRAIN, IC2.I1_HIGH, IC2.I2_HIGH
unnamed: IC3.RG-, R8.1
unnamed: IC3.RG+, R8.2
unnamed: IC2.I1_LOW, IC2.I2_LOW, R16.1, SKRUVPLINT_2P1.4
unnamed: BSH2.GATE, R19.2
STRAIN_ADC1: IC3.V0 (VO)
STRAIN_ON/OFF: R19.1
STRAIN_OPEN/SHORT_DETECTION: R9.2
VIN+: IC3.VIN+, LED_RED1.2, LED_RED2.1, R9.1, SKRUVPLINT_2P1.3, SKRUVPLINT_2P3.4
VIN-: IC3.VIN-, LED_RED1.1, LED_RED2.2, R16.2, R18.1

Notes on the sheet:
Strain Gauge prototype 2
RG ställer gainen
