HTheolin/Dinghy_old/D7039E och E7025E/Hårdvara/Schematics-Layouts/Schematics/Partial Schematics/Tryckgivare.sch

## EAGLE design D7039E och E7025E/Hårdvara/Schematics-Layouts/Schematics/Partial Schematics/Tryckgivare.sch (2017-08-30)

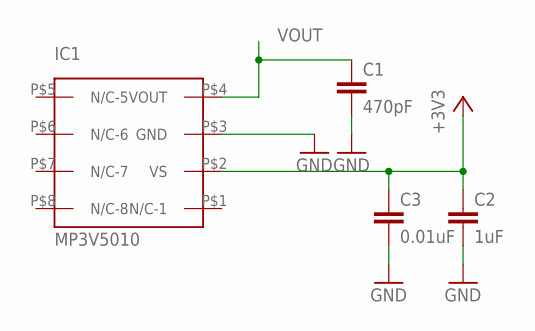
[picture p126: schematic Tryckgivare.sch]

Parts:
C1: 470pF; C0805
C2: 1uF; C0805
C3: 0.01uF; C0805
IC1: MP3V5010; CASE1351

Connections:
+3V3: C2.1, C3.1, IC1.P$2 (VS)
GND: C1.2, C2.2, C3.2, IC1.P$3 (GND)
VOUT: C1.1, IC1.P$4 (VOUT)
