HTheolin/Dinghy_old/D7039E och E7025E/Hårdvara/Schematics-Layouts/Schematics/Partial Schematics/Ultrasonic_sensor_switch.sch

## EAGLE design D7039E och E7025E/Hårdvara/Schematics-Layouts/Schematics/Partial Schematics/Ultrasonic_sensor_switch.sch (2017-08-30)

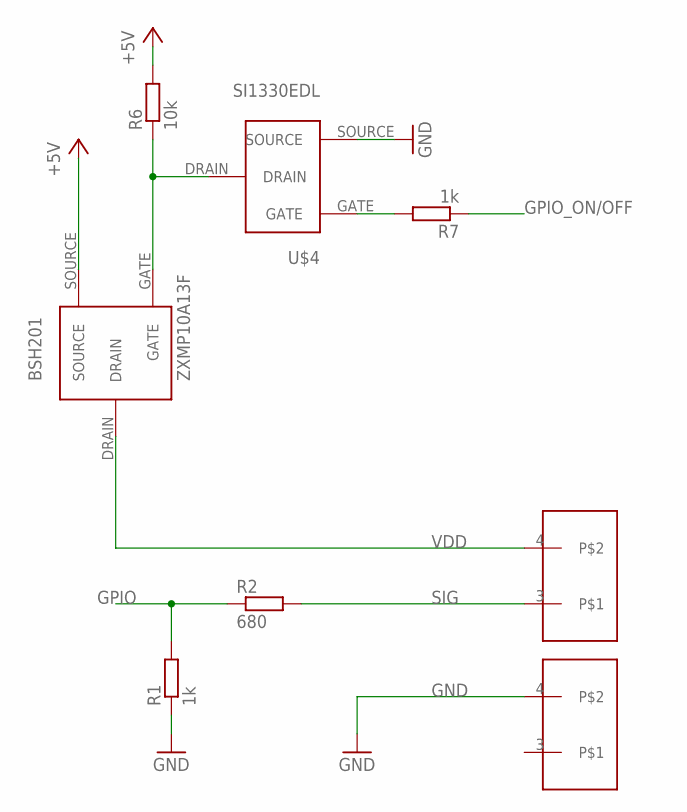
[picture p127: schematic Ultrasonic_sensor_switch.sch]

Parts:
BSH201: ZXMP10A13F; P-CHANNEL
R1, R7: 1k; R0805
R2: 680; R0805
R6: 10k; R0805
SKRUVPLINT_2P1, SKRUVPLINT_2P2: SKRUVPLINT_2P
U$4: SI1330EDL; SOT-323

Connections:
+5V: BSH201.SOURCE, R6.2
GND: R1.1, SKRUVPLINT_2P2.4, U$4.SOURCE
GPIO: R1.2, R2.1
GPIO_ON/OFF: R7.1
unnamed: BSH201.GATE, R6.1, U$4.DRAIN
unnamed: R7.2, U$4.GATE
SIG: R2.2, SKRUVPLINT_2P1.3
VDD: BSH201.DRAIN, SKRUVPLINT_2P1.4
