HTheolin/Dinghy_old/D7039E och E7025E/Hårdvara/Schematics-Layouts/Schematics/Partial Schematics/mpu-9250.sch

## EAGLE design D7039E och E7025E/Hårdvara/Schematics-Layouts/Schematics/Partial Schematics/mpu-9250.sch (2017-08-30)

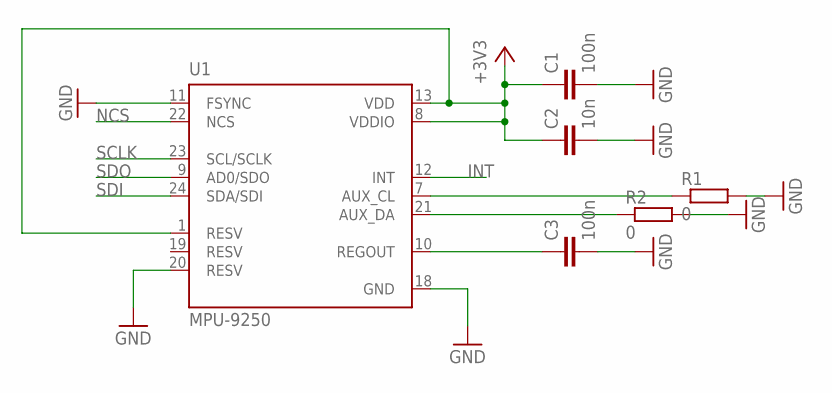
[picture p128: schematic mpu-9250.sch]

Parts:
C1, C3: 100n; C0805
C2: 10n; C0805
R1, R2: 0; R0805
U1: MPU-9250; QFN40P300X300X105-25N

Connections:
+3V3: C1.1, C2.1, U1.1 (RESV), U1.8 (VDDIO), U1.13 (VDD)
GND: C1.2, C2.2, C3.2, R1.2, R2.2, U1.11 (FSYNC), U1.18 (GND), U1.20 (RESV)
INT: U1.12 (INT)
unnamed: C3.1, U1.10 (REGOUT)
unnamed: R1.1, U1.7 (AUX_CL)
unnamed: R2.1, U1.21 (AUX_DA)
NCS: U1.22 (NCS)
SCLK: U1.23 (SCL/SCLK)
SDI: U1.24 (SDA/SDI)
SDO: U1.9 (AD0/SDO)
