HTheolin/Dinghy_old/D7039E och E7025E/Hårdvara/Schematics-Layouts/Schematics/Partial Schematics/powerpartial.sch

## EAGLE design D7039E och E7025E/Hårdvara/Schematics-Layouts/Schematics/Partial Schematics/powerpartial.sch (2017-08-30)

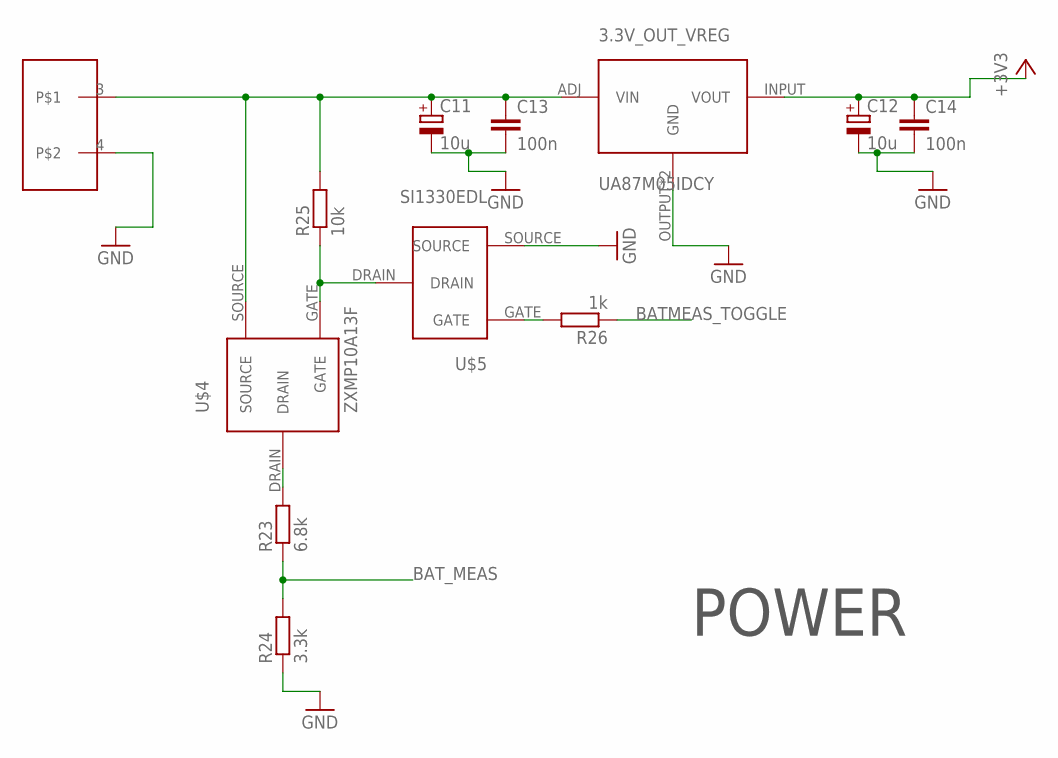
[picture p129: schematic powerpartial.sch]

Parts:
3.3V_OUT_VREG: UA87M05IDCY; SOT223
C11, C12: 10u; 153CLV-0505
C13, C14: 100n; C0805
R23: 6.8k; R0805
R24: 3.3k; R0805
R25: 10k; R0805
R26: 1k; R0805
SKRUVPLINT_2P5: SKRUVPLINT_2P
U$4: ZXMP10A13F; P-CHANNEL
U$5: SI1330EDL; SOT-323

Connections:
+3V3: 3.3V_OUT_VREG.INPUT (VOUT), C12.+, C14.1
BATMEAS_TOGGLE: R26.1
BAT_MEAS: R23.1, R24.2
GND: 3.3V_OUT_VREG.OUTPUT (GND), C11.-, C12.-, C13.2, C14.2, R24.1, SKRUVPLINT_2P5.4, U$5.SOURCE
unnamed: R23.2, U$4.DRAIN
unnamed: R25.1, U$4.GATE, U$5.DRAIN
unnamed: R26.2, U$5.GATE
unnamed: 3.3V_OUT_VREG.ADJ (VIN), C11.+, C13.1, R25.2, SKRUVPLINT_2P5.3, U$4.SOURCE

Notes on the sheet:
POWER
