HTheolin/Dinghy_old/D7039E och E7025E/Hårdvara/Schematics-Layouts/Schematics/Partial Schematics/powerpartial_proto2.sch

## EAGLE design D7039E och E7025E/Hårdvara/Schematics-Layouts/Schematics/Partial Schematics/powerpartial_proto2.sch (2017-08-30)

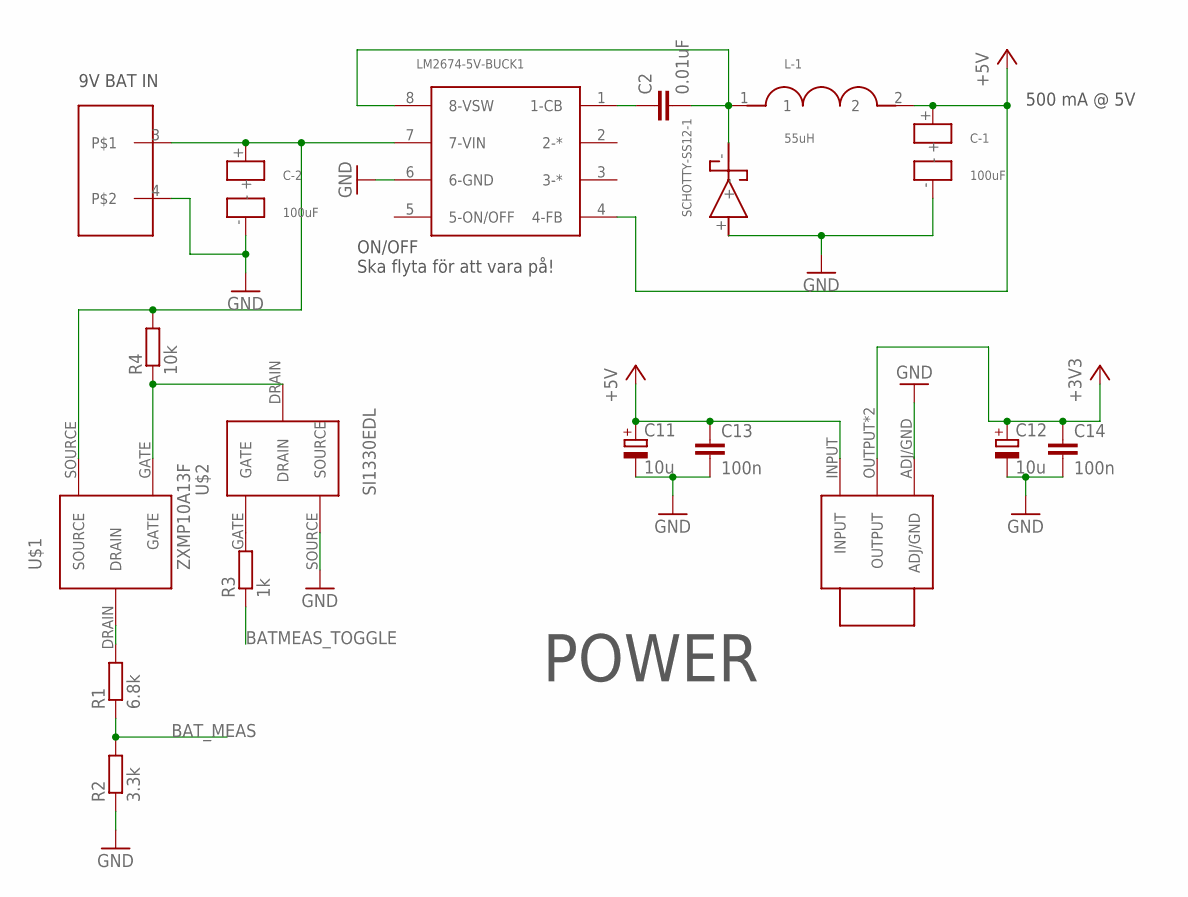
[picture p130: schematic powerpartial_proto2.sch]

Parts:
C2: 0.01uF; C0805
C11, C12: 10u; 153CLV-0505
C13, C14: 100n; C0805
C-1, C-2: 100uF; CAP-6.3MM-DIA
L-1: 55uH; INDUCTOR
LM1117-1: LM1117
LM2674-5V-BUCK1: LM2674-5VBUCK; LM2674
R1: 6.8k; R0805
R2: 3.3k; R0805
R3: 1k; R0805
R4: 10k; R0805
SCHOTTY-SS12-1: SCHOTTY-SS12; SCHOTTY
SKRUVPLINT_2P1: SKRUVPLINT_2P
U$1: ZXMP10A13F; P-CHANNEL
U$2: SI1330EDL; SOT-323

Connections:
+3V3: C12.+, C14.1, LM1117-1.OUTPUT
+5V: C11.+, C13.1, C-1.+, L-1.2, LM1117-1.INPUT, LM2674-5V-BUCK1.4 (4-FB)
BATMEAS_TOGGLE: R3.1
BATSUP: C-2.+, LM2674-5V-BUCK1.7 (7-VIN), R4.2, SKRUVPLINT_2P1.3, U$1.SOURCE
BAT_MEAS: R1.1, R2.2
GND: C11.-, C12.-, C13.2, C14.2, C-1.-, C-2.-, LM1117-1.ADJ/GND, LM2674-5V-BUCK1.6 (6-GND), R2.1, SCHOTTY-SS12-1.+, SKRUVPLINT_2P1.4, U$2.SOURCE
unnamed: R1.2, U$1.DRAIN
unnamed: C2.1, LM2674-5V-BUCK1.1 (1-CB)
unnamed: R3.2, U$2.GATE
unnamed: R4.1, U$1.GATE, U$2.DRAIN
VOUT: C2.2, L-1.1, LM2674-5V-BUCK1.8 (8-VSW), SCHOTTY-SS12-1.-

Notes on the sheet:
POWER
9V BAT IN
ON/OFF Ska flyta för att vara på!
500 mA @ 5V
