HTheolin/Dinghy_old/D7039E och E7025E/Hårdvara/Schematics-Layouts/Schematics/Prototyp 2/Centerboard - Prototype 2_WIP.sch

## EAGLE design D7039E och E7025E/Hårdvara/Schematics-Layouts/Schematics/Prototyp 2/Centerboard - Prototype 2_WIP.sch (2017-08-30)

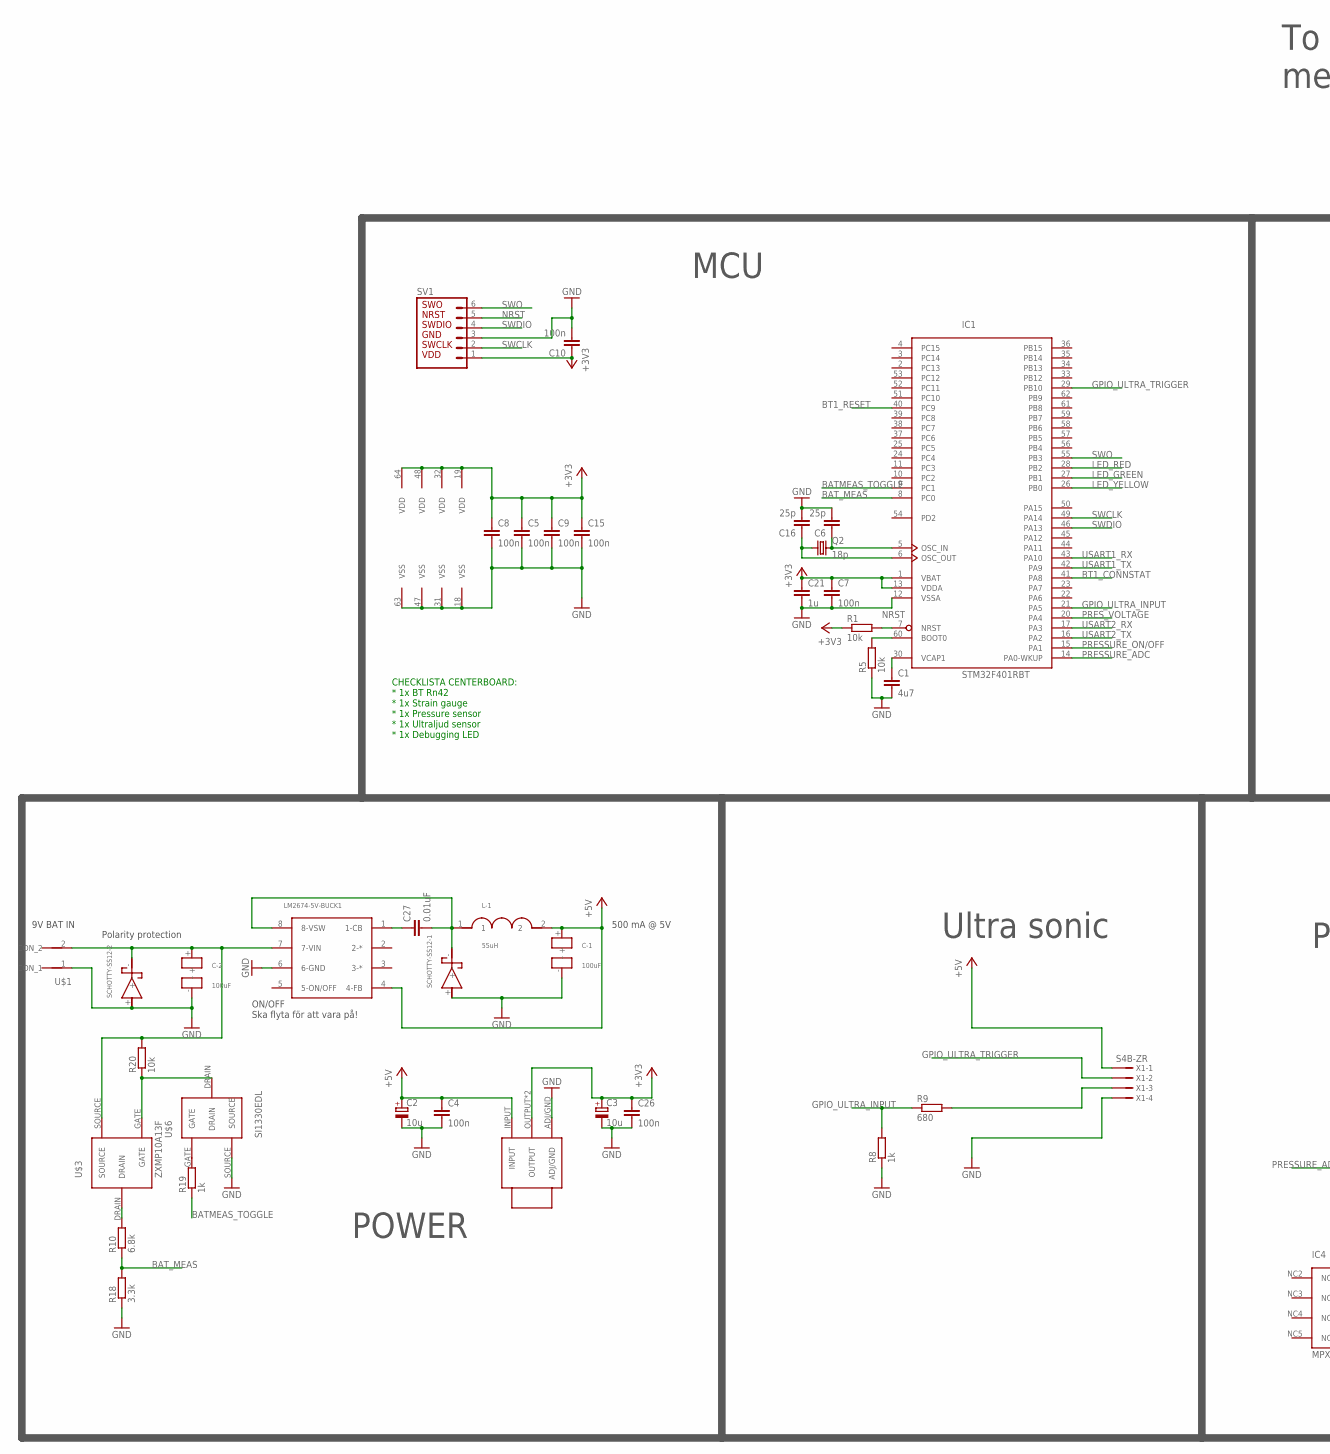
[picture p131: schematic Centerboard - Prototype 2_WIP.sch, part in row 1, column 1]

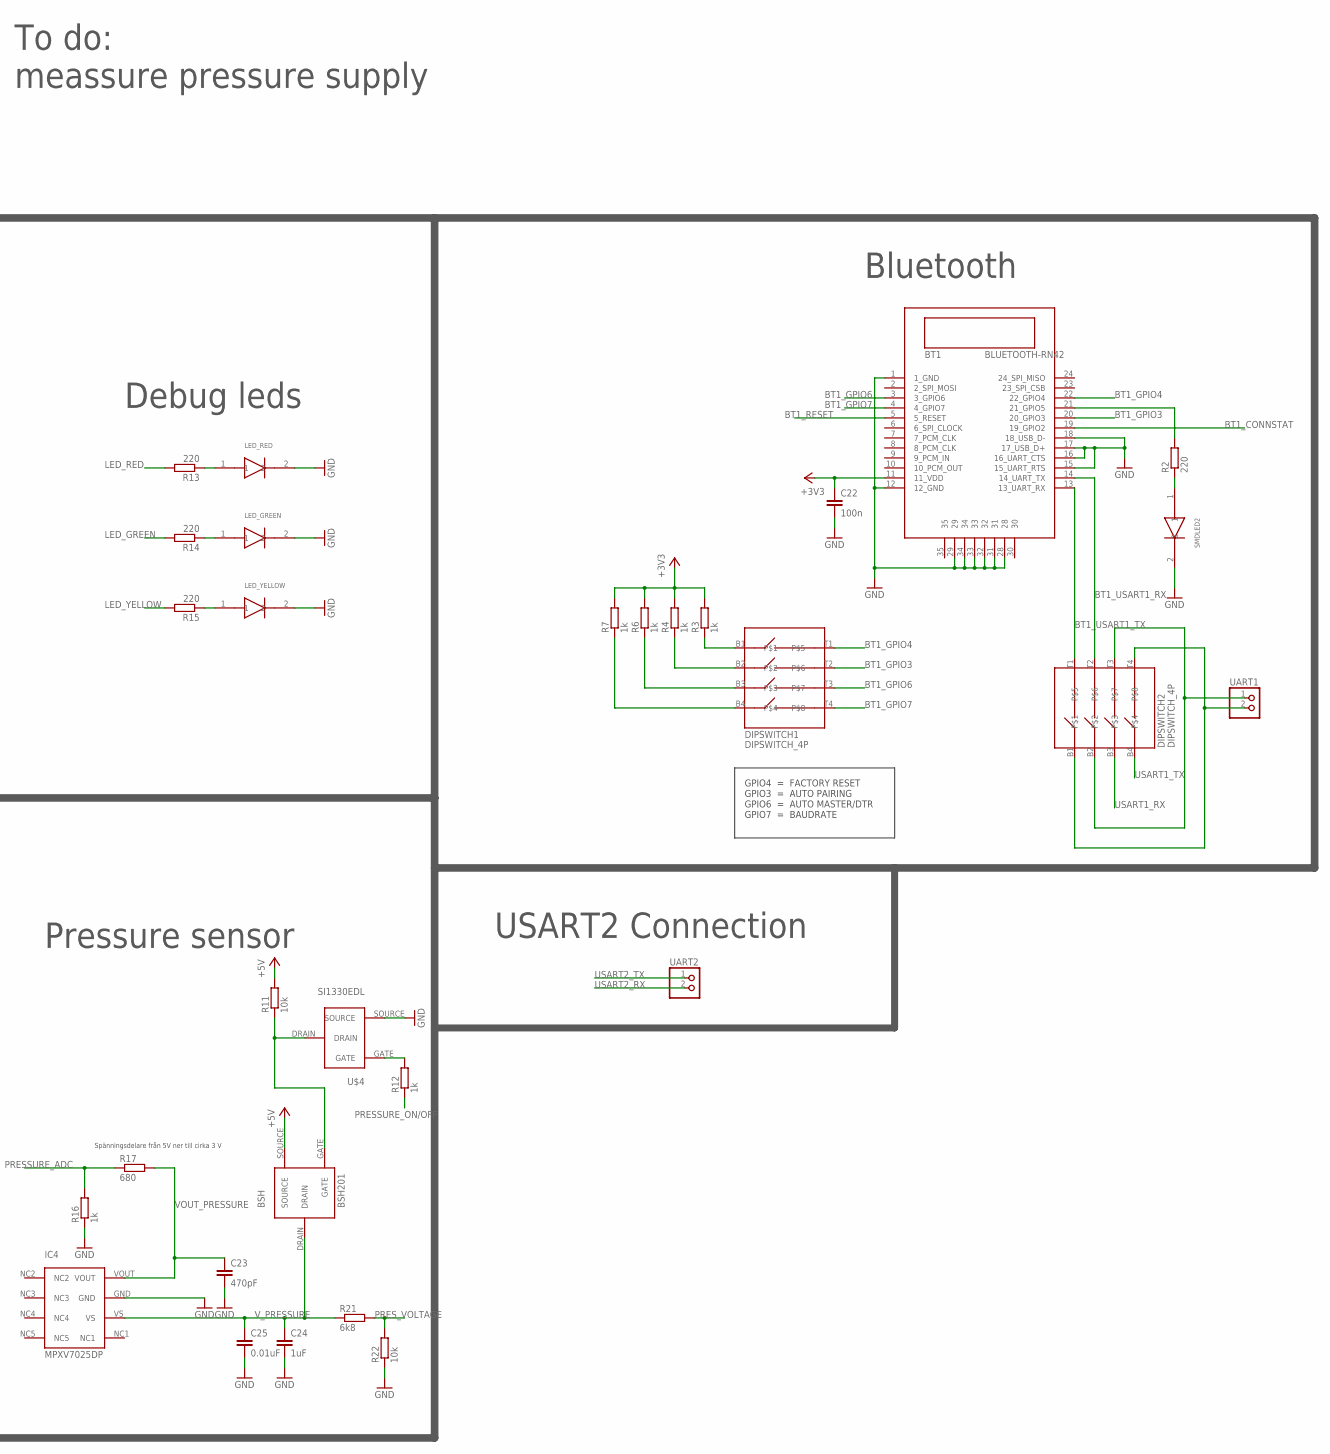
[picture p132: schematic Centerboard - Prototype 2_WIP.sch, part in row 1, column 2]

Parts:
BSH: BSH201; P-CHANNEL
BT1: BLUETOOTH-RN42; RN42
C1: 4u7; C0805
C2, C3: 10u; 153CLV-0505
C4, C5, C7, C8, C9, C10, C15, C22, C26: 100n; C0805
C6, C16: 25p; C0805
C21: 1u; C0805
C23: 470pF; C0805
C24: 1uF; C0805
C25, C27: 0.01uF; C0805
C-1, C-2: 100uF; CAP-6.3MM-DIA
DIPSWITCH1, DIPSWITCH2: DIPSWITCH_4P; DIPSWITCH4P
IC1: STM32F401RBT; LQFP64
IC4: MPXV7025DP; CASE1351-01
L-1: 55uH; INDUCTOR
LED_GREEN: SMD_LED; SMD_LED_CUSTOM
LED_RED: SMD_LED; SMD_LED_CUSTOM
LED_YELLOW: SMD_LED; SMD_LED_CUSTOM
LM1117-1: LM1117
LM2674-5V-BUCK1: LM2674-5VBUCK; LM2674
Q2: 18p; HC49UP
R1, R5, R11, R20, R22: 10k; R0805
R2, R13, R14, R15: 220; R0805
R3, R4, R6, R7, R8, R12, R16, R19: 1k; R0805
R9, R17: 680; R0805
R10: 6.8k; R0805
R18: 3.3k; R0805
R21: 6k8; R0805
SCHOTTY-SS12-1, SCHOTTY-SS12-2: SCHOTTY-SS12; SCHOTTY
SMDLED2: SMD_LED; SMD_LED_CUSTOM
SV1: MA06-1
U$1: JST-2WAYS
U$3: ZXMP10A13F; P-CHANNEL
U$4, U$6: SI1330EDL; SOT-323
UART1, UART2: PINHD-1X2; 1X02
X1: S4B-ZR

Connections:
+3V3: BT1.11 (11_VDD), C3.+, C5.1, C7.1, C8.1, C9.1, C10.1, C15.1, C21.1, C22.1, C26.1, IC1.1 (VBAT), IC1.13 (VDDA), IC1.19 (VDD), IC1.32 (VDD), IC1.48 (VDD), IC1.64 (VDD), LM1117-1.OUTPUT, R1.1, R3.2, R4.2, R6.2, R7.2, SV1.1
+5V: BSH.SOURCE, C2.+, C4.1, C-1.+, L-1.2, LM1117-1.INPUT, LM2674-5V-BUCK1.4 (4-FB), R11.2, X1.1
BATMEAS_TOGGLE: IC1.9 (PC1), R19.1
BATSUP: C-2.+, LM2674-5V-BUCK1.7 (7-VIN), R20.2, SCHOTTY-SS12-2.-, U$1.2 (CON_2), U$3.SOURCE
BAT_MEAS: IC1.8 (PC0), R10.1, R18.2
BT1_CONNSTAT: BT1.19 (19_GPIO2), IC1.41 (PA8)
BT1_GPIO3: BT1.20 (20_GPIO3), DIPSWITCH1.T2
BT1_GPIO4: BT1.22 (22_GPIO4), DIPSWITCH1.T1
BT1_GPIO6: BT1.3 (3_GPIO6), DIPSWITCH1.T3
BT1_GPIO7: BT1.4 (4_GPIO7), DIPSWITCH1.T4
BT1_RESET: BT1.5 (5_RESET), IC1.40 (PC9)
BT1_USART1_RX: BT1.14 (14_UART_TX), DIPSWITCH2.T2
BT1_USART1_TX: BT1.13 (13_UART_RX), DIPSWITCH2.T1
GND: BT1.1 (1_GND), BT1.12 (12_GND), BT1.15 (15_UART_RTS), BT1.16 (16_UART_CTS), BT1.17 (17_USB_D+), BT1.18 (18_USB_D-), BT1.28, BT1.29, BT1.31, BT1.32, BT1.33, BT1.34, C1.2, C2.-, C3.-, C4.2, C5.2, C6.2, C7.2, C8.2, C9.2, C10.2, C15.2, C16.2, C21.2, C22.2, C23.2, C24.2, C25.2, C26.2, C-1.-, C-2.-, IC1.12 (VSSA), IC1.18 (VSS), IC1.31 (VSS), IC1.47 (VSS), IC1.63 (VSS), IC4.GND, LED_GREEN.2, LED_RED.2, LED_YELLOW.2, LM1117-1.ADJ/GND, LM2674-5V-BUCK1.6 (6-GND), R5.1, R8.1, R16.1, R18.1, R22.1, SCHOTTY-SS12-1.+, SCHOTTY-SS12-2.+, SMDLED2.2, SV1.3, U$1.1 (CON_1), U$4.SOURCE, U$6.SOURCE, X1.4
GPIO_ULTRA_INPUT: IC1.21 (PA5), R8.2, R9.1
GPIO_ULTRA_TRIGGER: IC1.29 (PB10), X1.2
LED_GREEN: IC1.27 (PB1), R14.2
LED_RED: IC1.28 (PB2), R13.2
LED_YELLOW: IC1.26 (PB0), R15.2
unnamed: C1.1, IC1.30 (VCAP1)
unnamed: IC1.60 (BOOT0), R5.2
unnamed: LED_RED.1, R13.1
unnamed: BT1.21 (21_GPIO5), R2.2
unnamed: DIPSWITCH1.B1, R3.1
unnamed: DIPSWITCH1.B2, R4.1
unnamed: DIPSWITCH1.B3, R6.1
unnamed: C6.1, IC1.5 (OSC_IN), Q2.2
unnamed: C16.1, IC1.6 (OSC_OUT), Q2.1
unnamed: DIPSWITCH1.B4, R7.1
unnamed: R2.1, SMDLED2.1
unnamed: R9.2, X1.3
unnamed: C27.1, LM2674-5V-BUCK1.1 (1-CB)
unnamed: BSH.GATE, R11.1, U$4.DRAIN
unnamed: R12.2, U$4.GATE
unnamed: LED_GREEN.1, R14.1
unnamed: LED_YELLOW.1, R15.1
unnamed: R10.2, U$3.DRAIN
unnamed: R19.2, U$6.GATE
unnamed: R20.1, U$3.GATE, U$6.DRAIN
unnamed: DIPSWITCH2.B2, DIPSWITCH2.T3, UART1.1
unnamed: DIPSWITCH2.B1, DIPSWITCH2.T4, UART1.2
NRST: IC1.7 (NRST), R1.2, SV1.5
PRESSURE_ADC: IC1.14 (PA0-WKUP), R16.2, R17.1
PRESSURE_ON/OFF: IC1.15 (PA1), R12.1
PRES_VOLTAGE: IC1.20 (PA4), R21.2, R22.2
SWCLK: IC1.49 (PA14), SV1.2
SWDIO: IC1.46 (PA13), SV1.4
SWO: IC1.55 (PB3), SV1.6
USART1_RX: DIPSWITCH2.B3, IC1.43 (PA10)
USART1_TX: DIPSWITCH2.B4, IC1.42 (PA9)
USART2_RX: IC1.17 (PA3), UART2.2
USART2_TX: IC1.16 (PA2), UART2.1
VOUT: C27.2, L-1.1, LM2674-5V-BUCK1.8 (8-VSW), SCHOTTY-SS12-1.-
VOUT_PRESSURE: C23.1, IC4.VOUT, R17.2
V_PRESSURE: BSH.DRAIN, C24.1, C25.1, IC4.VS, R21.1

Notes on the sheet:
GPIO4 = FACTORY RESET GPIO3 = AUTO PAIRING GPIO6 = AUTO MASTER/DTR GPIO7 = BAUDRATE
CHECKLISTA CENTERBOARD: * 1x BT Rn42 * 1x Strain gauge * 1x Pressure sensor * 1x Ultraljud sensor * 1x Debugging LED
Ultra sonic
Bluetooth
Debug leds
MCU
USART2 Connection
Pressure sensor
Spänningsdelare från 5V ner till cirka 3 V
POWER
9V BAT IN
ON/OFF Ska flyta för att vara på!
500 mA @ 5V
Polarity protection
To do: meassure pressure supply
