HTheolin/Dinghy_old/D7039E och E7025E/Hårdvara/Schematics-Layouts/Schematics/Prototyp 2/Mainboard - Prototyp 2.sch

## EAGLE design D7039E och E7025E/Hårdvara/Schematics-Layouts/Schematics/Prototyp 2/Mainboard - Prototyp 2.sch (2017-08-30)

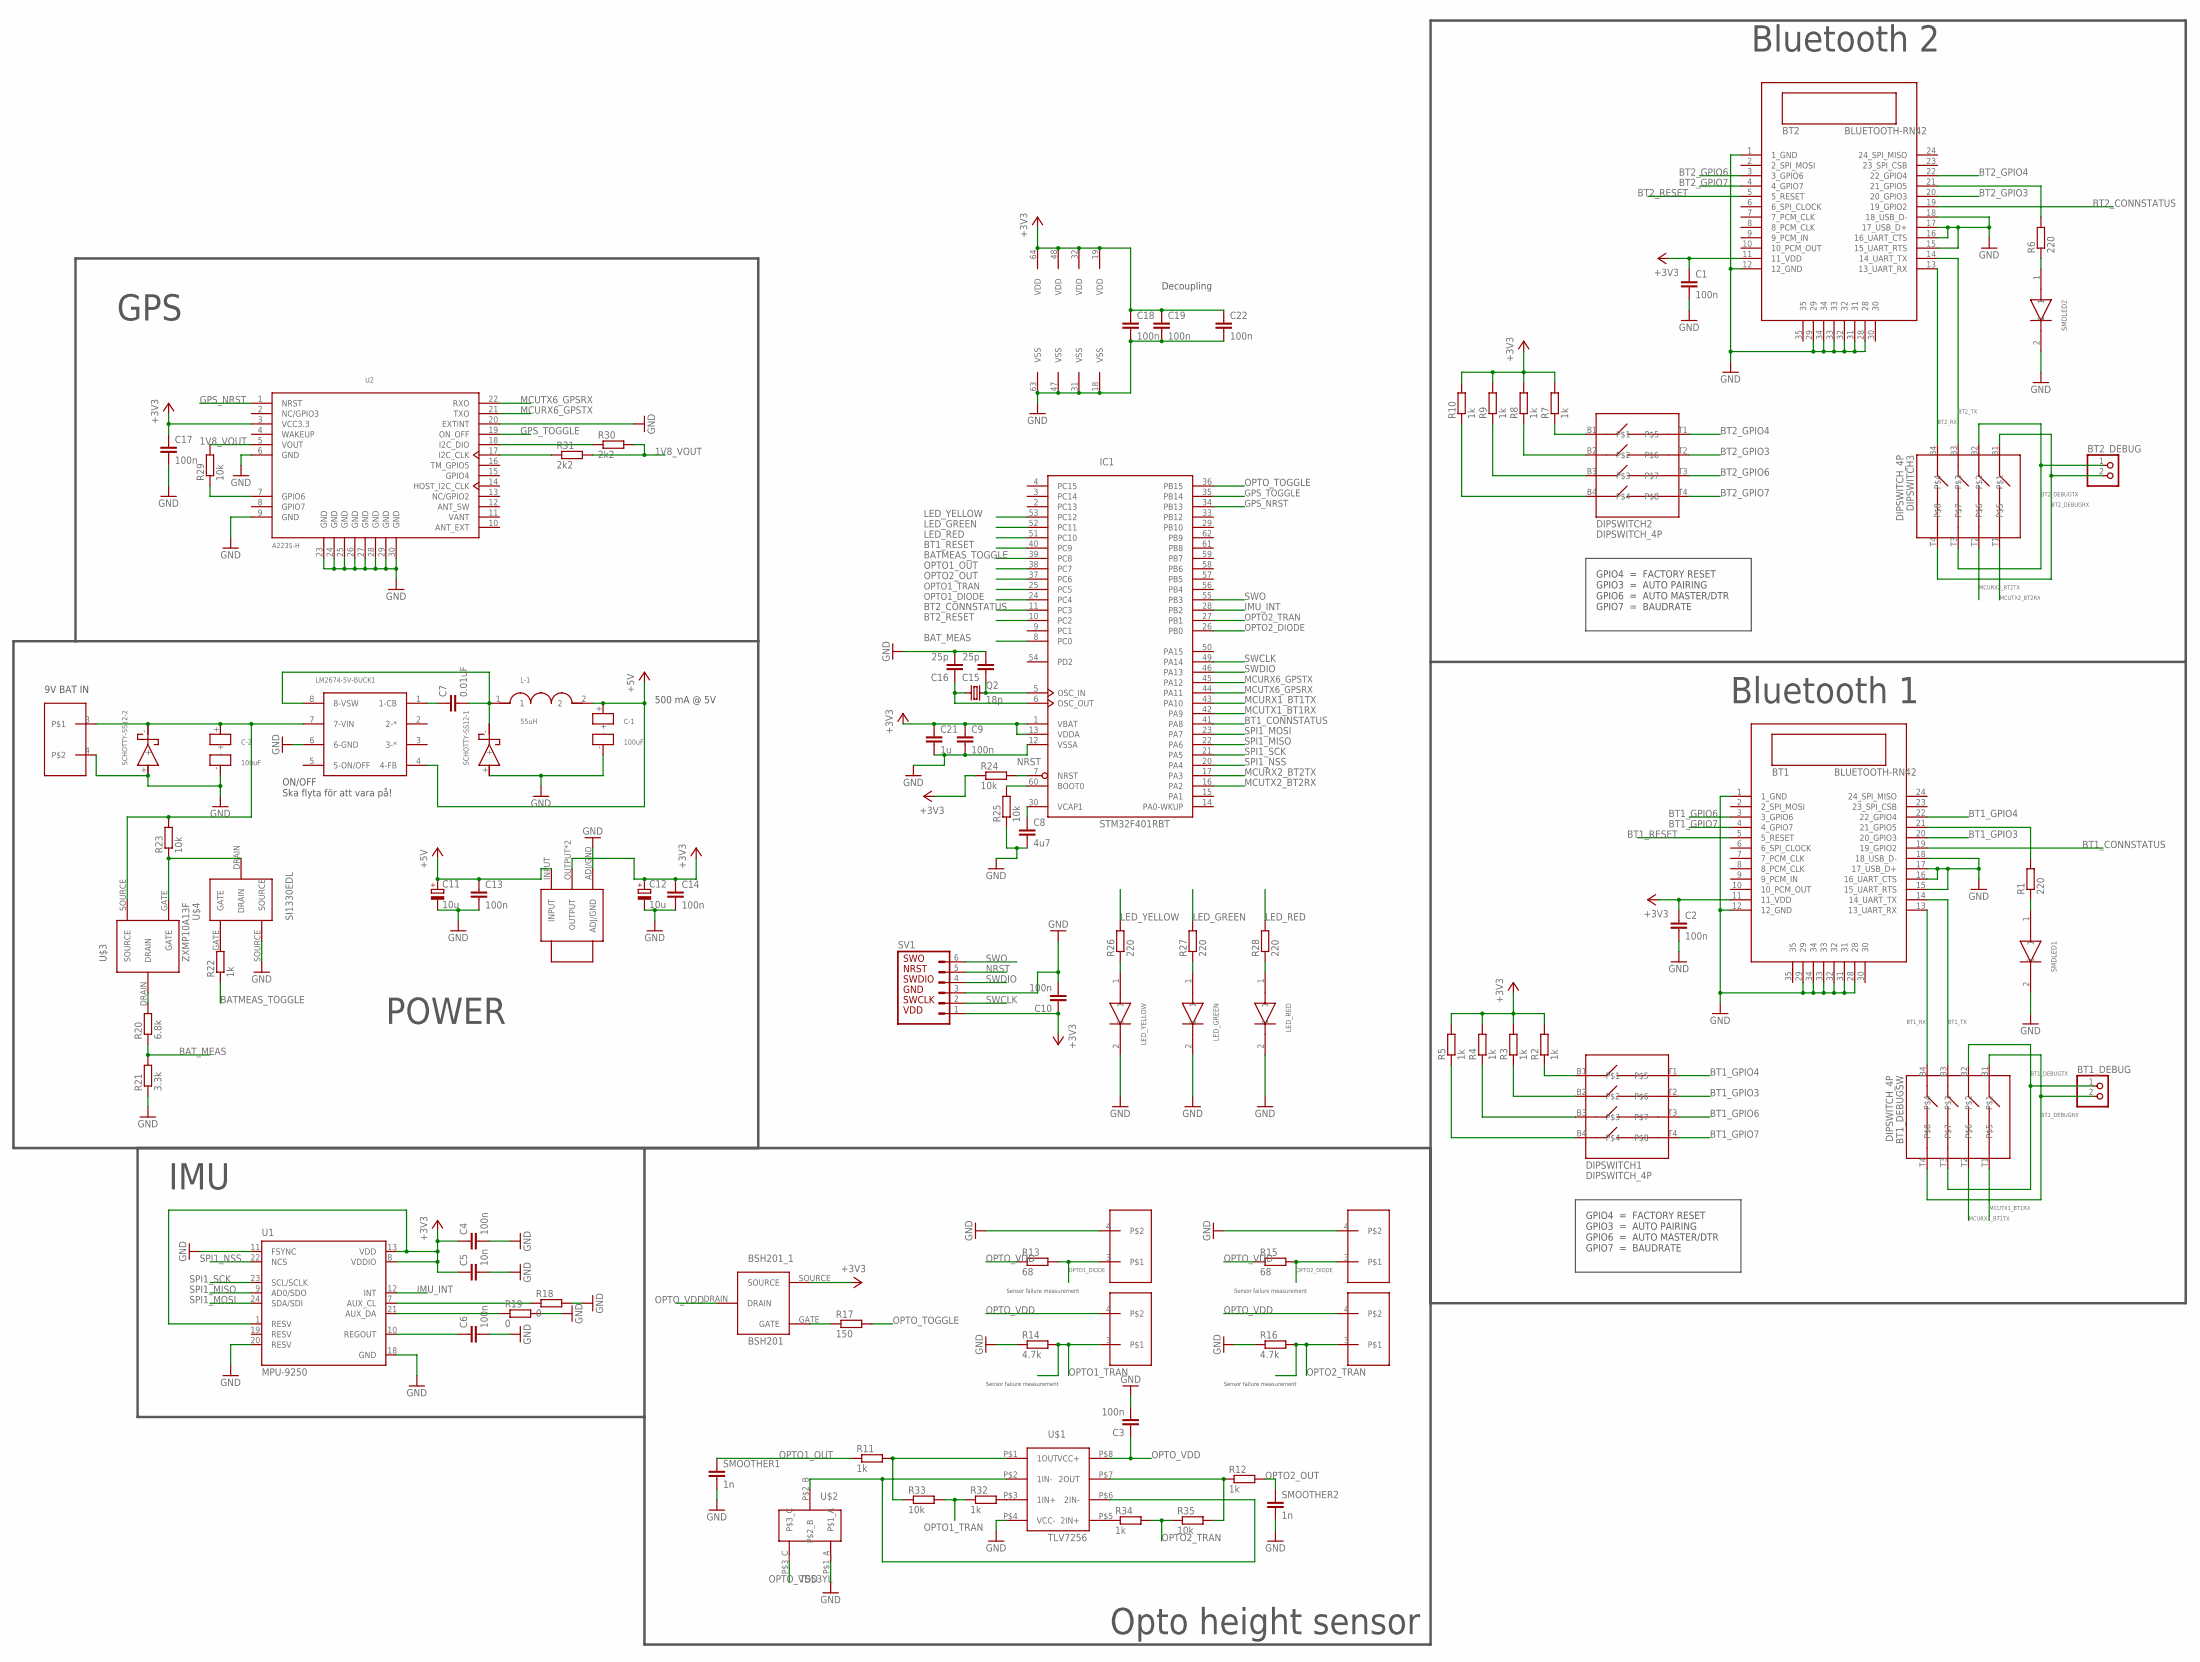
[picture p133: schematic Mainboard - Prototyp 2.sch]

Parts:
BSH201_1: BSH201; P-CHANNEL
BT1, BT2: BLUETOOTH-RN42; RN42
BT1_DEBUG, BT2_DEBUG: PINHD-1X2; 1X02
BT1_DEBUGSW: DIPSWITCH_4P; DIPSWITCH4P
C1, C2, C3, C4, C6, C9, C10, C13, C14, C17, C18, C19, C22: 100n; C0805
C5: 10n; C0805
C7: 0.01uF; C0805
C8: 4u7; C0805
C11, C12: 10u; 153CLV-0505
C15, C16: 25p; C0805
C21: 1u; C0805
C-1, C-2: 100uF; CAP-6.3MM-DIA
DIPSWITCH1, DIPSWITCH2, DIPSWITCH3: DIPSWITCH_4P; DIPSWITCH4P
IC1: STM32F401RBT; LQFP64
L-1: 55uH; INDUCTOR
LED_GREEN: SMD_LED; SMD_LED_CUSTOM
LED_RED: SMD_LED; SMD_LED_CUSTOM
LED_YELLOW: SMD_LED; SMD_LED_CUSTOM
LM1117-1: LM1117
LM2674-5V-BUCK1: LM2674-5VBUCK; LM2674
Q2: 18p; HC49UP
R1, R6, R26, R27, R28: 220; R0805
R2, R3, R4, R5, R7, R8, R9, R10, R11, R12, R22, R32, R34: 1k; R0805
R13, R15: 68; R0805
R14, R16: 4.7k; R0805
R17: 150; R0805
R18, R19: 0; R0805
R20: 6.8k; R0805
R21: 3.3k; R0805
R23, R24, R25, R29, R33, R35: 10k; R0805
R30, R31: 2k2; R0805
SCHOTTY-SS12-1, SCHOTTY-SS12-2: SCHOTTY-SS12; SCHOTTY
SKRUVPLINT_2P1, SKRUVPLINT_2P2, SKRUVPLINT_2P3, SKRUVPLINT_2P4, SKRUVPLINT_2P5: SKRUVPLINT_2P
SMDLED1, SMDLED2: SMD_LED; SMD_LED_CUSTOM
SMOOTHER1, SMOOTHER2: 1n; C0805
SV1: MA06-1
U1: MPU-9250; QFN40P300X300X105-25N
U2: A2235-H; XCVR_A2235-H
U$1: TLV7256; VSSOP
U$2: TS53YL; POT
U$3: ZXMP10A13F; P-CHANNEL
U$4: SI1330EDL; SOT-323

Connections:
1V8_VOUT: R29.2, R30.2, R31.2, U2.5 (VOUT)
+3V3: BSH201_1.SOURCE, BT1.11 (11_VDD), BT2.11 (11_VDD), C1.1, C2.1, C4.1, C5.1, C9.1, C10.1, C12.+, C14.1, C17.1, C18.1, C19.1, C21.1, C22.1, IC1.1 (VBAT), IC1.13 (VDDA), IC1.19 (VDD), IC1.32 (VDD), IC1.48 (VDD), IC1.64 (VDD), LM1117-1.OUTPUT, R2.2, R3.2, R4.2, R5.2, R7.2, R8.2, R9.2, R10.2, R24.1, SV1.1, U1.1 (RESV), U1.8 (VDDIO), U1.13 (VDD), U2.3 (VCC3.3)
+5V: C11.+, C13.1, C-1.+, L-1.2, LM1117-1.INPUT, LM2674-5V-BUCK1.4 (4-FB)
BATMEAS_TOGGLE: IC1.39 (PC8), R22.1
BATSUP: C-2.+, LM2674-5V-BUCK1.7 (7-VIN), R23.2, SCHOTTY-SS12-2.-, SKRUVPLINT_2P5.3, U$3.SOURCE
BAT_MEAS: IC1.8 (PC0), R20.1, R21.2
BT1_CONNSTATUS: BT1.19 (19_GPIO2), IC1.41 (PA8)
BT1_DEBUGRX: BT1_DEBUG.2, BT1_DEBUGSW.B1, BT1_DEBUGSW.T4
BT1_DEBUGTX: BT1_DEBUG.1, BT1_DEBUGSW.B2, BT1_DEBUGSW.T3
BT1_GPIO3: BT1.20 (20_GPIO3), DIPSWITCH1.T2
BT1_GPIO4: BT1.22 (22_GPIO4), DIPSWITCH1.T1
BT1_GPIO6: BT1.3 (3_GPIO6), DIPSWITCH1.T3
BT1_GPIO7: BT1.4 (4_GPIO7), DIPSWITCH1.T4
BT1_RESET: BT1.5 (5_RESET), IC1.40 (PC9)
BT1_RX: BT1.13 (13_UART_RX), BT1_DEBUGSW.B4
BT1_TX: BT1.14 (14_UART_TX), BT1_DEBUGSW.B3
BT2_CONNSTATUS: BT2.19 (19_GPIO2), IC1.11 (PC3)
BT2_DEBUGRX: BT2_DEBUG.2, DIPSWITCH3.B1, DIPSWITCH3.T4
BT2_DEBUGTX: BT2_DEBUG.1, DIPSWITCH3.B2, DIPSWITCH3.T3
BT2_GPIO3: BT2.20 (20_GPIO3), DIPSWITCH2.T2
BT2_GPIO4: BT2.22 (22_GPIO4), DIPSWITCH2.T1
BT2_GPIO6: BT2.3 (3_GPIO6), DIPSWITCH2.T3
BT2_GPIO7: BT2.4 (4_GPIO7), DIPSWITCH2.T4
BT2_RESET: BT2.5 (5_RESET), IC1.10 (PC2)
BT2_RX: BT2.13 (13_UART_RX), DIPSWITCH3.B4
BT2_TX: BT2.14 (14_UART_TX), DIPSWITCH3.B3
GND: BT1.1 (1_GND), BT1.12 (12_GND), BT1.15 (15_UART_RTS), BT1.16 (16_UART_CTS), BT1.17 (17_USB_D+), BT1.18 (18_USB_D-), BT1.28, BT1.29, BT1.31, BT1.32, BT1.33, BT1.34, BT2.1 (1_GND), BT2.12 (12_GND), BT2.15 (15_UART_RTS), BT2.16 (16_UART_CTS), BT2.17 (17_USB_D+), BT2.18 (18_USB_D-), BT2.28, BT2.29, BT2.31, BT2.32, BT2.33, BT2.34, C1.2, C2.2, C3.2, C4.2, C5.2, C6.2, C8.2, C9.2, C10.2, C11.-, C12.-, C13.2, C14.2, C15.2, C16.2, C17.2, C18.2, C19.2, C21.2, C22.2, C-1.-, C-2.-, IC1.12 (VSSA), IC1.18 (VSS), IC1.31 (VSS), IC1.47 (VSS), IC1.63 (VSS), LED_GREEN.2, LED_RED.2, LED_YELLOW.2, LM1117-1.ADJ/GND, LM2674-5V-BUCK1.6 (6-GND), R14.1, R16.1, R18.2, R19.2, R21.1, R25.1, SCHOTTY-SS12-1.+, SCHOTTY-SS12-2.+, SKRUVPLINT_2P1.4, SKRUVPLINT_2P3.4, SKRUVPLINT_2P5.4, SMDLED1.2, SMDLED2.2, SMOOTHER1.2, SMOOTHER2.2, SV1.3, U1.11 (FSYNC), U1.18 (GND), U1.20 (RESV), U2.6 (GND), U2.9 (GND), U2.20 (EXTINT), U2.23 (GND), U2.24 (GND), U2.25 (GND), U2.26 (GND), U2.27 (GND), U2.28 (GND), U2.29 (GND), U2.30 (GND), U$1.P$4 (VCC-), U$2.P$1_A, U$4.SOURCE
GPS_NRST: IC1.34 (PB13), U2.1 (NRST)
GPS_TOGGLE: IC1.35 (PB14), U2.19 (ON_OFF)
IMU_INT: IC1.28 (PB2), U1.12 (INT)
LED_GREEN: IC1.52 (PC11), R27.2
LED_RED: IC1.51 (PC10), R28.2
LED_YELLOW: IC1.53 (PC12), R26.2
MCURX1_BT1TX: BT1_DEBUGSW.T2, IC1.43 (PA10)
MCURX2_BT2TX: DIPSWITCH3.T2, IC1.17 (PA3)
MCURX6_GPSTX: IC1.45 (PA12), U2.21 (TXO)
MCUTX1_BT1RX: BT1_DEBUGSW.T1, IC1.42 (PA9)
MCUTX2_BT2RX: DIPSWITCH3.T1, IC1.16 (PA2)
MCUTX6_GPSRX: IC1.44 (PA11), U2.22 (RXO)
unnamed: BT1.21 (21_GPIO5), R1.2
unnamed: DIPSWITCH1.B1, R2.1
unnamed: DIPSWITCH1.B2, R3.1
unnamed: DIPSWITCH1.B3, R4.1
unnamed: DIPSWITCH1.B4, R5.1
unnamed: BT2.21 (21_GPIO5), R6.2
unnamed: DIPSWITCH2.B1, R7.1
unnamed: DIPSWITCH2.B2, R8.1
unnamed: DIPSWITCH2.B3, R9.1
unnamed: DIPSWITCH2.B4, R10.1
unnamed: R6.1, SMDLED2.1
unnamed: R1.1, SMDLED1.1
unnamed: R11.2, R33.1, U$1.P$1 (1OUT)
unnamed: U$1.P$2 (1IN-), U$1.P$6 (2IN-), U$2.P$2_B
unnamed: R12.1, R35.2, U$1.P$7 (2OUT)
unnamed: R29.1, U2.7 (GPIO6)
unnamed: R30.1, U2.18 (I2C_DIO)
unnamed: BSH201_1.GATE, R17.1
unnamed: C6.1, U1.10 (REGOUT)
unnamed: R18.1, U1.7 (AUX_CL)
unnamed: R19.1, U1.21 (AUX_DA)
unnamed: C7.1, LM2674-5V-BUCK1.1 (1-CB)
unnamed: R20.2, U$3.DRAIN
unnamed: R22.2, U$4.GATE
unnamed: R23.1, U$3.GATE, U$4.DRAIN
unnamed: C8.1, IC1.30 (VCAP1)
unnamed: IC1.60 (BOOT0), R25.2
unnamed: C15.1, IC1.5 (OSC_IN), Q2.2
unnamed: C16.1, IC1.6 (OSC_OUT), Q2.1
unnamed: LED_YELLOW.1, R26.1
unnamed: LED_GREEN.1, R27.1
unnamed: R31.1, U2.17 (I2C_CLK)
unnamed: LED_RED.1, R28.1
unnamed: R32.2, U$1.P$3 (1IN+)
unnamed: R34.1, U$1.P$5 (2IN+)
NRST: IC1.7 (NRST), R24.2, SV1.5
OPTO1_DIODE: IC1.24 (PC4), R13.2, SKRUVPLINT_2P1.3
OPTO1_OUT: IC1.38 (PC7), R11.1, SMOOTHER1.1
OPTO1_TRAN: IC1.25 (PC5), R14.2, R32.1, R33.2, SKRUVPLINT_2P2.3
OPTO2_DIODE: IC1.26 (PB0), R15.2, SKRUVPLINT_2P3.3
OPTO2_OUT: IC1.37 (PC6), R12.2, SMOOTHER2.1
OPTO2_TRAN: IC1.27 (PB1), R16.2, R34.2, R35.1, SKRUVPLINT_2P4.3
OPTO_TOGGLE: IC1.36 (PB15), R17.2
OPTO_VDD: BSH201_1.DRAIN, C3.1, R13.1, R15.1, SKRUVPLINT_2P2.4, SKRUVPLINT_2P4.4, U$1.P$8 (VCC+), U$2.P$3_C
SPI1_MISO: IC1.22 (PA6), U1.9 (AD0/SDO)
SPI1_MOSI: IC1.23 (PA7), U1.24 (SDA/SDI)
SPI1_NSS: IC1.20 (PA4), U1.22 (NCS)
SPI1_SCK: IC1.21 (PA5), U1.23 (SCL/SCLK)
SWCLK: IC1.49 (PA14), SV1.2
SWDIO: IC1.46 (PA13), SV1.4
SWO: IC1.55 (PB3), SV1.6
VOUT: C7.2, L-1.1, LM2674-5V-BUCK1.8 (8-VSW), SCHOTTY-SS12-1.-

Notes on the sheet:
GPIO4 = FACTORY RESET GPIO3 = AUTO PAIRING GPIO6 = AUTO MASTER/DTR GPIO7 = BAUDRATE
POWER
9V BAT IN
ON/OFF Ska flyta för att vara på!
500 mA @ 5V
Bluetooth 1
Bluetooth 2
Sensor failure measurement
Opto height sensor
IMU
GPS
Decoupling
