HTheolin/Dinghy_old/D7039E och E7025E/Hårdvara/Schematics-Layouts/Schematics/Prototyp 2/Rudder - Prototype 2.sch

## EAGLE design D7039E och E7025E/Hårdvara/Schematics-Layouts/Schematics/Prototyp 2/Rudder - Prototype 2.sch (2017-08-30)

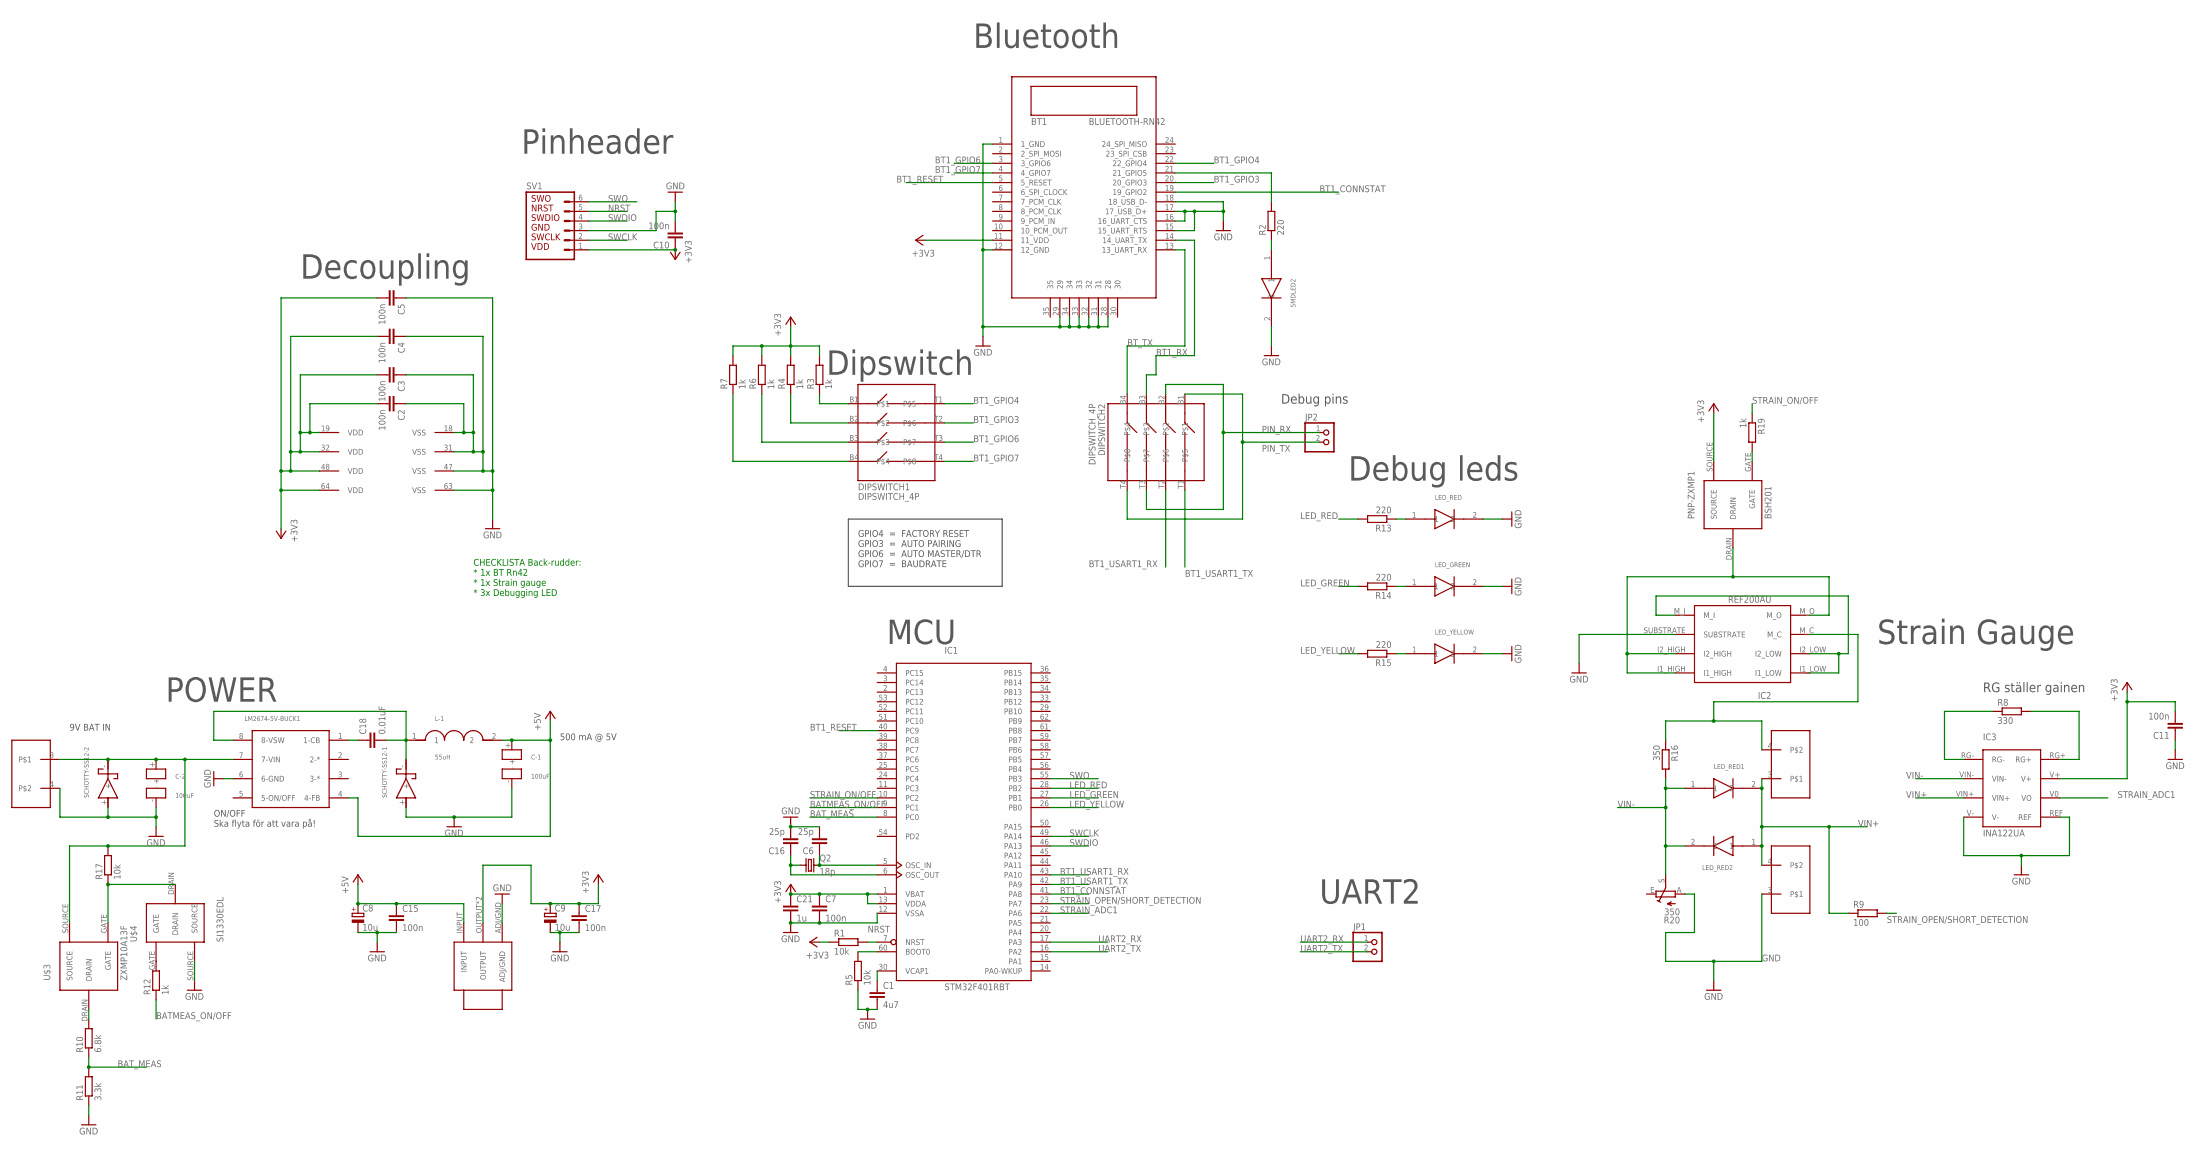
[picture p134: schematic Rudder - Prototype 2.sch]

Parts:
BT1: BLUETOOTH-RN42; RN42
C1: 4u7; C0805
C2, C3, C4, C5, C7, C10, C11, C15, C17: 100n; C0805
C6, C16: 25p; C0805
C8, C9: 10u; 153CLV-0505
C18: 0.01uF; C0805
C21: 1u; C0805
C-1, C-2: 100uF; CAP-6.3MM-DIA
DIPSWITCH1, DIPSWITCH2: DIPSWITCH_4P; DIPSWITCH4P
IC1: STM32F401RBT; LQFP64
IC2: REF200AU; SOIC(8)
IC3: INA122UA; S0-8
JP1, JP2: PINHD-1X2; 1X02
L-1: 55uH; INDUCTOR
LED_GREEN: SMD_LED; SMD_LED_CUSTOM
LED_RED, LED_RED1, LED_RED2: SMD_LED; SMD_LED_CUSTOM
LED_YELLOW: SMD_LED; SMD_LED_CUSTOM
LM1117-1: LM1117
LM2674-5V-BUCK1: LM2674-5VBUCK; LM2674
PNP-ZXMP1: BSH201; P-CHANNEL
Q2: 18p; HC49UP
R1, R5, R17: 10k; R0805
R2, R13, R14, R15: 220; R0805
R3, R4, R6, R7, R12, R19: 1k; R0805
R8: 330; R0805
R9: 100; R0805
R10: 6.8k; R0805
R11: 3.3k; R0805
R16: 350; R0805
R20: 350; S64W
SCHOTTY-SS12-1, SCHOTTY-SS12-2: SCHOTTY-SS12; SCHOTTY
SKRUVPLINT_2P1, SKRUVPLINT_2P2, SKRUVPLINT_2P3: SKRUVPLINT_2P
SMDLED2: SMD_LED; SMD_LED_CUSTOM
SV1: MA06-1
U$3: ZXMP10A13F; P-CHANNEL
U$4: SI1330EDL; SOT-323

Connections:
+3V3: BT1.11 (11_VDD), C2.2, C3.2, C4.2, C5.2, C7.1, C9.+, C10.1, C11.2, C17.1, C21.1, IC1.1 (VBAT), IC1.13 (VDDA), IC1.19 (VDD), IC1.32 (VDD), IC1.48 (VDD), IC1.64 (VDD), IC3.V+, LM1117-1.OUTPUT, PNP-ZXMP1.SOURCE, R1.1, R3.2, R4.2, R6.2, R7.2, SV1.1
+5V: C8.+, C15.1, C-1.+, L-1.2, LM1117-1.INPUT, LM2674-5V-BUCK1.4 (4-FB)
BATMEAS_ON/OFF: IC1.9 (PC1), R12.1
BATSUP: C-2.+, LM2674-5V-BUCK1.7 (7-VIN), R17.2, SCHOTTY-SS12-2.-, SKRUVPLINT_2P2.3, U$3.SOURCE
BAT_MEAS: IC1.8 (PC0), R10.1, R11.2
BT1_CONNSTAT: BT1.19 (19_GPIO2), IC1.41 (PA8)
BT1_GPIO3: BT1.20 (20_GPIO3), DIPSWITCH1.T2
BT1_GPIO4: BT1.22 (22_GPIO4), DIPSWITCH1.T1
BT1_GPIO6: BT1.3 (3_GPIO6), DIPSWITCH1.T3
BT1_GPIO7: BT1.4 (4_GPIO7), DIPSWITCH1.T4
BT1_RESET: BT1.5 (5_RESET), IC1.40 (PC9)
BT1_RX: BT1.14 (14_UART_TX), DIPSWITCH2.B3
BT1_USART1_RX: DIPSWITCH2.T2, IC1.43 (PA10)
BT1_USART1_TX: DIPSWITCH2.T1, IC1.42 (PA9)
BT_TX: BT1.13 (13_UART_RX), DIPSWITCH2.B4
GND: BT1.1 (1_GND), BT1.12 (12_GND), BT1.15 (15_UART_RTS), BT1.16 (16_UART_CTS), BT1.17 (17_USB_D+), BT1.18 (18_USB_D-), BT1.28, BT1.29, BT1.31, BT1.32, BT1.33, BT1.34, C1.2, C2.1, C3.1, C4.1, C5.1, C6.2, C7.2, C8.-, C9.-, C10.2, C11.1, C15.2, C16.2, C17.2, C21.2, C-1.-, C-2.-, IC1.12 (VSSA), IC1.18 (VSS), IC1.31 (VSS), IC1.47 (VSS), IC1.63 (VSS), IC2.SUBSTRATE, IC3.REF, IC3.V-, LED_GREEN.2, LED_RED.2, LED_YELLOW.2, LM1117-1.ADJ/GND, LM2674-5V-BUCK1.6 (6-GND), R5.1, R11.1, R20.A, SCHOTTY-SS12-1.+, SCHOTTY-SS12-2.+, SKRUVPLINT_2P2.4, SKRUVPLINT_2P3.3, SMDLED2.2, SV1.3, U$4.SOURCE
LED_GREEN: IC1.27 (PB1), R14.2
LED_RED: IC1.28 (PB2), R13.2
LED_YELLOW: IC1.26 (PB0), R15.2
unnamed: C1.1, IC1.30 (VCAP1)
unnamed: IC1.60 (BOOT0), R5.2
unnamed: LED_RED.1, R13.1
unnamed: BT1.21 (21_GPIO5), R2.2
unnamed: DIPSWITCH1.B1, R3.1
unnamed: DIPSWITCH1.B2, R4.1
unnamed: DIPSWITCH1.B3, R6.1
unnamed: C6.1, IC1.5 (OSC_IN), Q2.2
unnamed: C16.1, IC1.6 (OSC_OUT), Q2.1
unnamed: DIPSWITCH1.B4, R7.1
unnamed: R2.1, SMDLED2.1
unnamed: IC2.I1_HIGH, IC2.I2_HIGH, IC2.M_O, PNP-ZXMP1.DRAIN
unnamed: IC3.RG-, R8.1
unnamed: IC3.RG+, R8.2
unnamed: C18.1, LM2674-5V-BUCK1.1 (1-CB)
unnamed: LED_GREEN.1, R14.1
unnamed: LED_YELLOW.1, R15.1
unnamed: PNP-ZXMP1.GATE, R19.2
unnamed: IC2.M_C, R16.1, SKRUVPLINT_2P1.4
unnamed: R10.2, U$3.DRAIN
unnamed: IC2.I1_LOW, IC2.I2_LOW, IC2.M_I
unnamed: R12.2, U$4.GATE
unnamed: R17.1, U$3.GATE, U$4.DRAIN
NRST: IC1.7 (NRST), R1.2, SV1.5
PIN_RX: DIPSWITCH2.B2, DIPSWITCH2.T3, JP2.1
PIN_TX: DIPSWITCH2.B1, DIPSWITCH2.T4, JP2.2
STRAIN_ADC1: IC1.22 (PA6), IC3.V0 (VO)
STRAIN_ON/OFF: IC1.10 (PC2), R19.1
STRAIN_OPEN/SHORT_DETECTION: IC1.23 (PA7), R9.2
SWCLK: IC1.49 (PA14), SV1.2
SWDIO: IC1.46 (PA13), SV1.4
SWO: IC1.55 (PB3), SV1.6
UART2_RX: IC1.17 (PA3), JP1.1
UART2_TX: IC1.16 (PA2), JP1.2
VIN+: IC3.VIN+, LED_RED1.2, LED_RED2.1, R9.1, SKRUVPLINT_2P1.3, SKRUVPLINT_2P3.4
VIN-: IC3.VIN-, LED_RED1.1, LED_RED2.2, R16.2, R20.S
VOUT: C18.2, L-1.1, LM2674-5V-BUCK1.8 (8-VSW), SCHOTTY-SS12-1.-

Notes on the sheet:
GPIO4 = FACTORY RESET GPIO3 = AUTO PAIRING GPIO6 = AUTO MASTER/DTR GPIO7 = BAUDRATE
CHECKLISTA Back-rudder: * 1x BT Rn42 * 1x Strain gauge * 3x Debugging LED
Bluetooth
Debug leds
Strain Gauge
RG ställer gainen
MCU
Decoupling
Pinheader
Dipswitch
UART2
POWER
9V BAT IN
ON/OFF Ska flyta för att vara på!
500 mA @ 5V
Debug pins
