HTheolin/Dinghy_old/D7039E och E7025E/Hårdvara/Schematics-Layouts/CubeMX diagram/Prototype 2/MCU_mainboard PROTOTYP 2.ioc

Mcu.UserName=STM32F401RETx
PA10.GPIO_Label=BT1_USART1RX
PA10.Signal=USART1_RX
PA11.GPIO_Label=GPS_USART6TX
PA11.Signal=USART6_TX
PA12.GPIO_Label=GPS_USART6RX
PA12.Signal=USART6_RX
PA13.Signal=SYS_JTMS-SWDIO
PA14.Signal=SYS_JTCK-SWCLK
PA2.GPIO_Label=BT2_USART2TX
PA2.Signal=USART2_TX
PA3.GPIO_Label=BT2_USART2RX
PA3.Signal=USART2_RX
PA4.Signal=SPI1_NSS
PA5.Signal=SPI1_SCK
PA6.Signal=SPI1_MISO
PA7.Signal=SPI1_MOSI
PA8.GPIO_Label=BT1_CONNSTAT
PA8.Signal=GPIO_Input
PA9.GPIO_Label=BT1_USART1TX
PA9.Signal=USART1_TX
PB0.GPIO_Label=Opto 2 Diode Failure
PB0.Signal=ADCx_IN8
PB1.GPIO_Label=Opto 2 Transistor Failure
PB1.Signal=ADCx_IN9
PB13.GPIO_Label=GPS_NRST
PB13.Signal=GPIO_Output
PB14.GPIO_Label=GPS_TOGGLE
PB14.Signal=GPIO_Output
PB15.GPIO_Label=OPTO_TOGGLE
PB15.Signal=GPIO_Output
PB2.GPIO_Label=MPU_INT
PB2.Signal=GPIO_Input
PB3.Signal=SYS_JTDO-SWO
PC0.GPIO_Label=BAT_MEAS
PC0.Signal=ADCx_IN10
PC10.GPIO_Label=LED_RED
PC10.Signal=GPIO_Output
PC11.GPIO_Label=LED_GREEN
PC11.Signal=GPIO_Output
PC12.GPIO_Label=LED_YELLOW
PC12.Signal=GPIO_Output
PC2.GPIO_Label=BT2_RESET
PC2.Signal=GPIO_Output
PC3.GPIO_Label=BT2_CONNSTAT
PC3.Signal=GPIO_Input
PC4.GPIO_Label=Opto 1 Diode Failure
PC4.Signal=ADCx_IN14
PC5.GPIO_Label=Opto 1 TransistorFailure
PC5.Signal=ADCx_IN15
PC6.GPIO_Label=OPTO2_OUT
PC6.Signal=GPIO_Input
PC7.GPIO_Label=OPTO1_OUT
PC7.Signal=GPIO_Input
PC8.GPIO_Label=BATMEAS_TOGGLE
PC8.Signal=GPIO_Output
PC9.GPIO_Label=BT1_RESET
PC9.Signal=GPIO_Output
